miketaz100/project-scratch/14-build/electronics/CONFLICTS.md

# ELECTRONICS + FIRMWARE — CONFLICTS with SYSTEM-SPEC-v3 (proposals, not edits)

**Package:** 14-build/electronics · **Date:** 2026-10-02 · **Rule:** SYSTEM-SPEC-v3.md is not edited. Each item names the spec line, what I found, what I built, and what the owner must decide. Severity: **S1** = blocks a stage gate or a safety claim, **S2** = changes a number or a part, **S3** = wording/bookkeeping.

| ID | Sev | Spec reference | Finding | What this package does now | Decision needed (owner) |
|---|---|---|---|---|---|
| **E-C1** | **S1** | §5.1 M13 (deck stops R 48) + M14 (yoke posts R 30), §4.4 pretension 1.5 N, §4.5 amplitude ±16.5 | **The tendon geometry cannot hold the block at the rim.** With stops at R 48 and posts at R 30 the "effective anchors" (stop − post) sit on R 18, so the three cables can only hold the block with positive tension inside a triangle of inradius 9 mm. `TendonIK.audit()` finds a positive-tension reach of **9.1 mm** in the worst direction (toward the gap between two stops) and a predicted tension of **−3.9 N** (i.e. a slack cable) at the rim with the modelled 1.2 N rim reaction. The C5 lift needs |d| ≥ 13.7 in every direction. | IK and checker run on any geometry (values live in `~/sp1v3/config.json`). The scorer **audits the geometry at boot and FAULTs** if reach < 16.5 mm or predicted tension leaves 0.3–3.3 N (`geometry_audit: fault`). Unit test `test_tendons_hold_the_block_with_positive_tension_everywhere` documents the failure and two passing alternatives. | PAD + DRIVE BOX + CAD: pick a geometry that passes the audit. Passing examples: **(a) stops R 70, posts R 15, pretension 2.0 N per cable** (tension 0.39–3.10 N over the whole workspace incl. rim reaction); **(b) stops R 65, posts R 10, 2.0 N**. Alternatively crossed cables (stop at 90° to a post at 270°) give effective anchors at R 78. Re-run `python3 -c "from sp1v3.ik import *; ..."` (electronics.md §8.2) on the chosen numbers. |
| **E-C2** | **S1** | §5.4 E8, §5.5 "CB1 I²C → ADS1115", §8.5 "CB1 GPIO → REFLEX latch" | **The CB1's I²C is not reliably available on the M8P's 40-pin header.** BTT's own CB1 notes release a user I²C only as `overlays=i2c0` on PI5/PI6 "for BIGTREETECH Pi1 / CB1 eMMC"; the header pins 3/5 map to CB1 GPIOs that are not a hardware TWI (one independent test managed only bit-banged I²C with poor reliability). CB1 V2.1 GPIOs are also 1.8 V. | Tensions are read by a **$4 Raspberry Pi Pico (RP2040)** on a CB1 USB port: three Halls → GP26–28 ADC (4× averaged, 500 frames/s) → USB → `reflexd`. The Pico also drives **PICO_OK** into the latch logic (heartbeat-gated, fail-safe low). No ADS1115 is needed; if V-T5 (≤ 0.2 N resolution) fails on the RP2040 ADC, an ADS1115 goes on the Pico's own hardware I²C (GP4/GP5). | ELECTRONICS (this WP) — accept the Pico. BOM: −ADS1115 ($3), +Pico ($4). |
| **E-C3** | S2 | §4.11 "E-stop / lever / reflex latch → rail dead < 5 ms (relay drop-out)" | Panasonic SF safety relays: **release time max 20 ms** (datasheet, nominal coil voltage, no diode). After release, ACT-24 still holds ≈ 1.5 mF of driver/bulk capacitance. | K1 has a diode + 18 V Zener coil clamp (fast release) and its **NC contact switches a 4.7 Ω 5 W bleeder** across ACT-24. Analysis (electronics.md §6): rail < 4 V in **≈ 18 ms typ / ≤ 35 ms worst**; valve coils de-energised ≤ 31 ms worst; nails vented (C3) ≤ 131 ms worst; pad retracted ≤ 181 ms worst. | SYSTEM ARCHITECT: restate §4.11 as "≤ 35 ms to rail < 4 V, measured at A0" (C4's 50 ms trip criterion is unaffected: the trip itself is < 0.2 ms comparator / ≤ 9 ms reflexd). |
| **E-C4** | S2 | §8.1 "Klipper's motion queue runs up to ≈ 2 s ahead"; §8.2 step 6 + "INSTANTANEOUS_CORNER_VELOCITY raised" (V-K1) | Klipper source (toolhead.py, checked 2026-10-02): `BUFFER_TIME_HIGH = 1.0` s, so the queue is ≈ 1 s, not 2 s. With `kinematics: none` every `G1 A B C` is an **extra-axis-only move**: Klipper skips junction blending for such moves (`calc_junction` returns early), uses the max axis distance for timing (`move_d = max |Δaxis|`, duration = move_d / (F/60)) and the per-axis accel. `INSTANTANEOUS_CORNER_VELOCITY` therefore has no effect. | `printer.cfg`: `accel: 0` on the manual steppers; axes registered with `LIMIT_ACCEL=100000000 LIMIT_VELOCITY=250`, so every 5 ms segment runs at constant speed and the **host owns the velocity profile**. The streamer computes F = 60·max|Δl|/Δt; unit test checks the streamed durations add up to the plan within 1 %. Queue kept ≤ 0.5 s (unchanged). | None for the architecture (C18 holds). V-K1 at S0 now tests "no stalls, timing within 1 %" (`python3 -m sp1v3.benchtest stream`). |
| **E-C5** | S2 | §5.5 PIN A / PALM / dumps as `[output_pin]`; spec mentions `maximum_mcu_duration` on output_pin-type objects | Klipper: `[output_pin]` updates on one pin are spaced ≥ 100 ms (`MIN_SCHEDULE_TIME = 0.100`), and `maximum_mcu_duration` is now **deprecated on output_pin**; it exists on `[pwm_tool]` (max 3 s, requires start value = shutdown value). | All valves and dumps are `[pwm_tool]` with `maximum_mcu_duration: 2.0` (MCU shuts down if klippy stops refreshing). PIN B stays a 25 Hz pwm_tool. | None. |
| **E-C6** | S2 | §4.4 "VREF ≤ 0.35 A (≤ 5 N cable pull)"; §1 C15 | 17HS08-1004S: 13 N·cm at 1.0 A. At 0.35 A ≈ 4.6 N·cm → on a Ø 12 drum (r 6 mm) **≈ 7.6 N** of cable pull, not 5 N. A true 5 N cap needs ≈ 0.23 A, which leaves little margin over the drum-side tension (up to ≈ 2.6× the block-side tension through a 2π housing at μ 0.15). | VREF set for **0.35 A peak (VREF = 0.35 V on BTT TMC2209 V1.3, I_peak = VREF)** as the spec says; it is treated as a stall/heat cap. The 2.0 N magnetic coupling remains the tangential cap. | SYSTEM ARCHITECT: change the wording to "VREF 0.35 A ≈ 7.6 N at the drum (stall cap)" or ask DRIVE BOX for a larger drum. |
| **E-C7** | S2 | §5.4 E5 "helmet loop 3.3 V, 1 mA logic loop … gates the rail relay" | A 3.3 V logic loop needs an active element (transistor/opto) between the loop and K1's coil; a shorted transistor would silently bypass the loop. | The helmet loop (lanyard pogo + head-present switch) is **wired directly in K1's 24 V coil chain** (≈ 15 mA + 2 mA sense). Passive, fail-open, no semiconductor. 24 V DC is within red line 5. Nothing on the head draws power (only a switch). | HALO: pogo pins and head switch rated ≥ 50 mA at 24 V DC (all listed parts are). SYSTEM ARCHITECT: update E5 text. |
| **E-C8** | S2 | §5.4 E10/E9; §7.8 "Host (CB1) hang → maximum_mcu_duration … ≤ 1 s" | `maximum_mcu_duration` only catches a dead **klippy**; Klipper keeps refreshing the PWM if only `scorer.py` hangs. | Added a **host heartbeat**: `SP1_HEARTBEAT` every 0.25 s re-arms a `[delayed_gcode]` that runs **M112** after 1 s. Scorer hang → M112 → MCU shutdown → watchdog PWM stops → rail open ≤ 1.3 s. reflexd hang → Pico drops PICO_OK after 250 ms → latch sets. MCU hang → STM32 IWDG reset (~0.5 s) → pin low → charge pump decays ≤ 45 ms. | SYSTEM ARCHITECT: §7.8 host-hang bound ≤ 1.3 s. |
| **E-C9** | S2 | §4.5 CIRCLE "R 9–13" with "R + e ≥ 14.5 and R − e ≤ 8.5" and §8.3 "|d| > 16.5 rejected" | R = 13 needs e ≥ 4.5 (to land) but then R + e = 17.5 > 16.5 mm: **no valid circle at R 13**. Also the 30°/50 ms heading rule caps circles at **f ≤ 1.5 Hz** (precession adds to the turn rate). | Limits: R 9–12.5, f_circle ≤ 1.5 Hz; planner clamps e to [max(3, R−8.5, 14.5−R), 16.5−R]. Checker rejects the R 13 circle (unit test). | SYSTEM ARCHITECT: update §4.5 ranges. |
| **E-C10** | S2 | §5.4 E7 "GX12 8-pin" | GX12 aviation connectors are commonly 2–7 pin (8-pin listings are rare and inconsistent); GX16 is stocked in 2–10 pins. | Hand controller on **GX16-8** (10-pack $17.99). E-stop and helmet loop stay GX12-4. | BOM: update. |
| **E-C11** | S2 | §5.5 resource map (pumps on FAN0/FAN1, dumps on HE3/HB, MODE on ADS1115 ch 3, knobs on "spare TH via ADC expansion") | I own this map. Revised for current ratings and pin reality: pumps on **HE3** (5.5 A) and **FAN3** (1 A, palm pump ≤ 0.8 A); dumps on **FAN0/FAN1**; HB unused (its flyback diode returns to the BED IN rail); knobs on the **FWS header ADCs PC0/PF10**; MODE as a 4-step resistor ladder on **TB (PB1)** read by four analog `gcode_button`s; chime on a logic GPIO (PC12) so it sounds with the rail off. Closes V-E3. | electronics.md §4 is the new map. Pad-2 provisions: FAN4 = PALM B valve, HB = PALM B dump (feed BED IN from ACT-12 at install), S_palm B on an ADS1115 at the Pico. | None (FYI DRIVE BOX: palm pump ≤ 0.8 A at 12 V). |
| **E-C12** | **S1** (wiring hazard) | §7.1 "Nothing in the logic domain can energise ACT-24: the M8P only sinks the − side" | True only if (a) no load is ever wired to an HE "+" terminal (that pin is **VBB, unswitched 24 V**), and (b) every FAN output used for an ACT-12 load has its **VFAN jumper on VIN (24 V)**: each FAN output has an on-board flyback diode from the MOSFET drain to VFAN; with VFAN at 5 V a 12 V valve would be half-energised through that diode with the rail off. | Wiring table marks every "+" pin "DO NOT USE — tape over"; bring-up step A0-7 "dead-rail output test" (all outputs commanded ON with the lever released: every load terminal must read 0 V) is a hard gate. FAN2 (watchdog) VFAN jumper = 12 V. | TEST PROTOCOLS: add A0-7 to the A0 sheet. |
| **E-C13** | S3 | §7.1 weld check "rail must fall within 50 ms of every lever release" | The Klipper status stream updates ≈ 4×/s, so a 50 ms software timing check is not meaningful. | Weld check = **force-guided NC contact state**: K1's NC aux must read closed whenever the coil is off (SELFTEST, SAFE, PAUSED) and the rail must not be up while the lever or e-stop sense is open (> 150 ms → FAULT, "press the E-STOP"). The 50 ms timing is measured once at A0 with the logic analyser. | TEST PROTOCOLS: A0 sheet. |
| **E-C14** | S3 | §5.4 E9 latch "SET by any comparator or by CB1 GPIO" | — | Latch SET (74HC74 /PRE) is a wired-AND of: 6 LM393 window outputs (3 cables × slack/over) + **M8P_OK low** (scorer FAULT, Klipper shutdown, boot) + **PICO_OK low** (reflexd trip/heartbeat loss, Pico dead). The box cannot arm unless both host services are alive and agree. Power-up state is tripped. | None. |
| **E-C15** | S3 | §4.4 comparator "ΔT > +1.8 N or < −1.2 N from pretension" | With any geometry that passes E-C1 the predicted operating tensions span ≈ 0.4–3.1 N; a relative window around 1.5 N would trip on the rim. | Absolute window **0.2 N (slack) … 3.6 N**, set per channel on trimpots after the A3 tension calibration; reflexd duplicates it in firmware. Re-derive from `ik.audit()` once E-C1 is settled. | DRIVE BOX/ELECTRONICS at A3. |
| **E-C16** | S3 | §8.2 "host keeps ≤ 0.5 s of moves queued", §4.11 "score change → motion ≤ 0.5 s" | CIRCLE tokens are 2 revolutions (≈ 1.7–2.5 s) because each token starts and ends at rest on the rim. | Mode/knob changes apply at the next token boundary: ≤ 0.5 s in PLINE/LINE/CHORD/D-PATH, ≤ 2.5 s in CIRCLE. | None (accept), or shorten circle tokens to 1 rev (an extra rim stop per rev). |
| **E-C17** | S3 | §2.1 "ADS1115 for the three cable tensions" in the drive-box list and §13 cost line | See E-C2. | Cost line: Pico $4 replaces ADS1115 $3; safety board (optos, LM393 ×4, 74HC74, 2N7000 ×3, bleeder) ≈ $15 [est]. | BOM. |

## Verified facts this package relied on (closing V-items)

| V-item | Result | Source |
|---|---|---|
| V-E1 M8P motor-power input | **Closed.** Separate "Motor Power" terminal = HV input; each driver socket has a 3-pin **HV / VM / VBB** jumper selecting its supply. Jumper motors 1–3 to **HV**, leave sockets 4–8 empty with no jumper. Driver input "24V, HV (24–60V) Selectable". | BTT M8P V2.0 pin-out PNG and user manual (GitHub bigtreetech/Manta-M8P, V2.0) |
| V-E2 low-side outputs | **Closed with a caveat (E-C12).** HE0–3: N-MOSFET (AP65N06NF) source to GND, connector pin 1 = VBB, pin 2 = drain, SS54 flyback drain→VBB. FAN0–4: ES3400 N-MOSFET, + pin = VFAN (5/12/24 V jumper). Common ground required (it is). | M8P V2.0 schematic PDF (same repo) |
| V-E3 ADC count | **Closed.** TH0–TH3 + TB (5) + FWS PC0/PF10 (2) = 7 ADCs: 4 pressures, 2 knobs, MODE ladder. | BTT generic-bigtreetech-manta-m8p-V2_0.cfg (`hall_filament_width_sensor adc1: PC0, adc2: PF10`), pin-out PNG |
| V-E4 CB1 GPIO / I²C | **Closed negatively → E-C2.** | BTT CB1 readme (overlays `i2c0` on PI5/PI6), learningtopi CB1 notes |
| V-K1 GCODE_AXIS with kinematics none | Feature exists and is documented; timing semantics from source (E-C4). Bench test still required at S0. | Klipper G-Codes.md `MANUAL_STEPPER … GCODE_AXIS`; toolhead.py, manual_stepper.py (master, 2026-10-02) |
| V-K3 maximum_mcu_duration | pwm_tool only, 0.5–3.0 s, start = shutdown value; MCU shuts down if not refreshed. Bench test at A0 still required. | Config_Reference.md `[pwm_tool]`; pwm_tool.py, mcu.py (`MAX_NOMINAL_DURATION = 3.0`) |
