miketaz100/project-scratch/14-build/pad/cad/pad_geom_report2.txt

=== 4. DOME POCKETS (ZD = 91.5 mm ball centre, RD 38.0, ball 0 6.35) ===
 max dome travel 27.96 mm (cage |d| 18.0); pocket radius incl. ball 31.13; half spacing 32.91; spare 1.77 mm
 steepest ceiling slope on any dome path 48.1 deg -> rim reaction <= 1.11 x vertical dome load
 ceiling z range 92.96 .. 105.30 (home ball top 94.67)
 min block-feature-to-ceiling gap +1.87 mm at pose (-16.7, 3.0, 1) (target >= 1.5)
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
