miketaz100/project-scratch/14-build/halo/cad/stl/_assembly_preview.stl

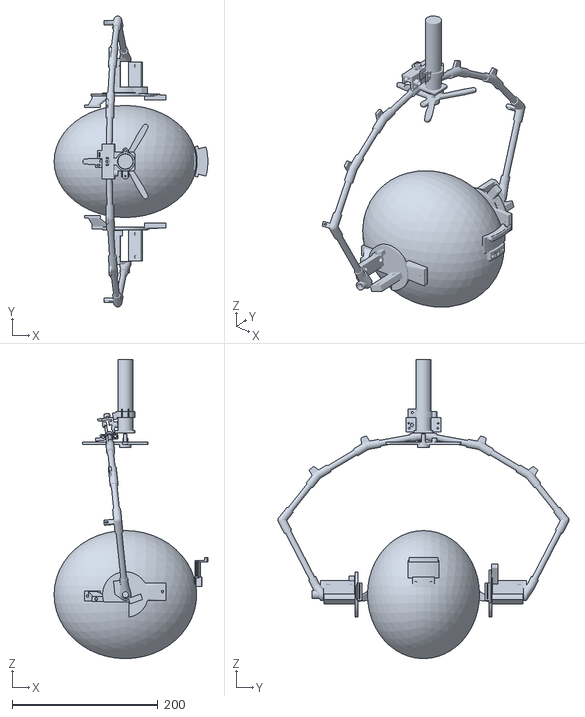
[picture p1: CAD file, 2026-10-02]
14-build/halo/cad/stl/_assembly_preview.stl
211.4 x 399.9 x 411.2
