miketaz100/project-scratch/05-engineering/cad/frame/stl/p46_tip_pull_clip.stl

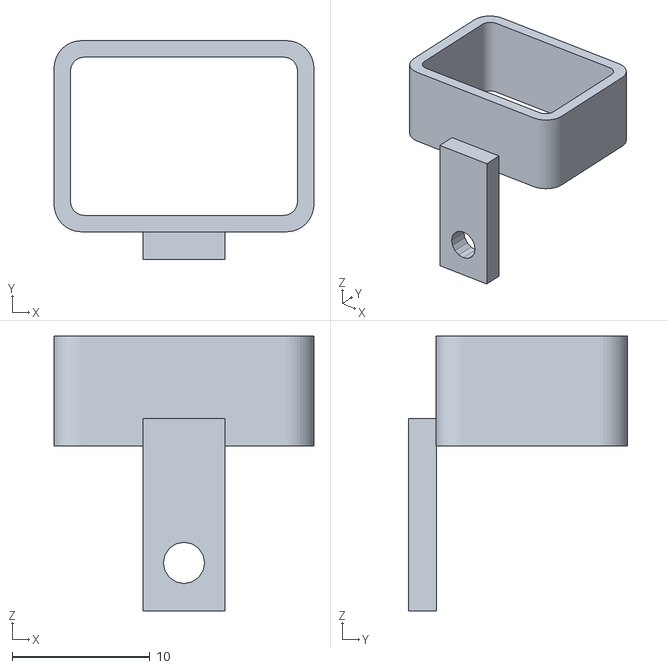
[picture p2: CAD file, 2026-10-01]
05-engineering/cad/frame/stl/p46_tip_pull_clip.stl
18.9 x 15.9 x 20.0
