miketaz100/project-scratch/05-engineering/cad/tips/stl/tm1_seam_sleeve.stl

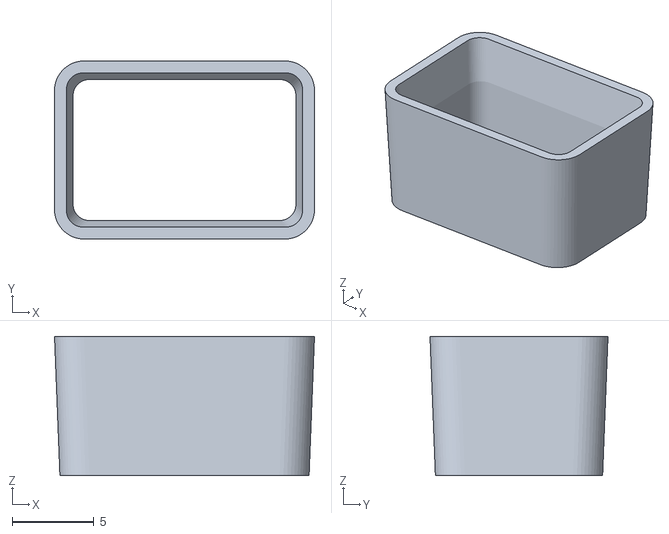
[picture p3: CAD file, 2026-10-01]
05-engineering/cad/tips/stl/tm1_seam_sleeve.stl
15.9 x 10.9 x 8.50
