miketaz100/project-scratch/14-build/drivebox/cad/stl/DB06_bulkhead.stl

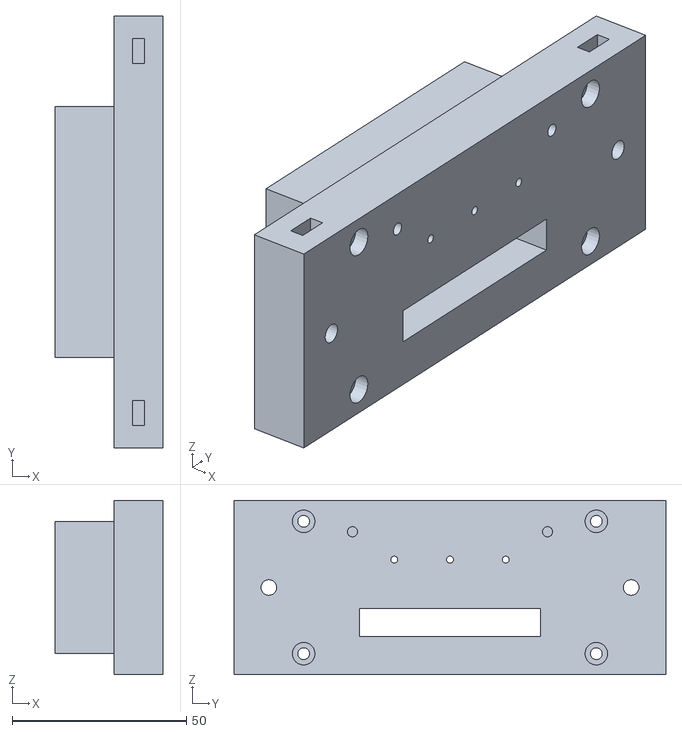
[picture p4: CAD file, 2026-10-02]
14-build/drivebox/cad/stl/DB06_bulkhead.stl
31.0 x 124.0 x 50.0
