miketaz100/project-scratch/14-build/halo/cad/stl/H17_exit_clamp.stl

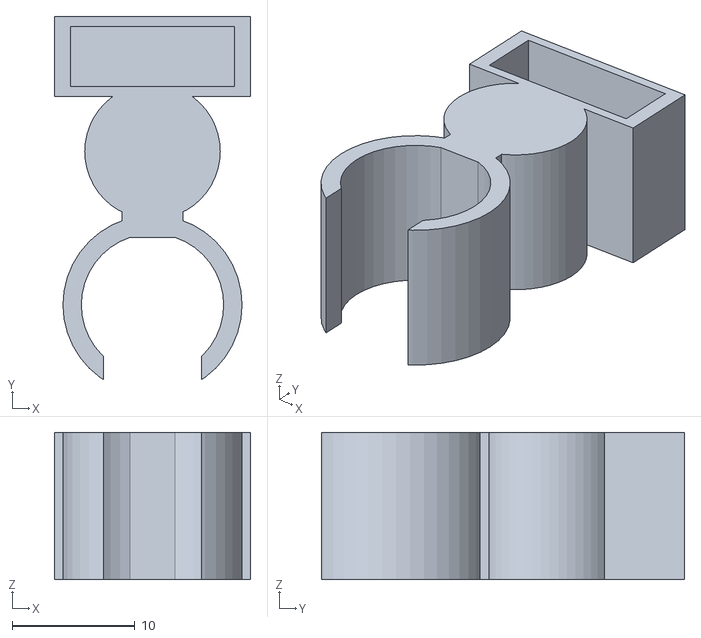
[picture p5: CAD file, 2026-10-02]
14-build/halo/cad/stl/H17_exit_clamp.stl
16.0 x 29.6 x 12.0
