miketaz100/project-scratch/14-build/halo/cad/stl/variant_small_hinge/H01R_hub_plate.stl

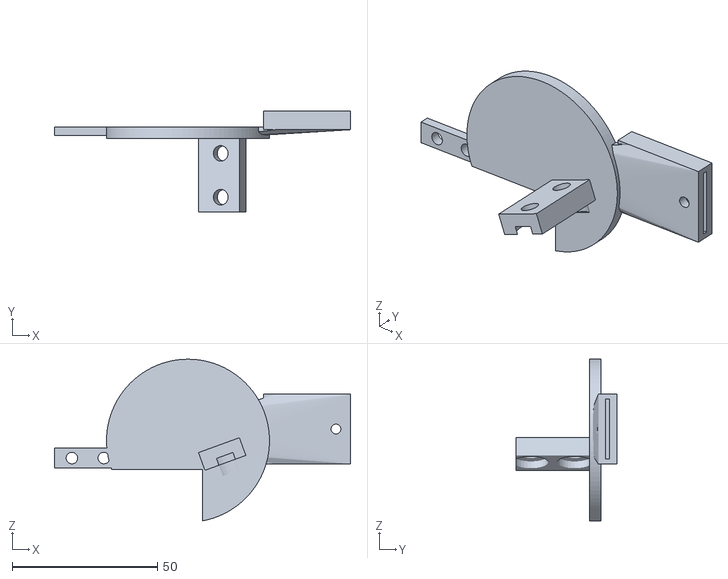
[picture p6: CAD file, 2026-10-02]
14-build/halo/cad/stl/variant_small_hinge/H01R_hub_plate.stl
102.0 x 34.9 x 55.7
