miketaz100/project-scratch/14-build/pad/cad/stl/PD01_deck.stl

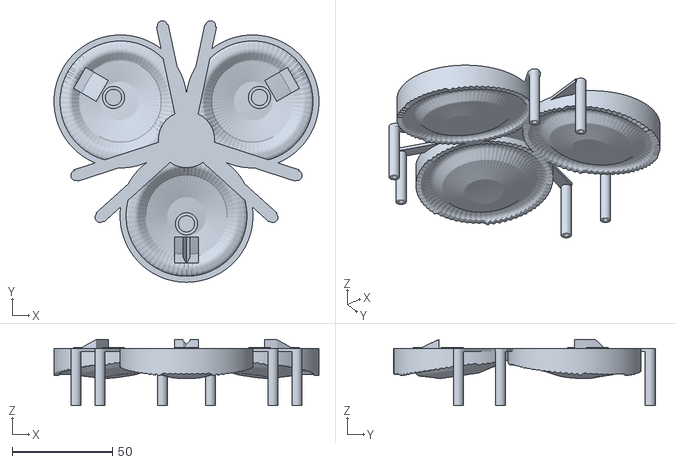
[picture p7: CAD file, 2026-10-02]
14-build/pad/cad/stl/PD01_deck.stl
132.1 x 130.4 x 33.0
