miketaz100/project-scratch/14-build/S0/cad/stl/D25_V2_template_T2_dpath.stl

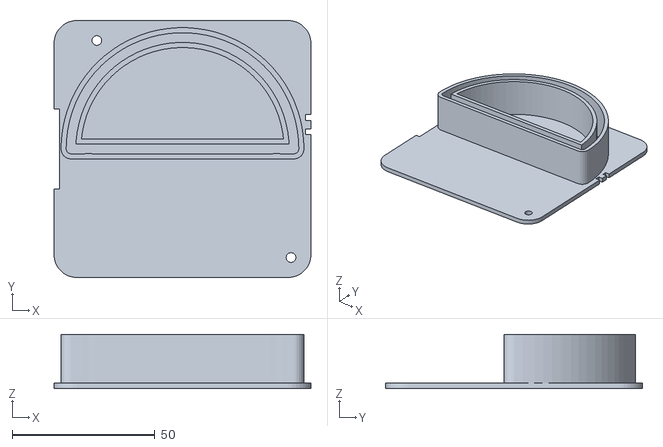
[picture p8: CAD file, 2026-10-02]
14-build/S0/cad/stl/D25_V2_template_T2_dpath.stl
90.0 x 90.0 x 19.0
