miketaz100/project-scratch/05-engineering/cad/frame/stl/p32_palm_tray.stl

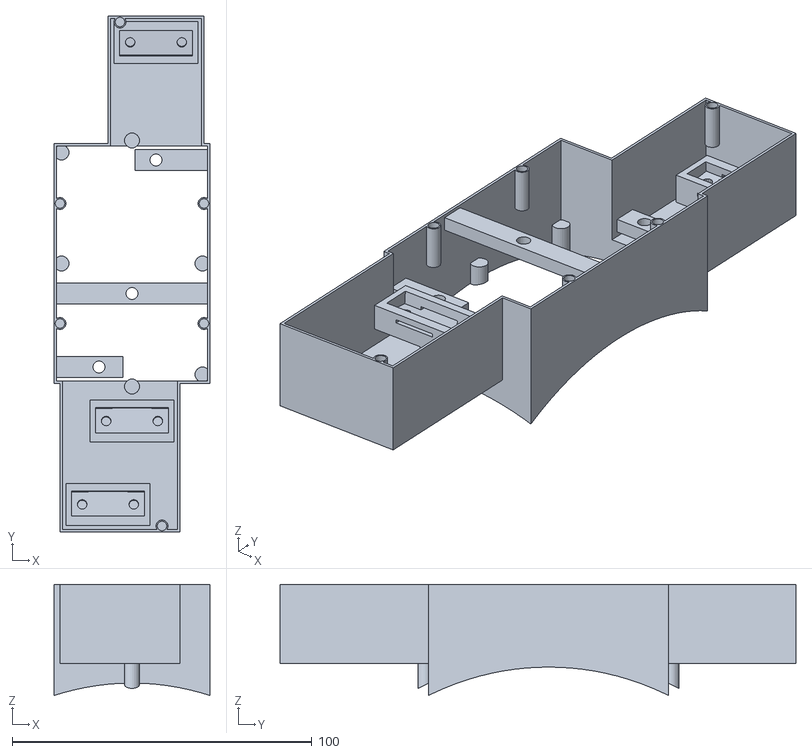
[picture p9: CAD file, 2026-10-01]
05-engineering/cad/frame/stl/p32_palm_tray.stl
52.0 x 172.0 x 37.1
