miketaz100/project-scratch/05-engineering/cad/tips/stl/paddle_with_pocket.stl

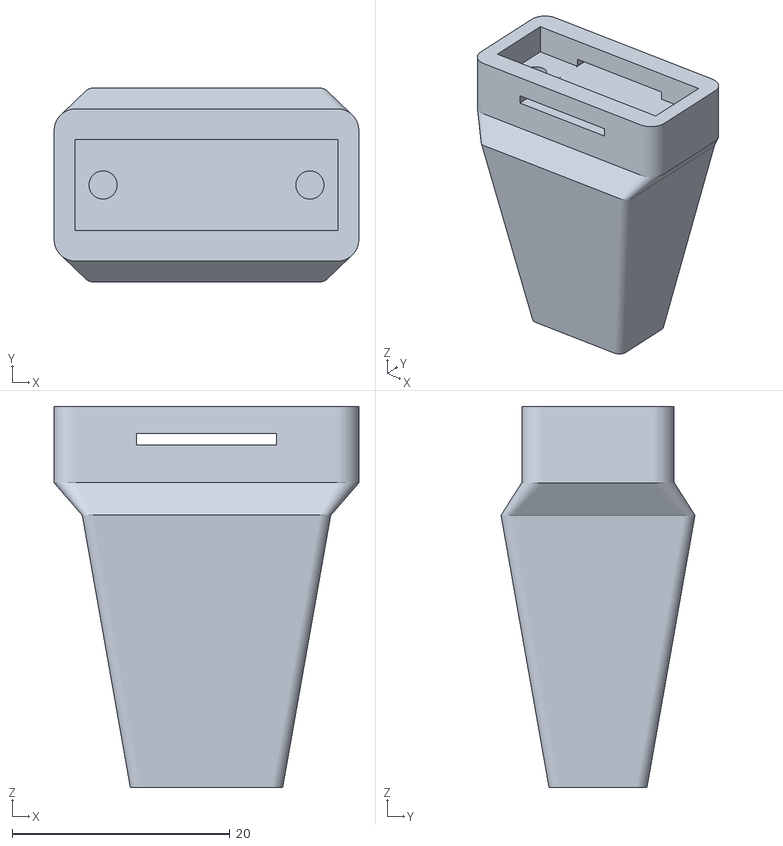
[picture p10: CAD file, 2026-10-01]
05-engineering/cad/tips/stl/paddle_with_pocket.stl
28.0 x 17.8 x 35.0
