miketaz100/project-scratch/14-build/drivebox/cad/stl/DB08_inner_clamp.stl

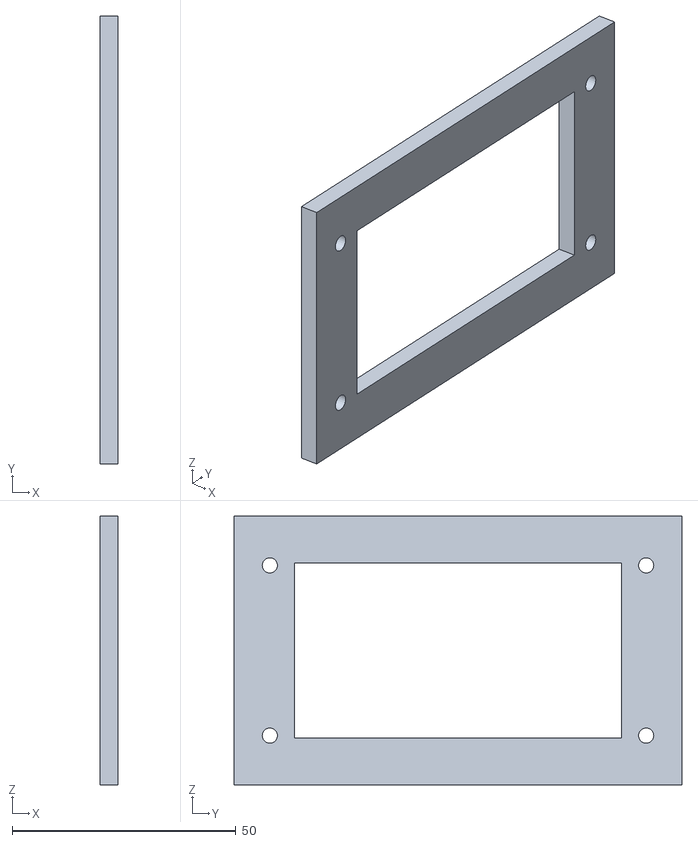
[picture p11: CAD file, 2026-10-02]
14-build/drivebox/cad/stl/DB08_inner_clamp.stl
4.00 x 100.0 x 60.0
