miketaz100/project-scratch/14-build/halo/cad/stl/H20_notch_jig.stl

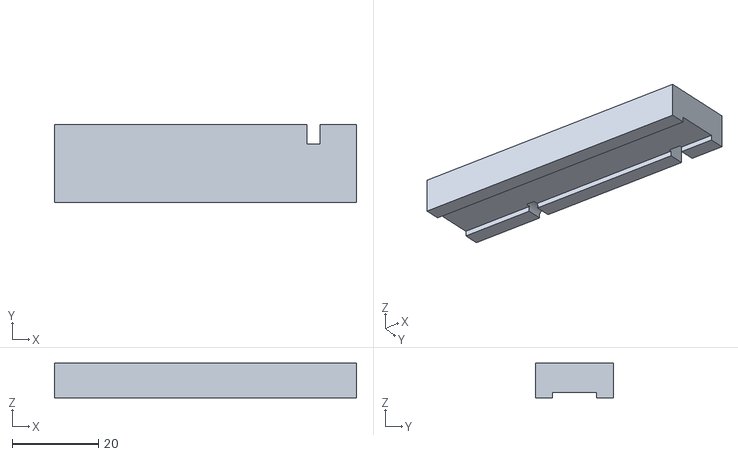
[picture p12: CAD file, 2026-10-02]
14-build/halo/cad/stl/H20_notch_jig.stl
70.0 x 18.0 x 8.00
