miketaz100/project-scratch/14-build/halo/cad/stl/variant_small_hinge/H04L_foot_left.stl

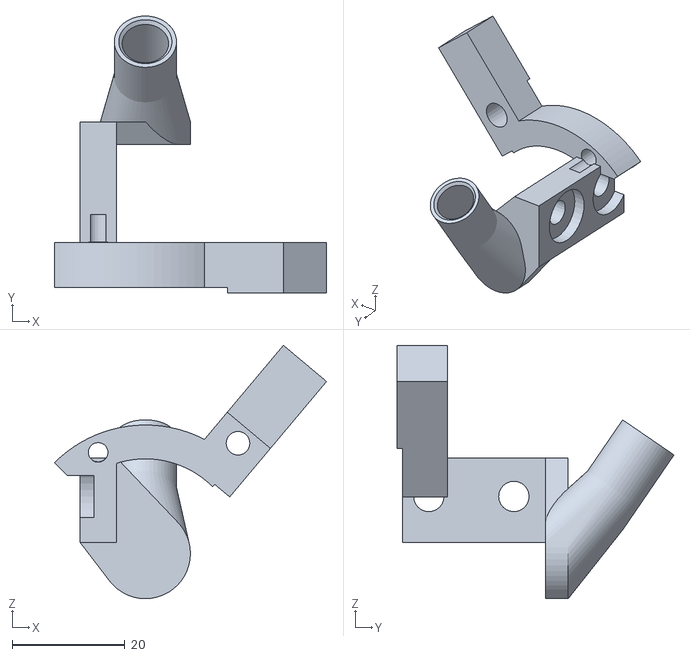
[picture p13: CAD file, 2026-10-02]
14-build/halo/cad/stl/variant_small_hinge/H04L_foot_left.stl
48.3 x 49.2 x 45.0
