miketaz100/project-scratch/14-build/pad/cad/stl/PD05_floor_plate.stl

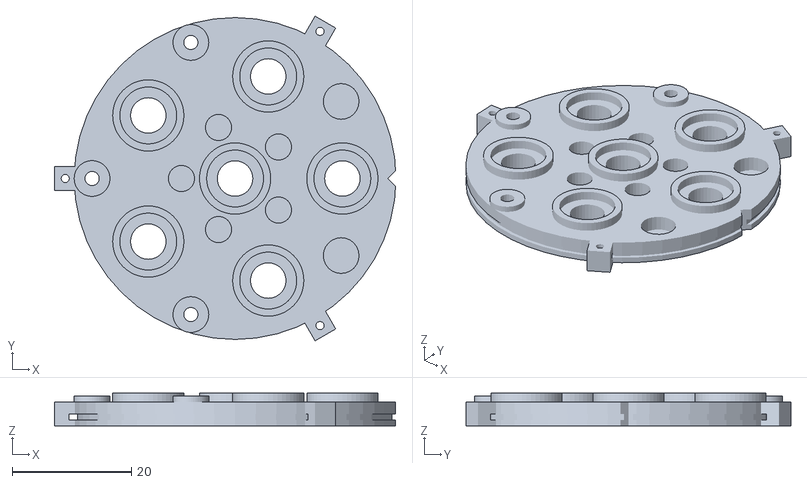
[picture p14: CAD file, 2026-10-02]
14-build/pad/cad/stl/PD05_floor_plate.stl
57.2 x 54.5 x 5.50
