miketaz100/project-scratch/14-build/S0/cad/stl/D21_V2_dish_deck.stl

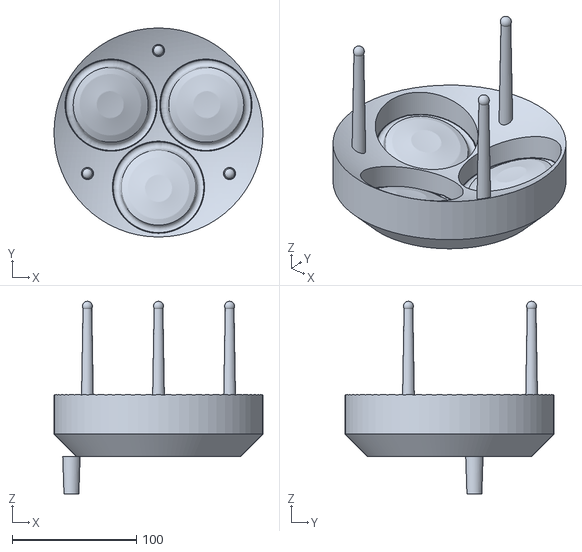
[picture p15: CAD file, 2026-10-02]
14-build/S0/cad/stl/D21_V2_dish_deck.stl
168.0 x 168.0 x 154.8
