miketaz100/project-scratch/05-engineering/cad/frame/stl/p05_frame_hinge_knuckle.stl

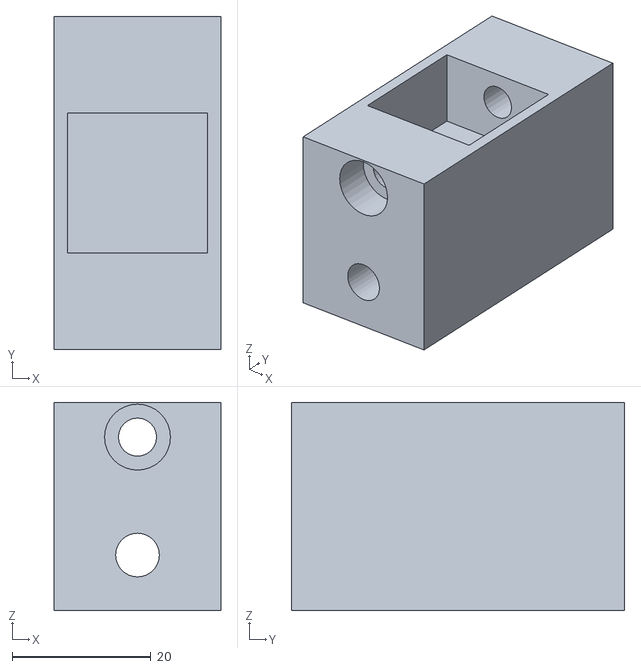
[picture p16: CAD file, 2026-10-01]
05-engineering/cad/frame/stl/p05_frame_hinge_knuckle.stl
24.0 x 48.0 x 30.0
