miketaz100/project-scratch/14-build/drivebox/cad/stl/DB07_plug.stl

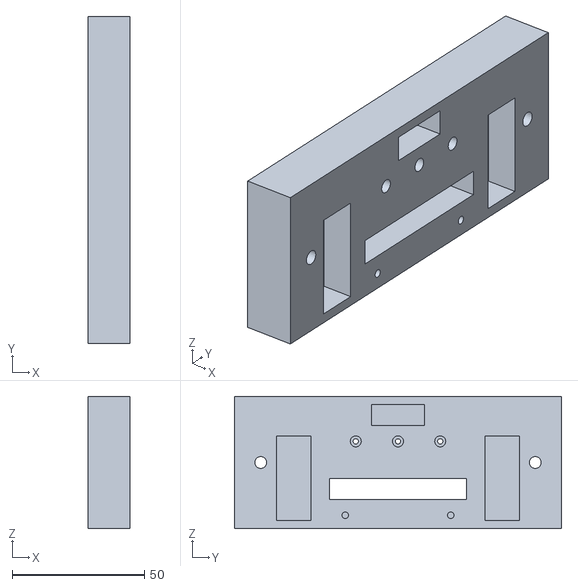
[picture p18: CAD file, 2026-10-02]
14-build/drivebox/cad/stl/DB07_plug.stl
16.0 x 124.0 x 50.0
