miketaz100/project-scratch/14-build/halo/cad/stl/H08b_vertex_half.stl

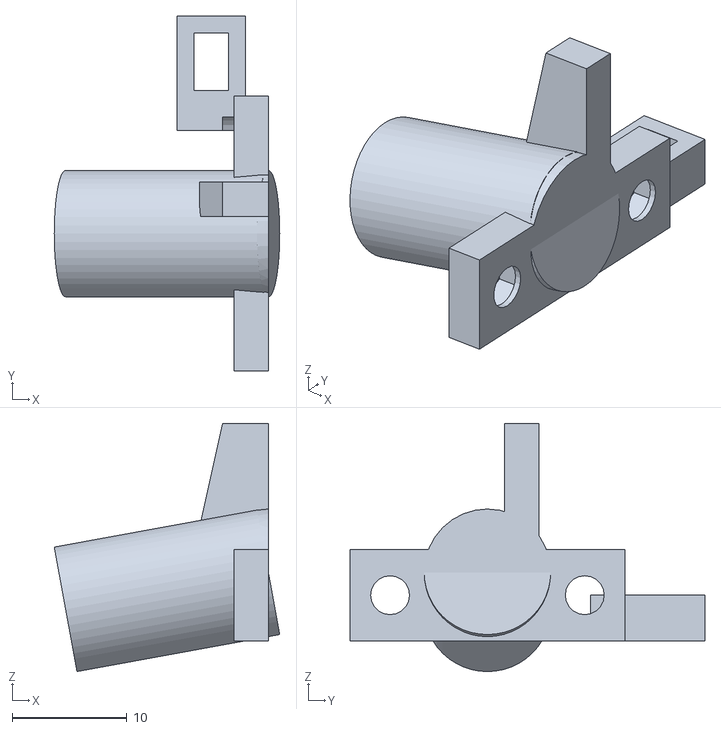
[picture p19: CAD file, 2026-10-02]
14-build/halo/cad/stl/H08b_vertex_half.stl
19.7 x 31.0 x 21.7
