miketaz100/project-scratch/14-build/pad/cad/stl/PD14_skid_knob.stl

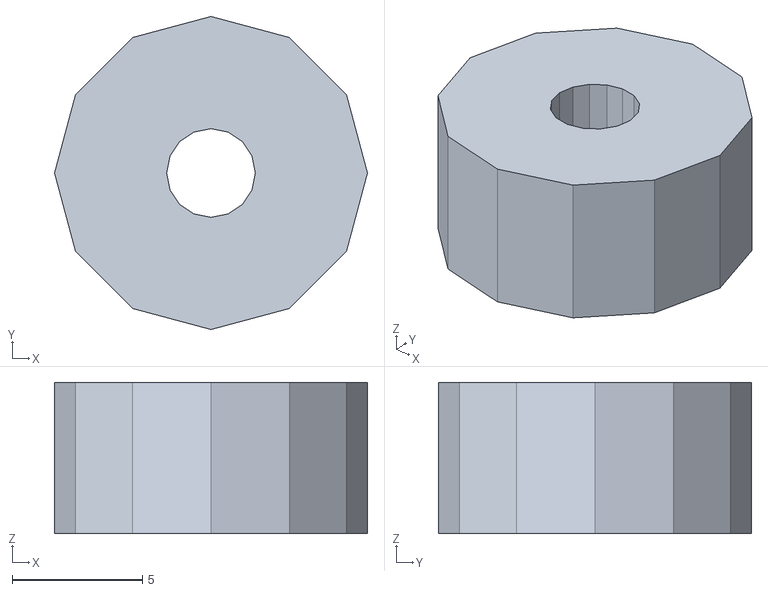
[picture p21: CAD file, 2026-10-02]
14-build/pad/cad/stl/PD14_skid_knob.stl
12.0 x 12.0 x 5.80
