miketaz100/project-scratch/14-build/S0/cad/stl/D24_V2_template_T1_line_star.stl

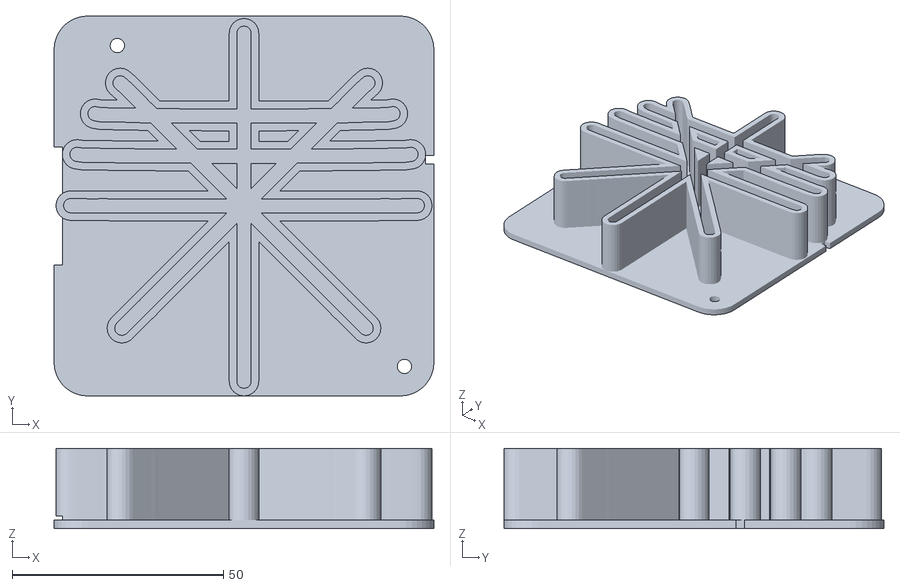
[picture p22: CAD file, 2026-10-02]
14-build/S0/cad/stl/D24_V2_template_T1_line_star.stl
90.0 x 90.0 x 19.0
