miketaz100/project-scratch/05-engineering/cad/frame/stl/p45_reset_cord_guide.stl

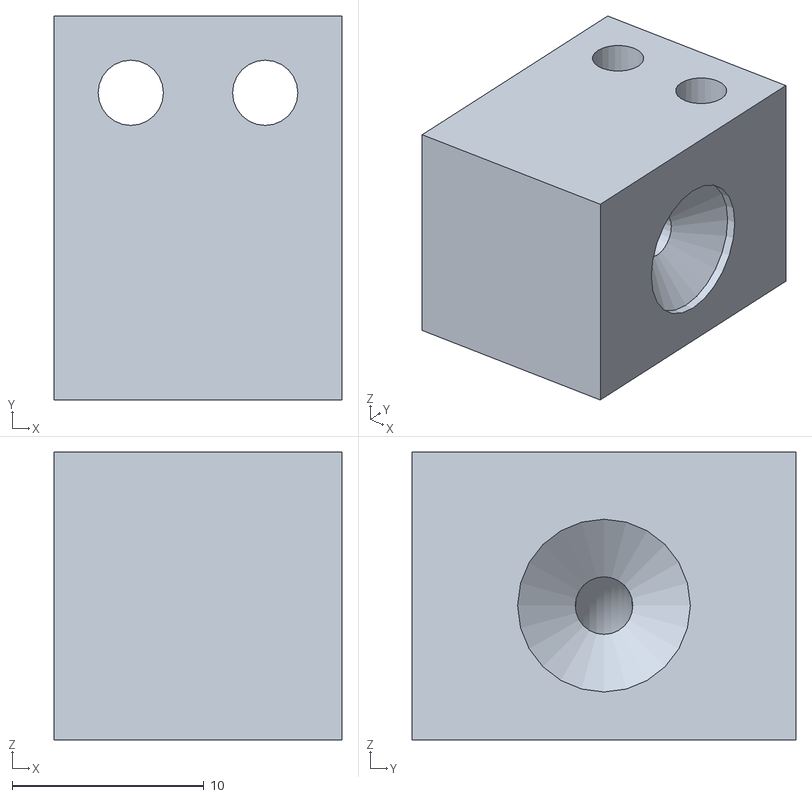
[picture p23: CAD file, 2026-10-01]
05-engineering/cad/frame/stl/p45_reset_cord_guide.stl
15.0 x 20.0 x 15.0
