miketaz100/project-scratch/05-engineering/cad/tips/stl/tip_W.stl

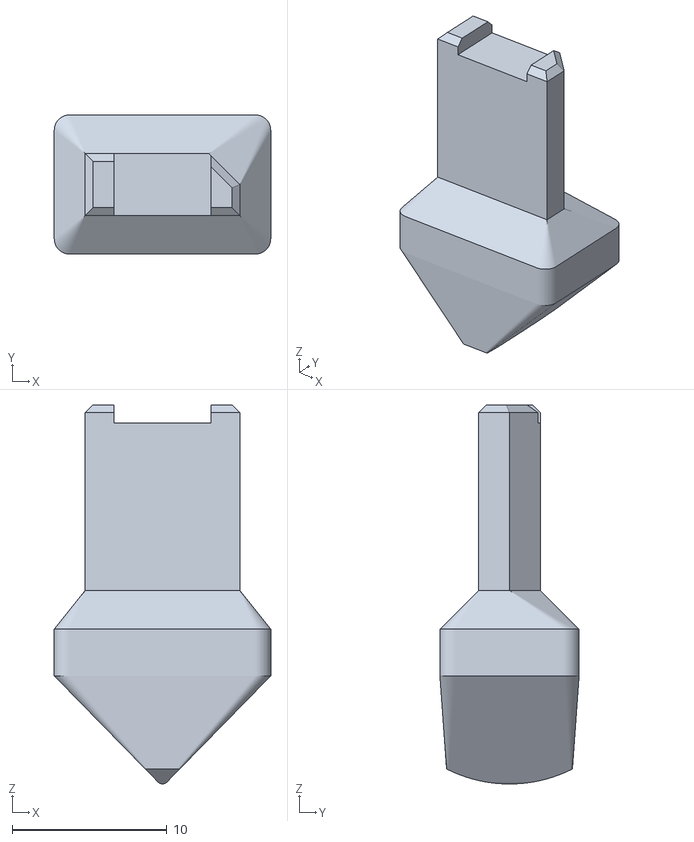
[picture p24: CAD file, 2026-10-01]
05-engineering/cad/tips/stl/tip_W.stl
14.0 x 9.00 x 24.5
