miketaz100/project-scratch/14-build/drivebox/cad/stl/DB15_hanger_seat.stl

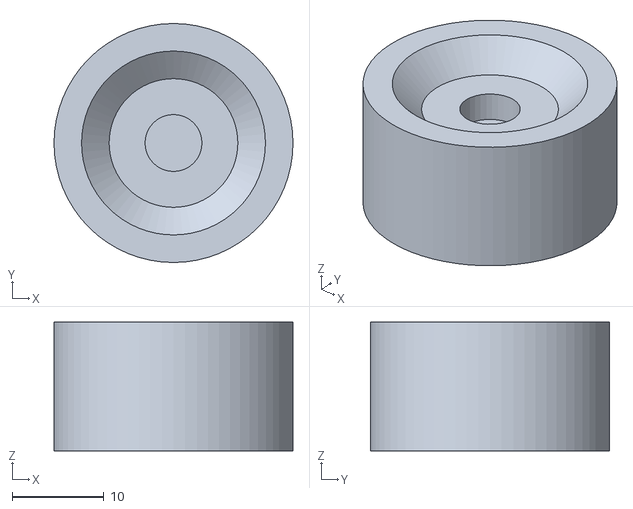
[picture p25: CAD file, 2026-10-02]
14-build/drivebox/cad/stl/DB15_hanger_seat.stl
26.0 x 26.0 x 14.0
