miketaz100/project-scratch/14-build/halo/cad/stl/H09R_shoulder_node.stl

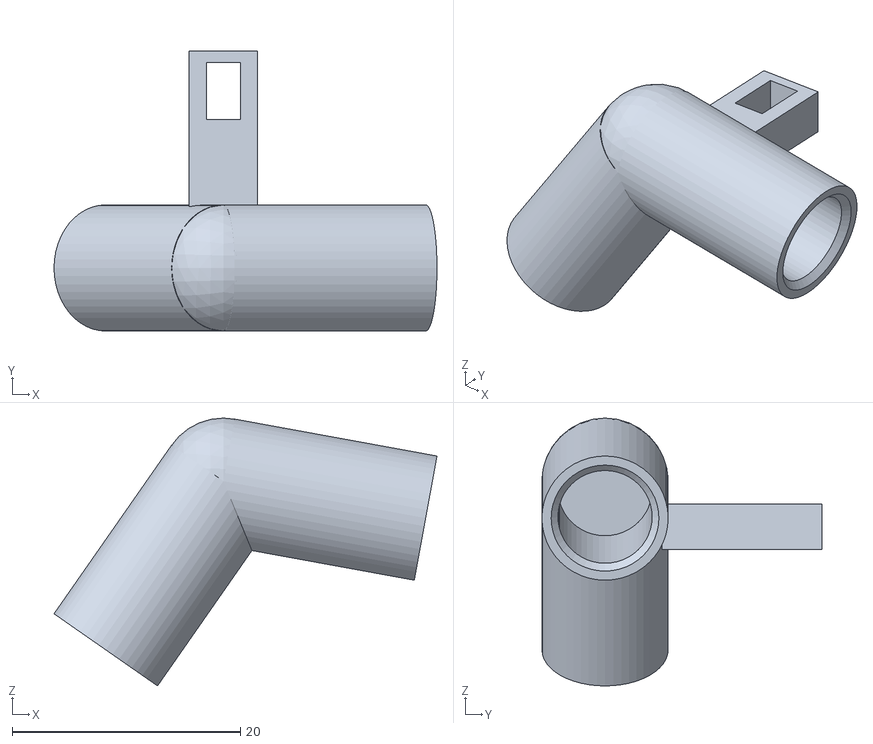
[picture p26: CAD file, 2026-10-02]
14-build/halo/cad/stl/H09R_shoulder_node.stl
33.5 x 24.5 x 23.4
