miketaz100/project-scratch/14-build/halo/cad/stl/variant_small_hinge/H05R_foot_right.stl

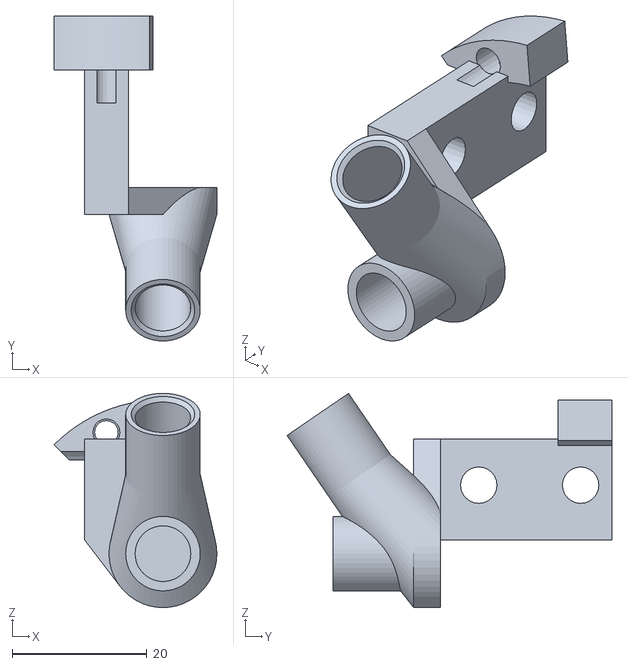
[picture p27: CAD file, 2026-10-02]
14-build/halo/cad/stl/variant_small_hinge/H05R_foot_right.stl
24.1 x 48.2 x 31.8
