miketaz100/project-scratch/14-build/pad/cad/stl/PD08_skirt_plate.stl

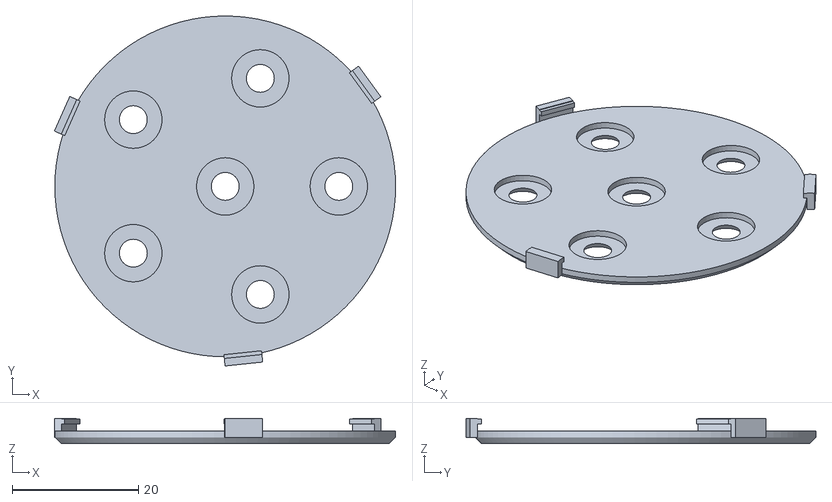
[picture p28: CAD file, 2026-10-02]
14-build/pad/cad/stl/PD08_skirt_plate.stl
54.1 x 55.5 x 4.00
