miketaz100/project-scratch/14-build/S0/cad/stl/D22_V2_block.stl

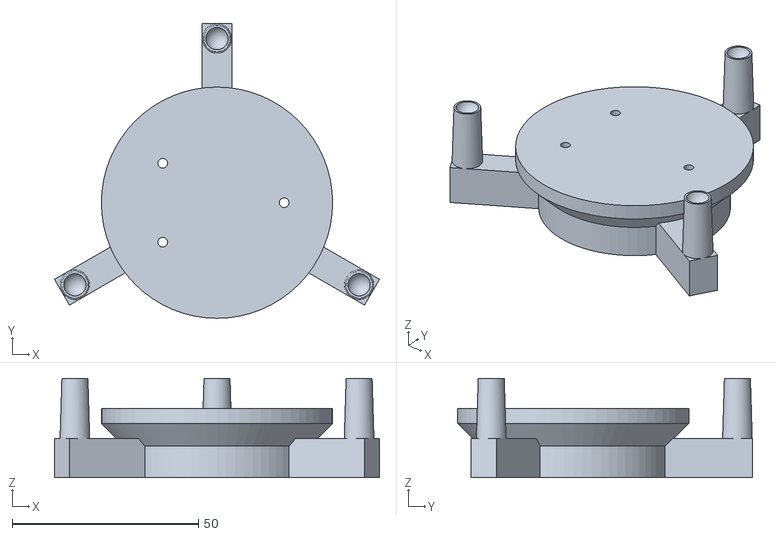
[picture p29: CAD file, 2026-10-02]
14-build/S0/cad/stl/D22_V2_block.stl
87.1 x 79.0 x 26.6
