miketaz100/project-scratch/05-engineering/cad/frame/stl/p31_boot_clamp_frame.stl

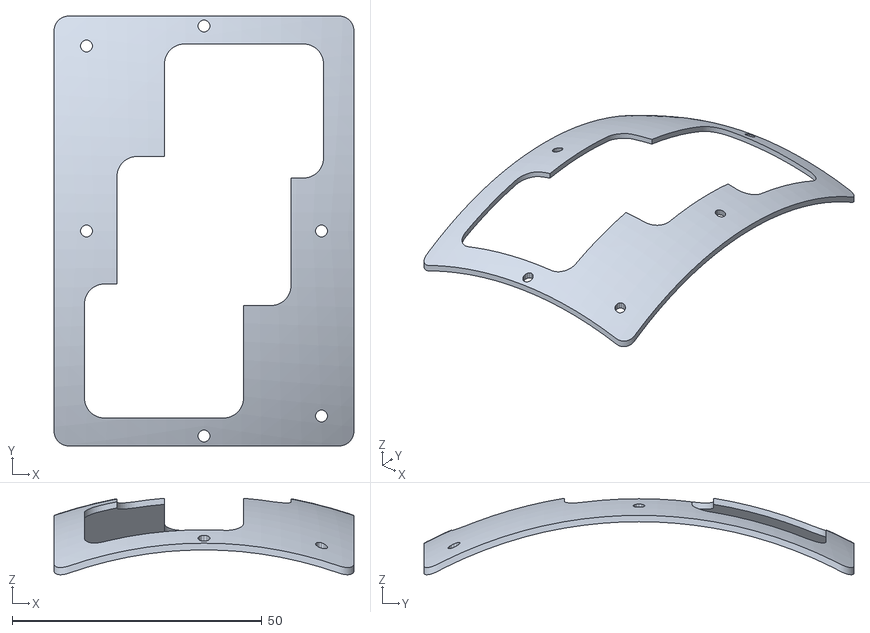
[picture p30: CAD file, 2026-10-01]
05-engineering/cad/frame/stl/p31_boot_clamp_frame.stl
60.0 x 86.0 x 15.3
