miketaz100/project-scratch/05-engineering/cad/tips/stl/tip_B45_12.stl

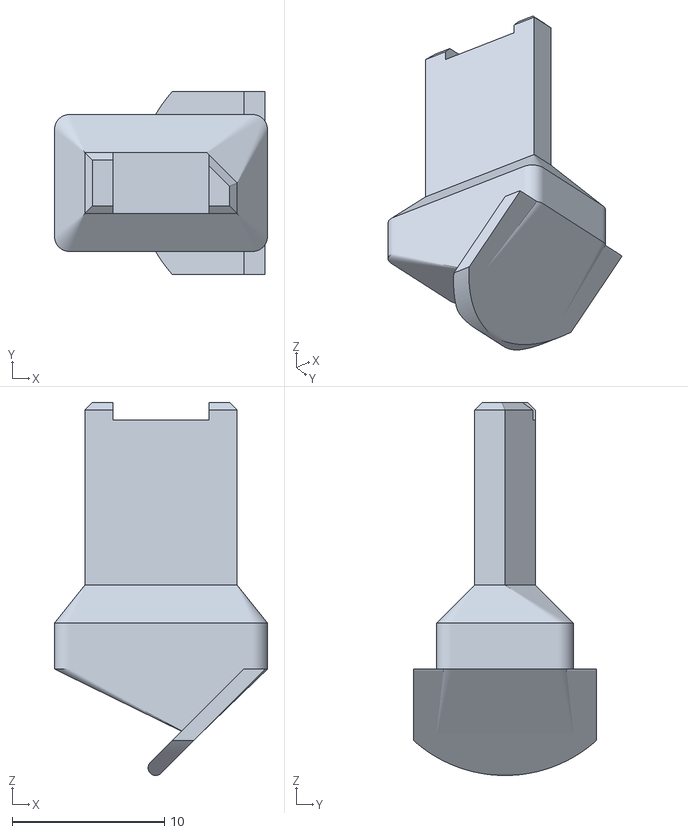
[picture p31: CAD file, 2026-10-01]
05-engineering/cad/tips/stl/tip_B45_12.stl
14.0 x 12.0 x 24.5
