miketaz100/project-scratch/14-build/drivebox/cad/stl/DB10_hook_30.stl

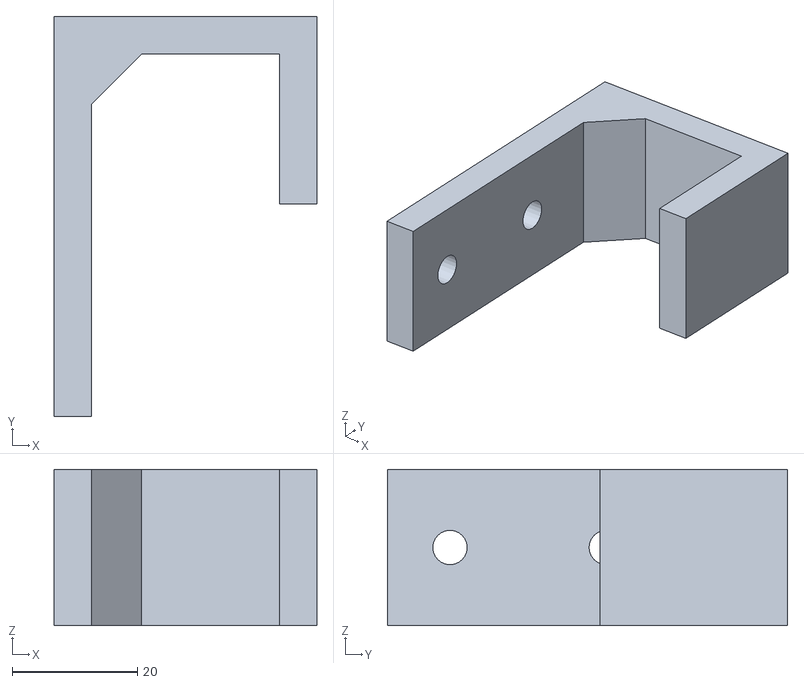
[picture p32: CAD file, 2026-10-02]
14-build/drivebox/cad/stl/DB10_hook_30.stl
42.0 x 64.0 x 25.0
