miketaz100/project-scratch/14-build/pad/cad/stl/PD19_s0_pocket.stl

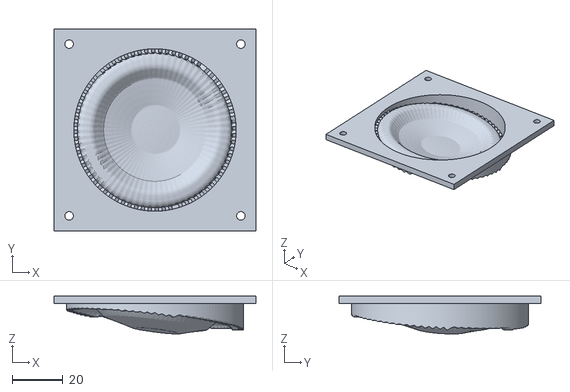
[picture p34: CAD file, 2026-10-02]
14-build/pad/cad/stl/PD19_s0_pocket.stl
80.0 x 80.0 x 15.0
