miketaz100/project-scratch/14-build/S0/cad/stl/D18_nail_N55_reserve5p5.stl

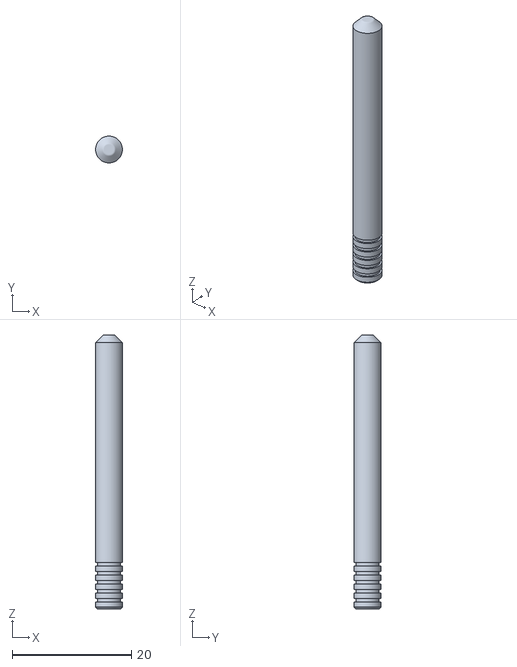
[picture p35: CAD file, 2026-10-02]
14-build/S0/cad/stl/D18_nail_N55_reserve5p5.stl
4.50 x 4.50 x 45.9
