miketaz100/project-scratch/05-engineering/cad/frame/stl/p15_idler_housing.stl

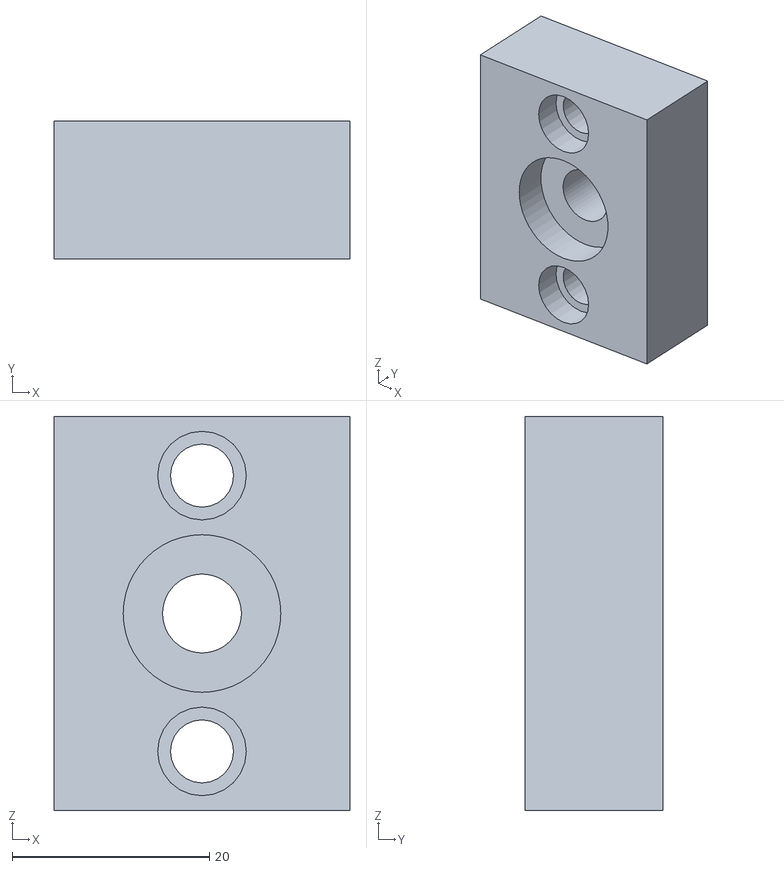
[picture p36: CAD file, 2026-10-01]
05-engineering/cad/frame/stl/p15_idler_housing.stl
30.0 x 14.0 x 40.0
