miketaz100/project-scratch/05-engineering/cad/tips/stl/tip_E_pad.stl

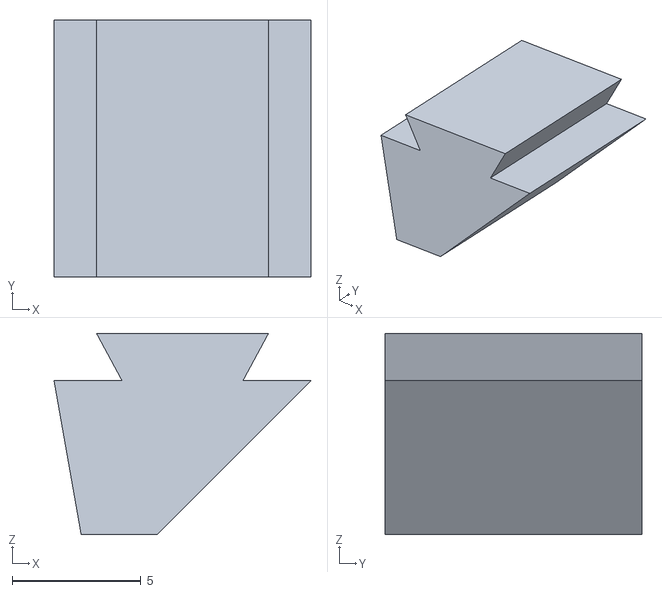
[picture p37: CAD file, 2026-10-01]
05-engineering/cad/tips/stl/tip_E_pad.stl
10.0 x 10.0 x 7.84
