miketaz100/project-scratch/14-build/drivebox/cad/stl/DB16b_clip_plain.stl

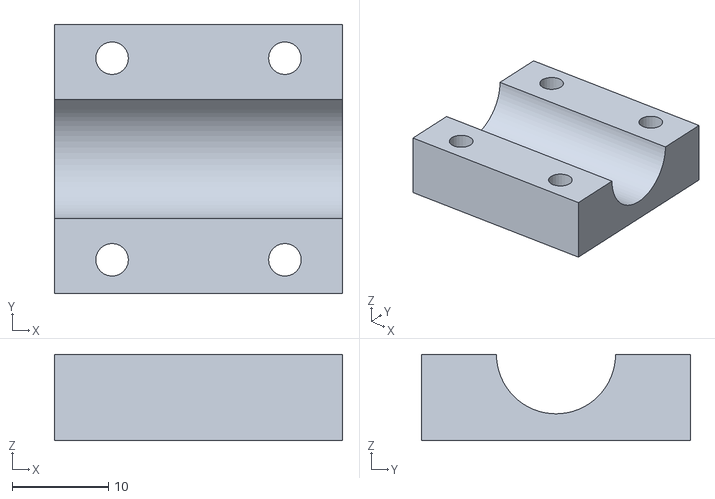
[picture p38: CAD file, 2026-10-02]
14-build/drivebox/cad/stl/DB16b_clip_plain.stl
30.0 x 28.0 x 9.00
