miketaz100/project-scratch/14-build/halo/cad/stl/H15L_cradle_arm.stl

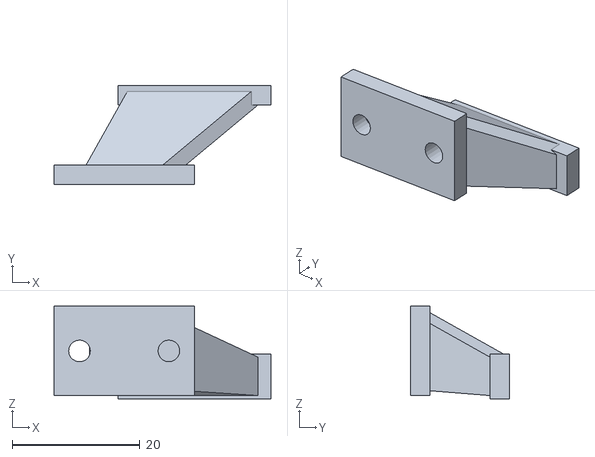
[picture p39: CAD file, 2026-10-02]
14-build/halo/cad/stl/H15L_cradle_arm.stl
34.0 x 15.5 x 14.5
