miketaz100/project-scratch/14-build/pad/cad/stl/PD11_stop_block.stl

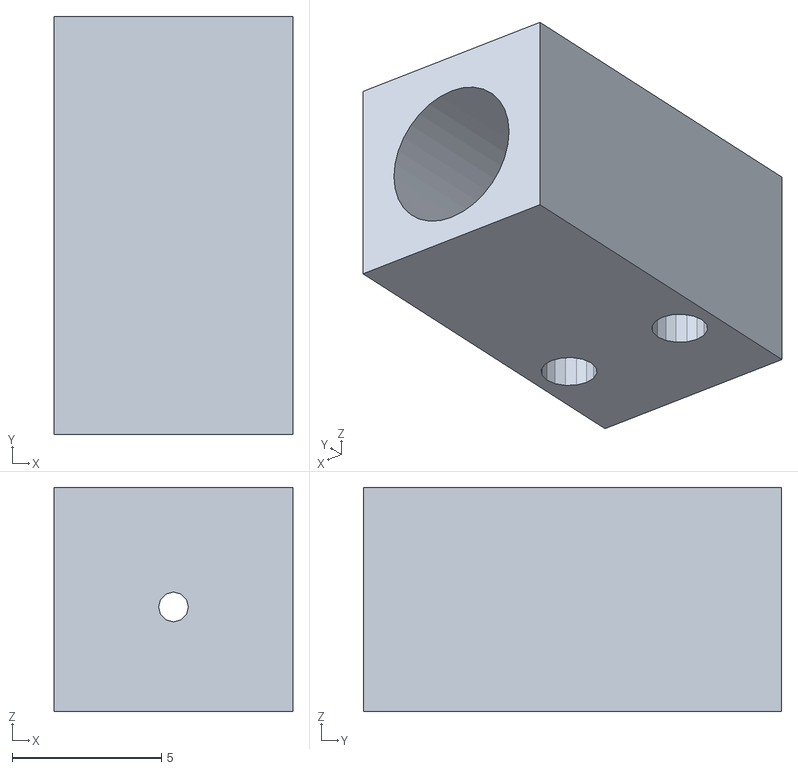
[picture p40: CAD file, 2026-10-02]
14-build/pad/cad/stl/PD11_stop_block.stl
8.00 x 14.0 x 7.50
