miketaz100/project-scratch/14-build/S0/cad/stl/D17_nail_N45_reserve4p5.stl

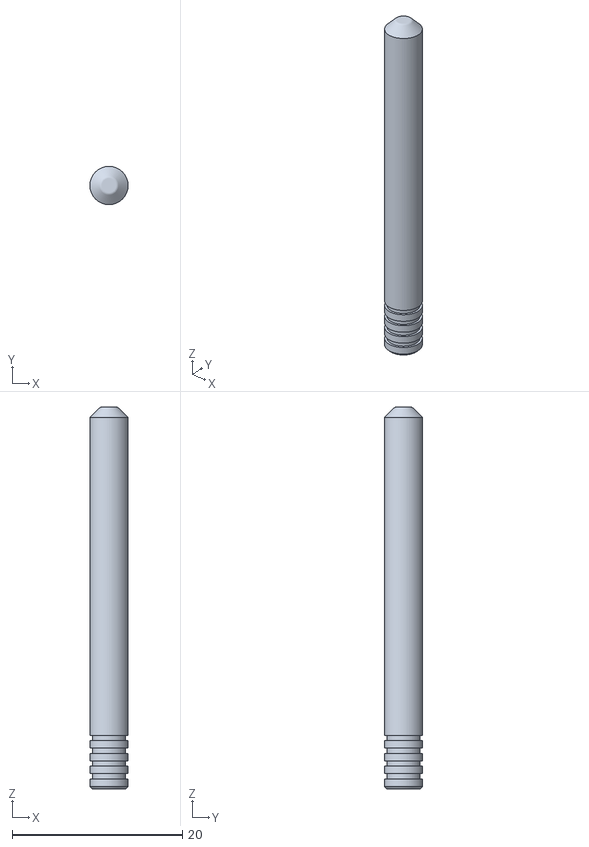
[picture p41: CAD file, 2026-10-02]
14-build/S0/cad/stl/D17_nail_N45_reserve4p5.stl
4.50 x 4.50 x 44.9
