miketaz100/project-scratch/05-engineering/cad/frame/stl/p14_servo_strap.stl

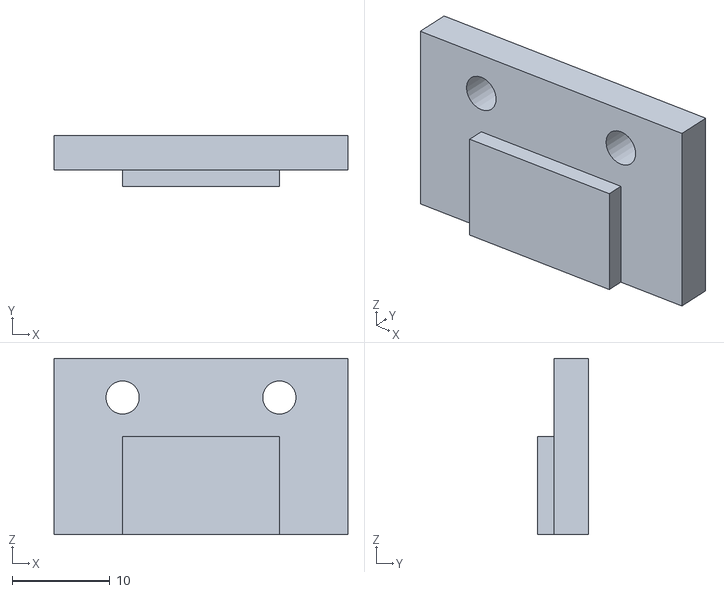
[picture p42: CAD file, 2026-10-01]
05-engineering/cad/frame/stl/p14_servo_strap.stl
30.0 x 5.20 x 18.0
