miketaz100/project-scratch/05-engineering/cad/tips/stl/tip_P_carrier.stl

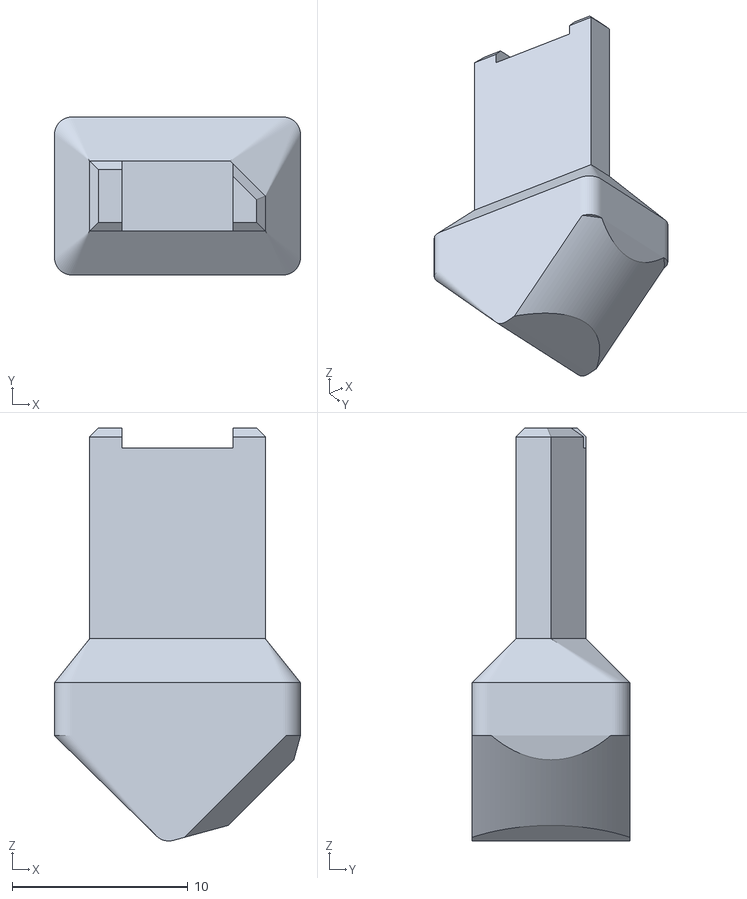
[picture p43: CAD file, 2026-10-01]
05-engineering/cad/tips/stl/tip_P_carrier.stl
14.0 x 9.00 x 23.5
