miketaz100/project-scratch/14-build/drivebox/cad/stl/DB14_saddle_bottle_D51.stl

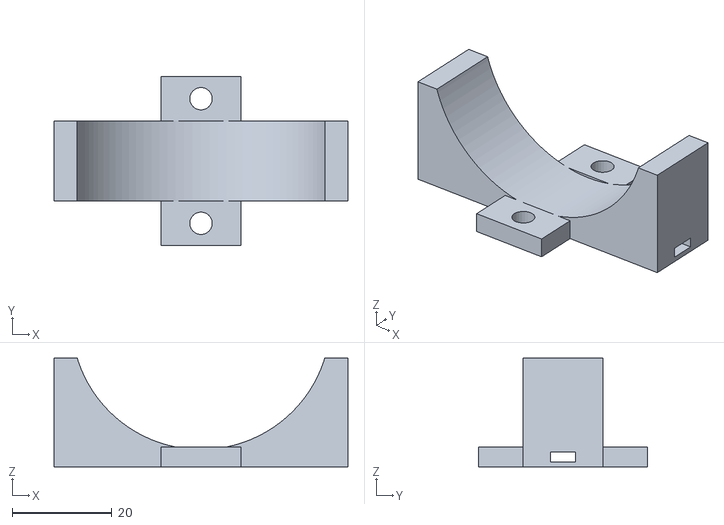
[picture p44: CAD file, 2026-10-02]
14-build/drivebox/cad/stl/DB14_saddle_bottle_D51.stl
59.0 x 34.0 x 21.9
