miketaz100/project-scratch/14-build/halo/cad/stl/H01L_hub_plate.stl

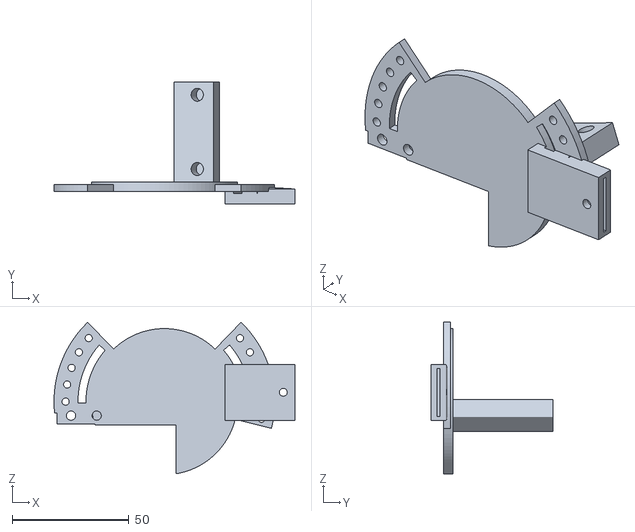
[picture p45: CAD file, 2026-10-02]
14-build/halo/cad/stl/H01L_hub_plate.stl
103.3 x 52.4 x 64.9
