miketaz100/project-scratch/14-build/pad/cad/stl/PD07_gallery_plate.stl

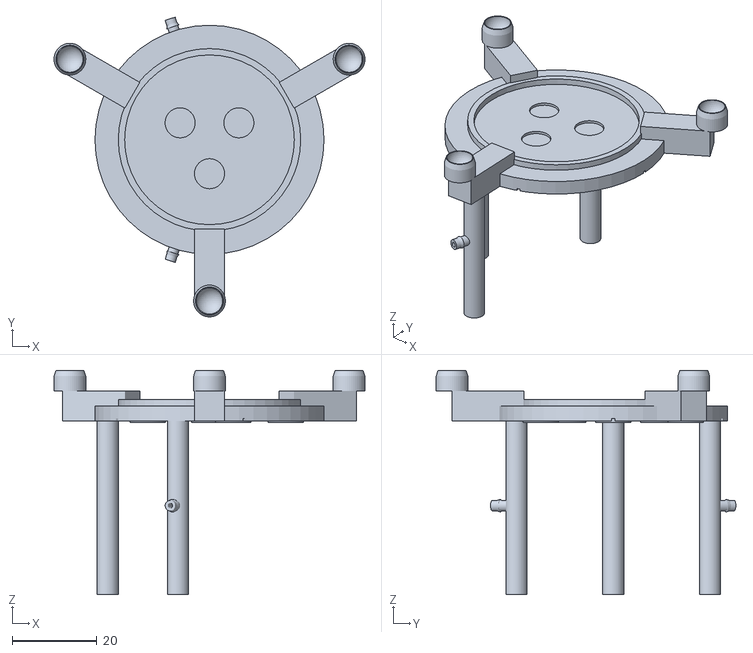
[picture p46: CAD file, 2026-10-02]
14-build/pad/cad/stl/PD07_gallery_plate.stl
73.3 x 70.7 x 52.9
