miketaz100/project-scratch/14-build/S0/cad/stl/D23_V2_c_arm.stl

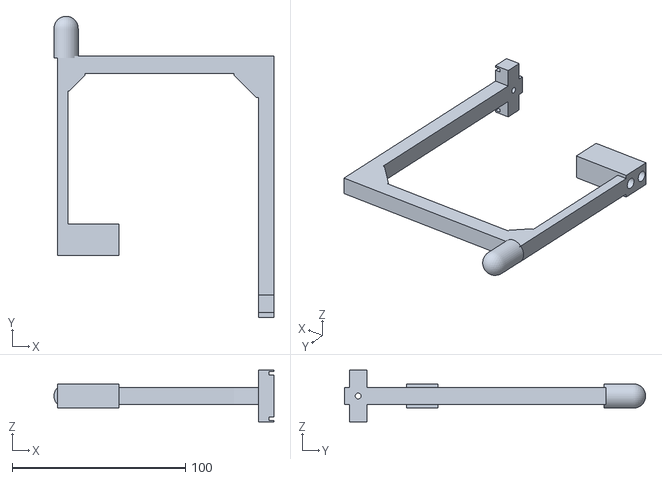
[picture p47: CAD file, 2026-10-02]
14-build/S0/cad/stl/D23_V2_c_arm.stl
127.0 x 174.0 x 30.0
