miketaz100/project-scratch/05-engineering/cad/frame/stl/p07_cord_bar.stl

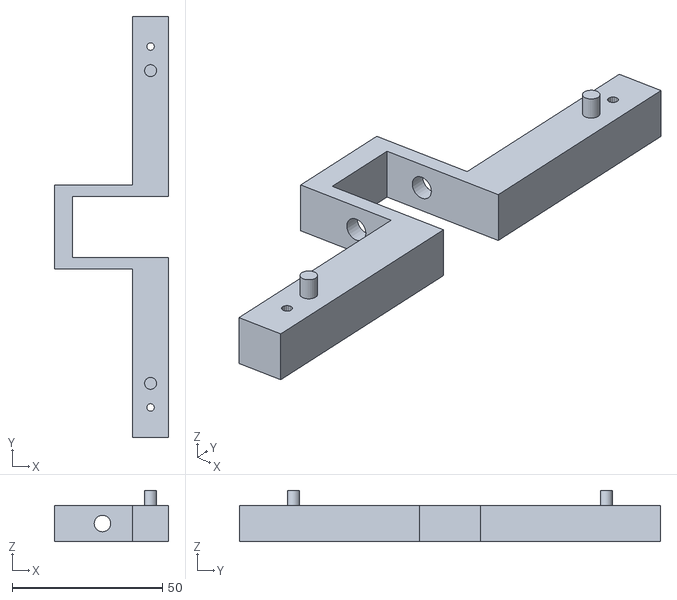
[picture p48: CAD file, 2026-10-01]
05-engineering/cad/frame/stl/p07_cord_bar.stl
38.0 x 140.0 x 17.0
