miketaz100/project-scratch/14-build/drivebox/cad/stl/DB13_saddle_pump_D28.stl

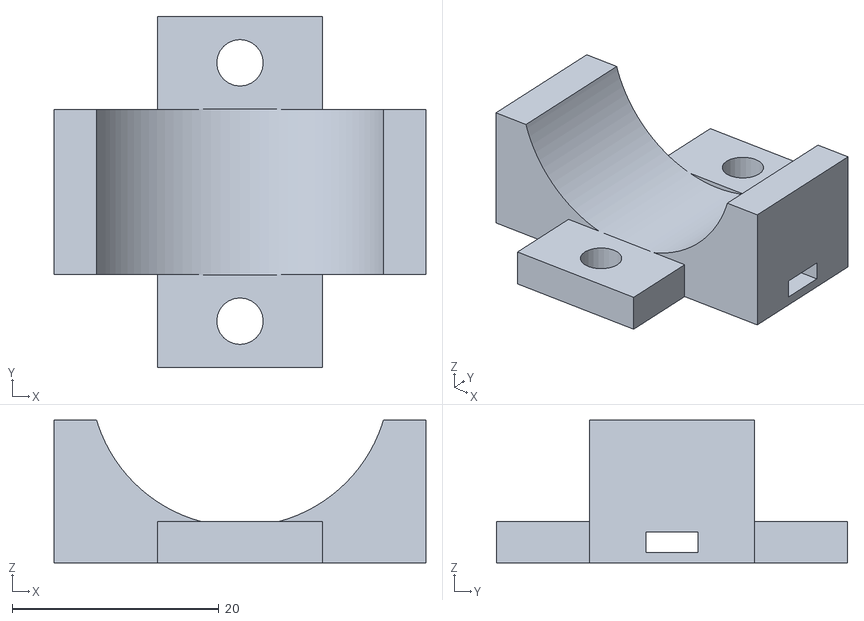
[picture p50: CAD file, 2026-10-02]
14-build/drivebox/cad/stl/DB13_saddle_pump_D28.stl
36.0 x 34.0 x 13.8
