miketaz100/project-scratch/14-build/halo/cad/stl/H15b_cradle_jaw.stl

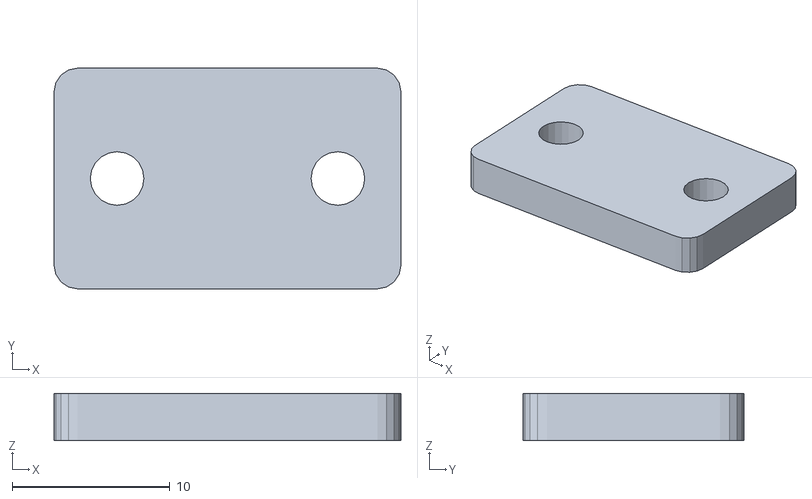
[picture p51: CAD file, 2026-10-02]
14-build/halo/cad/stl/H15b_cradle_jaw.stl
22.0 x 14.0 x 3.00
