miketaz100/project-scratch/14-build/pad/cad/stl/PD06_cartridge.stl

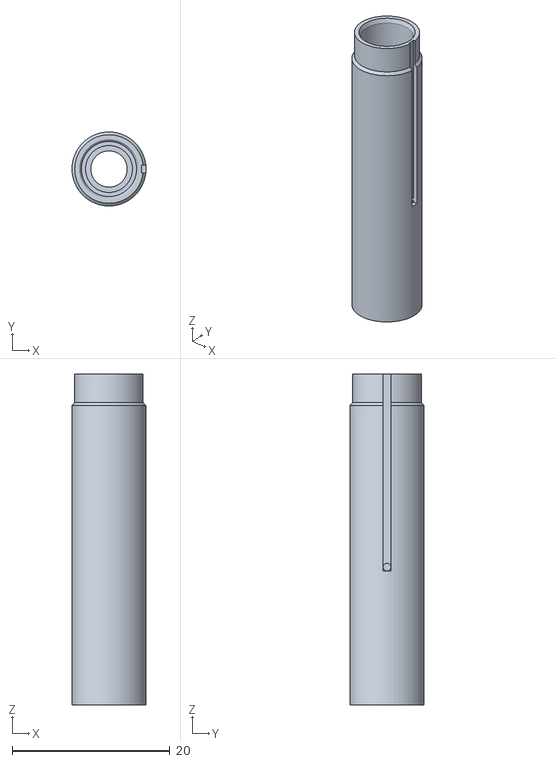
[picture p52: CAD file, 2026-10-02]
14-build/pad/cad/stl/PD06_cartridge.stl
9.40 x 9.40 x 42.0
