miketaz100/project-scratch/14-build/S0/cad/stl/D26_V2_template_T3_circle.stl

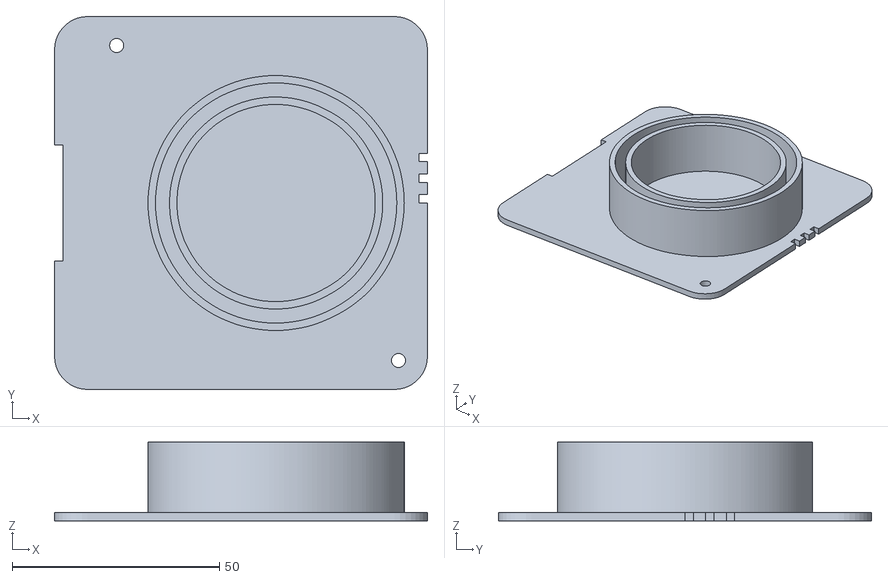
[picture p53: CAD file, 2026-10-02]
14-build/S0/cad/stl/D26_V2_template_T3_circle.stl
90.0 x 90.0 x 19.0
