miketaz100/project-scratch/05-engineering/cad/frame/stl/p01_vesa_adapter.stl

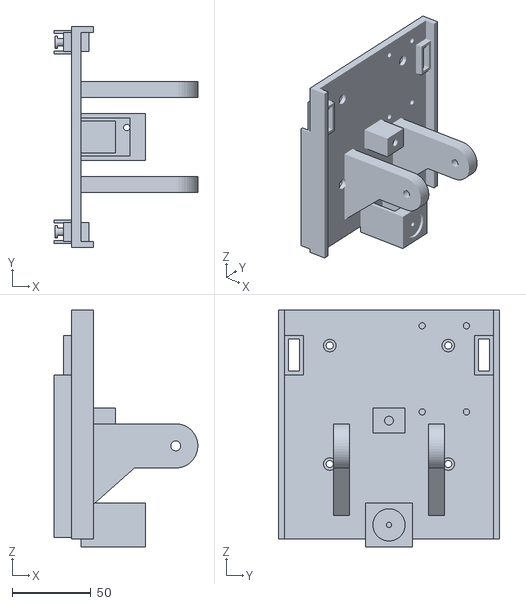
[picture p54: CAD file, 2026-10-01]
05-engineering/cad/frame/stl/p01_vesa_adapter.stl
91.0 x 140.0 x 150.0
