miketaz100/project-scratch/05-engineering/cad/tips/stl/tip_H_ball.stl

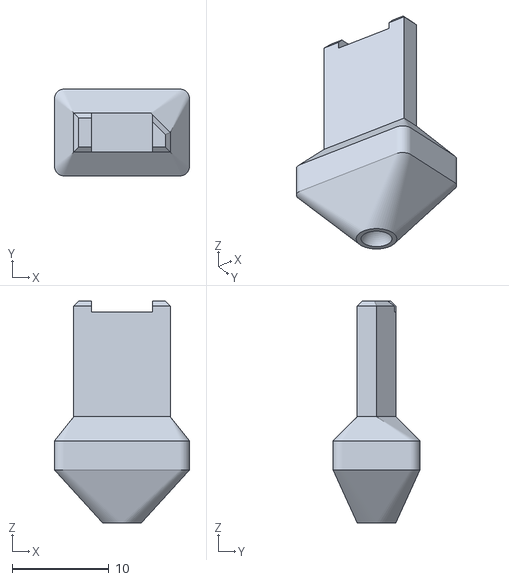
[picture p55: CAD file, 2026-10-01]
05-engineering/cad/tips/stl/tip_H_ball.stl
14.0 x 9.00 x 23.0
