miketaz100/project-scratch/14-build/drivebox/cad/stl/DB17_vent_baffle.stl

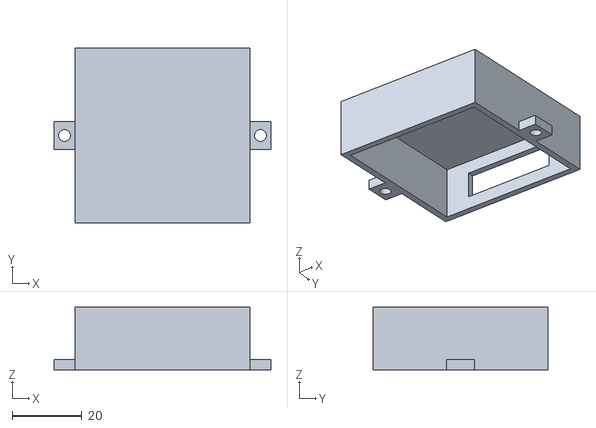
[picture p56: CAD file, 2026-10-02]
14-build/drivebox/cad/stl/DB17_vent_baffle.stl
62.0 x 50.0 x 18.0
