miketaz100/project-scratch/14-build/halo/cad/stl/H13_forehead_node.stl

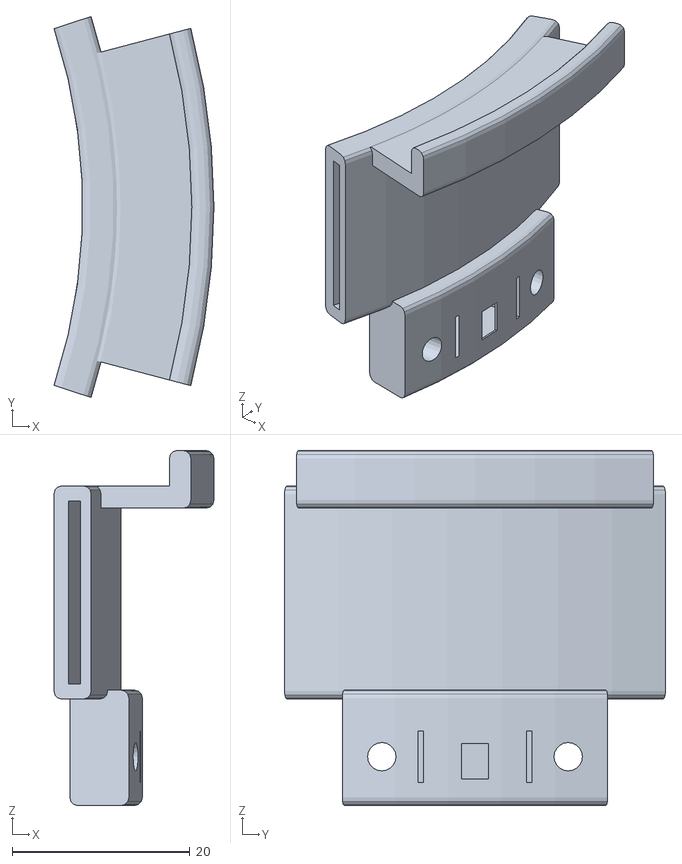
[picture p57: CAD file, 2026-10-02]
14-build/halo/cad/stl/H13_forehead_node.stl
18.0 x 42.9 x 40.0
