miketaz100/project-scratch/14-build/pad/cad/stl/PD18_skid_gauge.stl

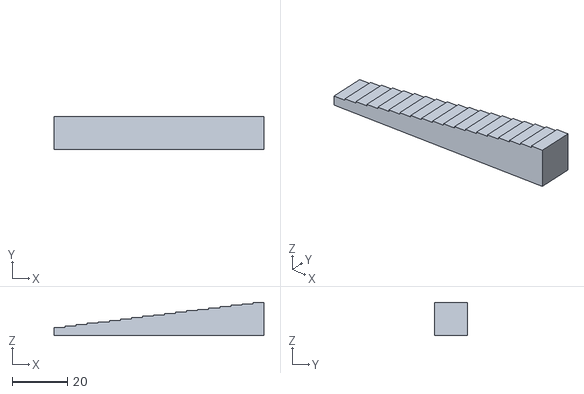
[picture p58: CAD file, 2026-10-02]
14-build/pad/cad/stl/PD18_skid_gauge.stl
76.0 x 12.0 x 12.0
