miketaz100/project-scratch/14-build/S0/cad/stl/D27_rake_handle.stl

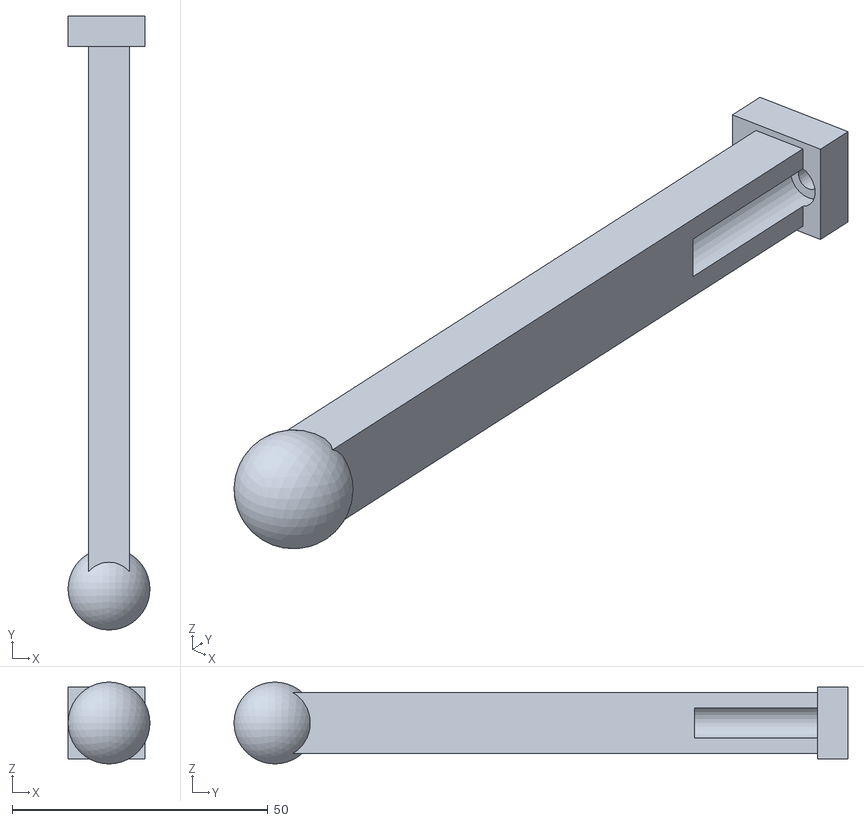
[picture p59: CAD file, 2026-10-02]
14-build/S0/cad/stl/D27_rake_handle.stl
16.0 x 120.0 x 16.0
