miketaz100/project-scratch/05-engineering/cad/frame/stl/p18_guard_cap_idler.stl

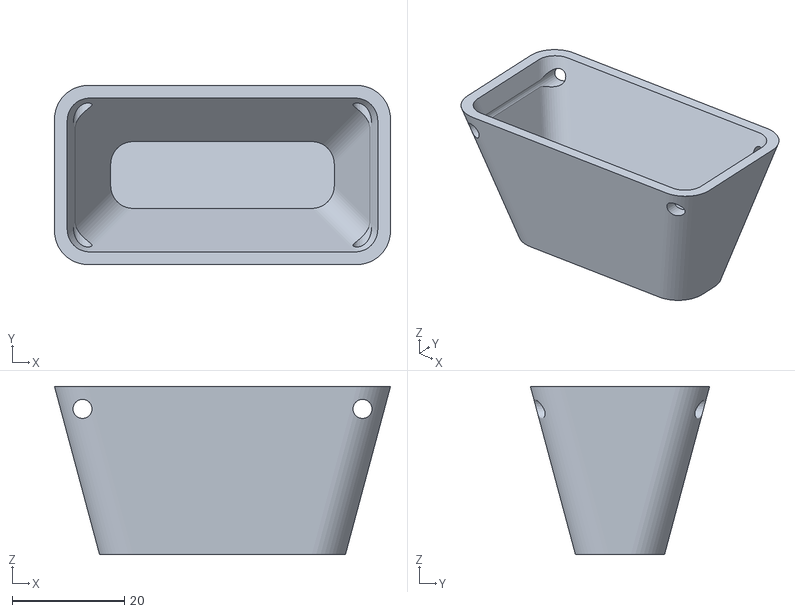
[picture p60: CAD file, 2026-10-01]
05-engineering/cad/frame/stl/p18_guard_cap_idler.stl
60.0 x 32.0 x 30.0
