miketaz100/project-scratch/05-engineering/cad/tips/stl/hand_wand_handle.stl

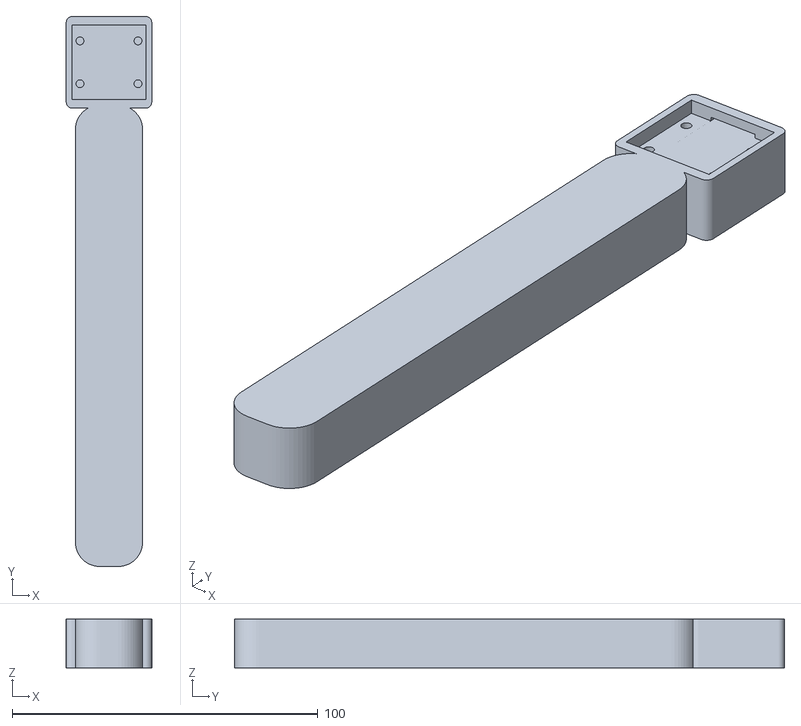
[picture p61: CAD file, 2026-10-01]
05-engineering/cad/tips/stl/hand_wand_handle.stl
28.0 x 180.0 x 16.0
