miketaz100/project-scratch/14-build/drivebox/cad/stl/DB18_panel_bracket.stl

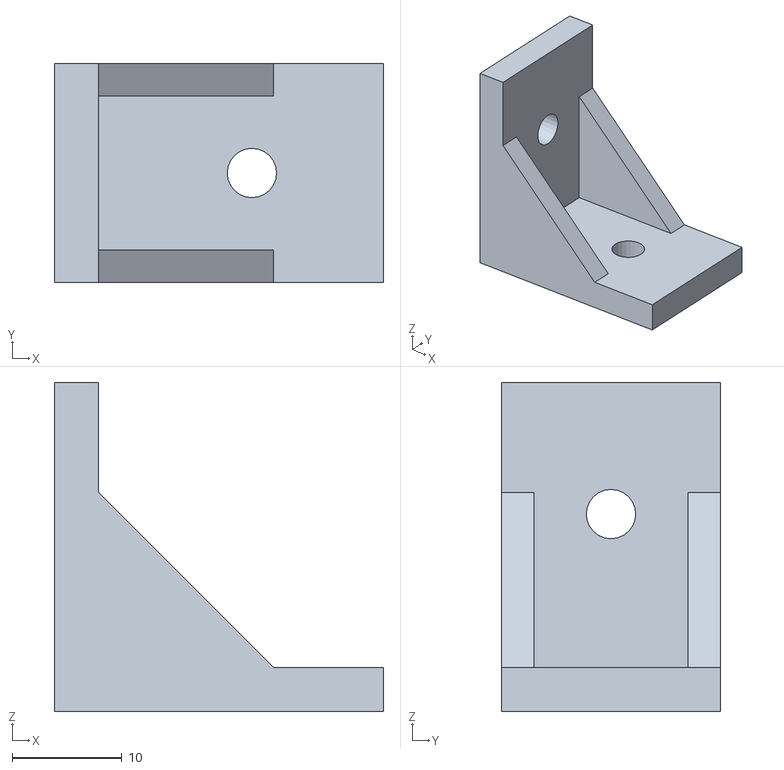
[picture p62: CAD file, 2026-10-02]
14-build/drivebox/cad/stl/DB18_panel_bracket.stl
30.0 x 20.0 x 30.0
