miketaz100/project-scratch/14-build/halo/cad/stl/H19_zero_gauge.stl

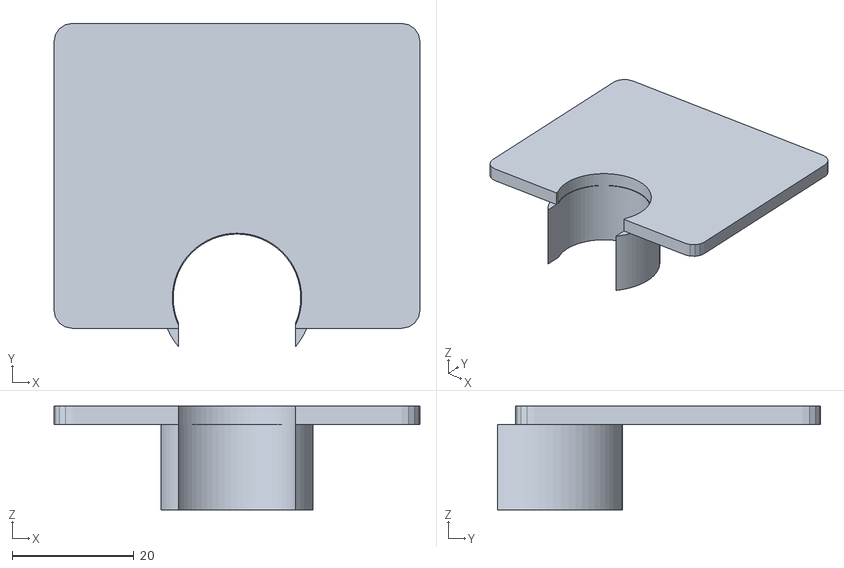
[picture p63: CAD file, 2026-10-02]
14-build/halo/cad/stl/H19_zero_gauge.stl
60.0 x 53.0 x 17.0
