miketaz100/project-scratch/14-build/pad/cad/stl/PD17_shadow_card.stl

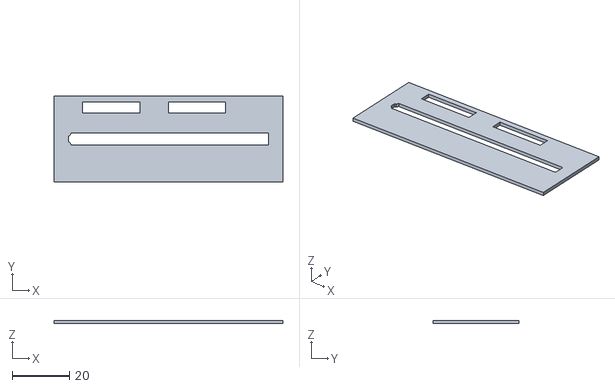
[picture p64: CAD file, 2026-10-02]
14-build/pad/cad/stl/PD17_shadow_card.stl
80.0 x 30.0 x 1.20
