miketaz100/project-scratch/14-build/S0/cad/stl/D07_nail_N30_reserve3.stl

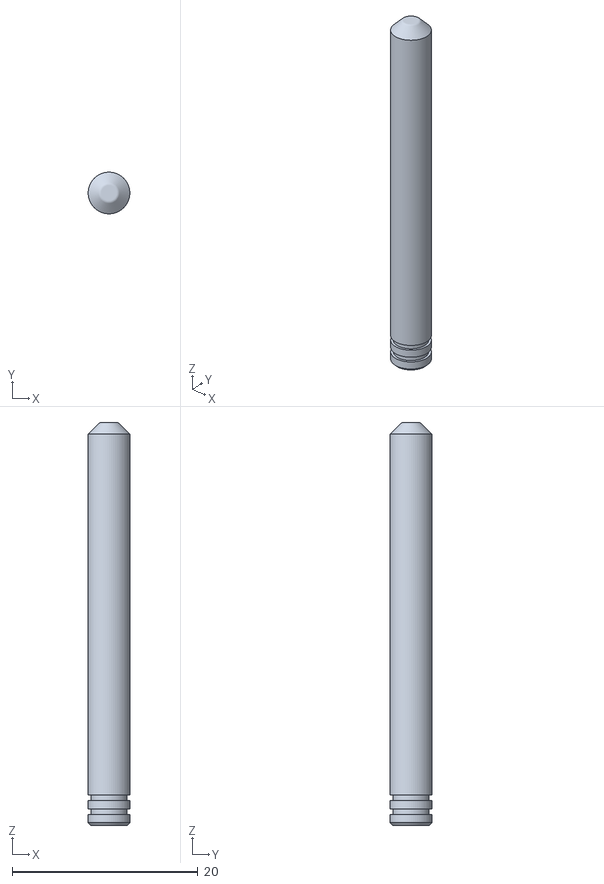
[picture p65: CAD file, 2026-10-02]
14-build/S0/cad/stl/D07_nail_N30_reserve3.stl
4.50 x 4.50 x 43.4
