miketaz100/project-scratch/05-engineering/cad/frame/stl/p37_control_panel_box.stl

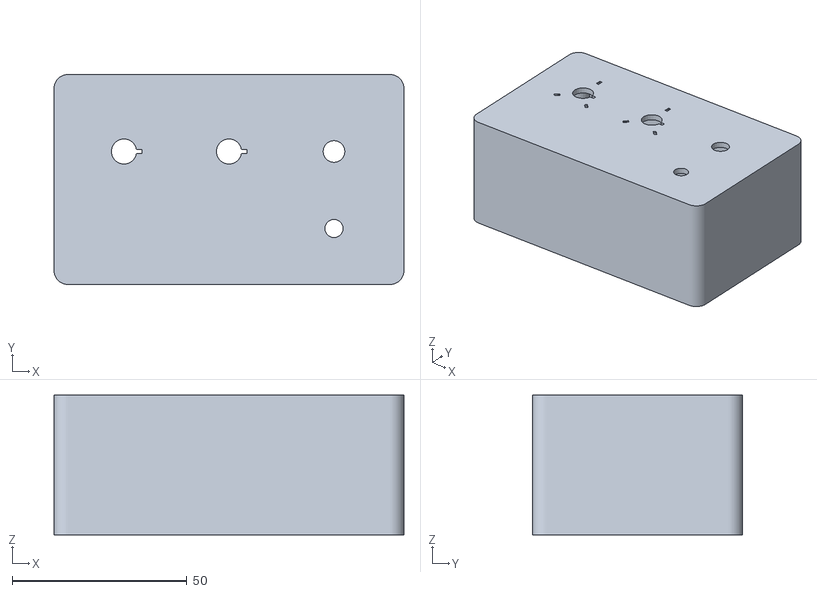
[picture p66: CAD file, 2026-10-01]
05-engineering/cad/frame/stl/p37_control_panel_box.stl
100.0 x 60.0 x 40.0
