miketaz100/project-scratch/05-engineering/cad/tips/stl/tip_E_blade.stl

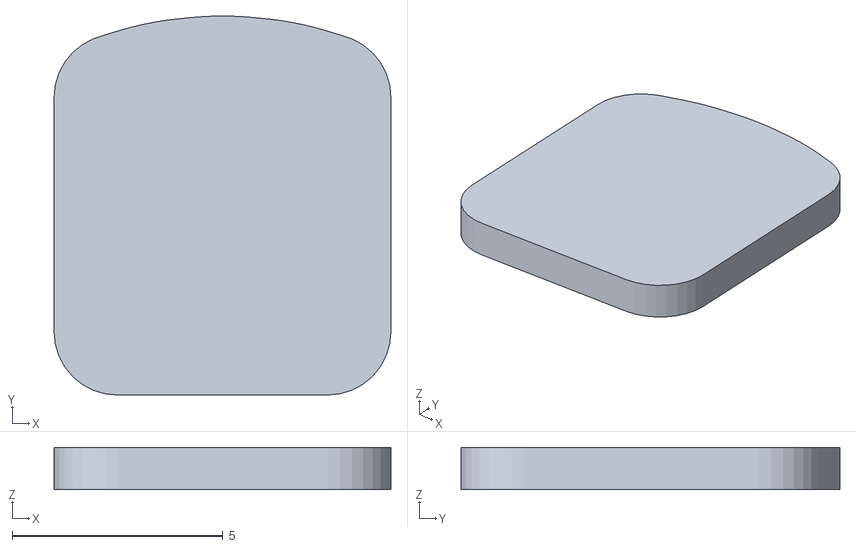
[picture p67: CAD file, 2026-10-01]
05-engineering/cad/tips/stl/tip_E_blade.stl
8.00 x 9.00 x 1.00
