miketaz100/project-scratch/14-build/drivebox/cad/stl/DB16a_clip_nose.stl

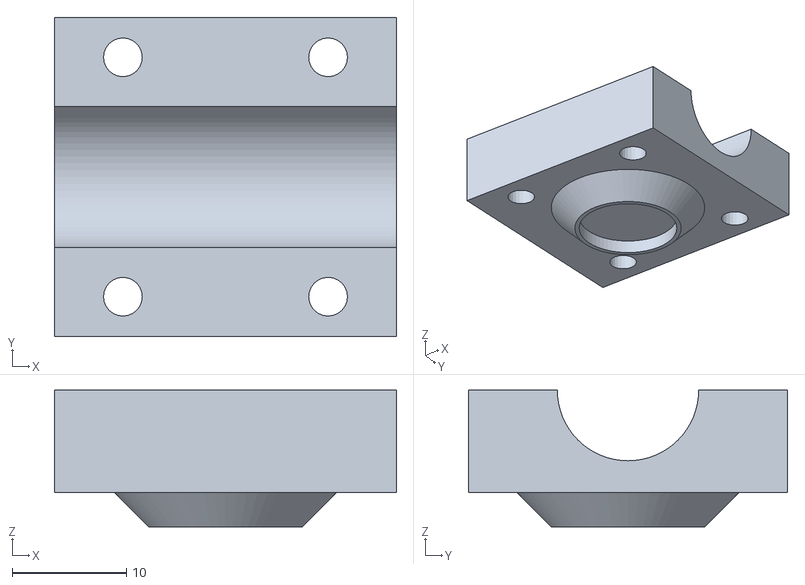
[picture p68: CAD file, 2026-10-02]
14-build/drivebox/cad/stl/DB16a_clip_nose.stl
30.0 x 28.0 x 12.0
