miketaz100/project-scratch/14-build/halo/cad/stl/H10b_spool.stl

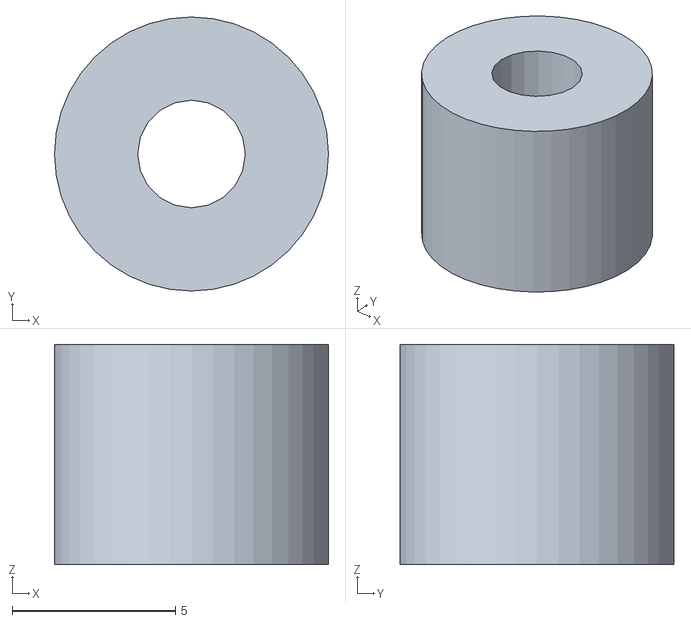
[picture p69: CAD file, 2026-10-02]
14-build/halo/cad/stl/H10b_spool.stl
8.40 x 8.40 x 6.75
