miketaz100/project-scratch/14-build/pad/cad/stl/PD10_yoke.stl

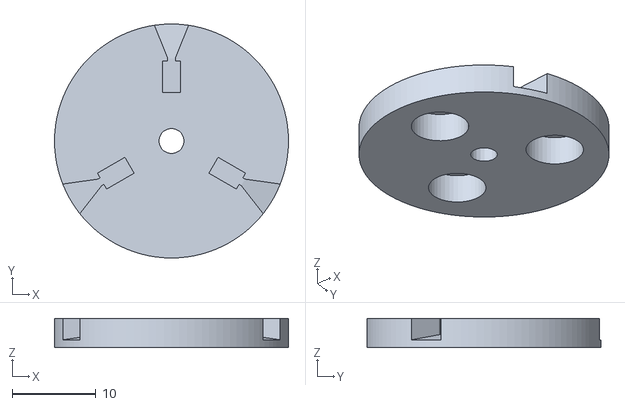
[picture p70: CAD file, 2026-10-02]
14-build/pad/cad/stl/PD10_yoke.stl
28.0 x 28.0 x 3.50
