miketaz100/project-scratch/14-build/S0/cad/stl/T06_pen_plate.stl

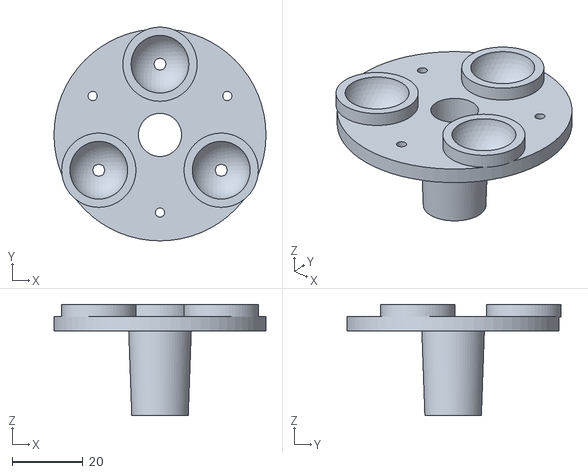
[picture p71: CAD file, 2026-10-02]
14-build/S0/cad/stl/T06_pen_plate.stl
60.0 x 60.5 x 31.5
