miketaz100/project-scratch/05-engineering/cad/frame/stl/p25_scale_strip.stl

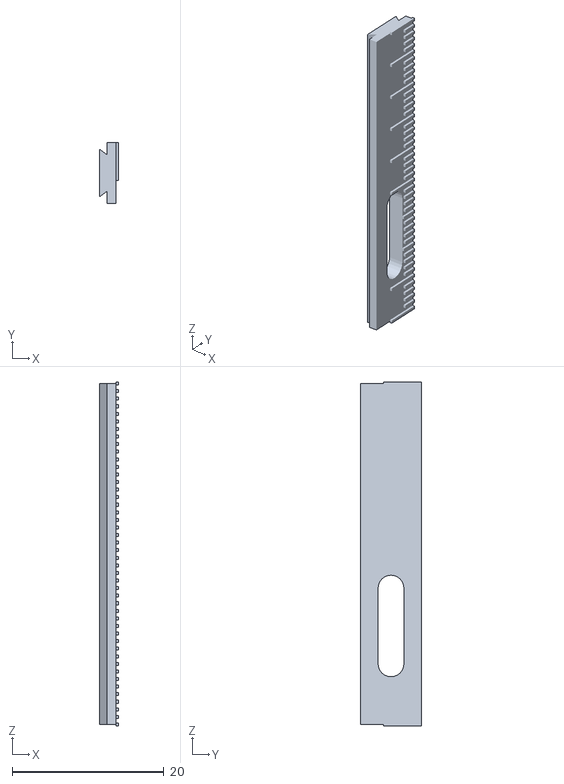
[picture p72: CAD file, 2026-10-01]
05-engineering/cad/frame/stl/p25_scale_strip.stl
2.50 x 8.00 x 45.4
