miketaz100/project-scratch/05-engineering/cad/tips/stl/tip_E_carrier.stl

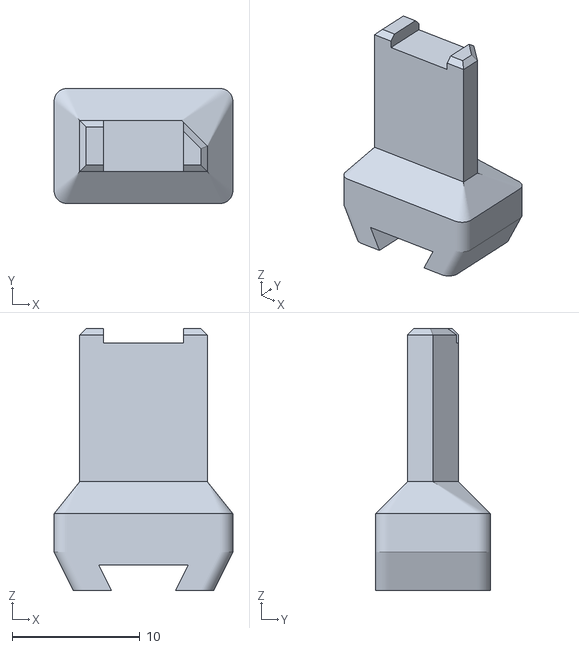
[picture p73: CAD file, 2026-10-01]
05-engineering/cad/tips/stl/tip_E_carrier.stl
14.0 x 9.00 x 20.5
