miketaz100/project-scratch/14-build/drivebox/cad/stl/DB09_hook_plate.stl

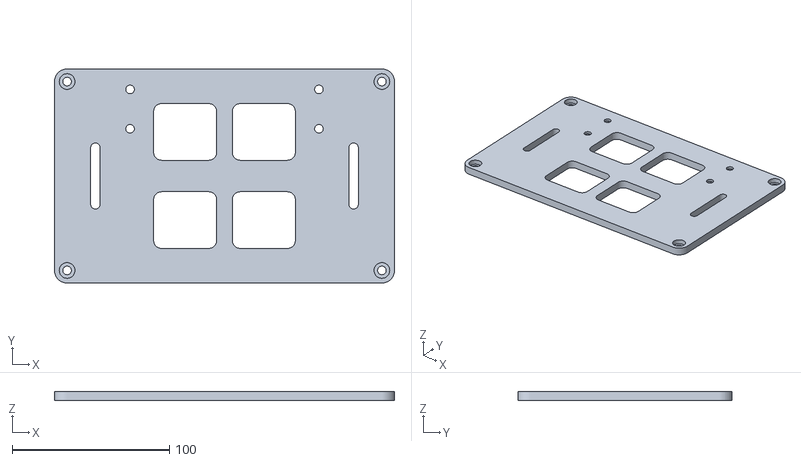
[picture p74: CAD file, 2026-10-02]
14-build/drivebox/cad/stl/DB09_hook_plate.stl
216.0 x 136.0 x 6.00
