miketaz100/project-scratch/14-build/halo/cad/stl/H07_chord_node.stl

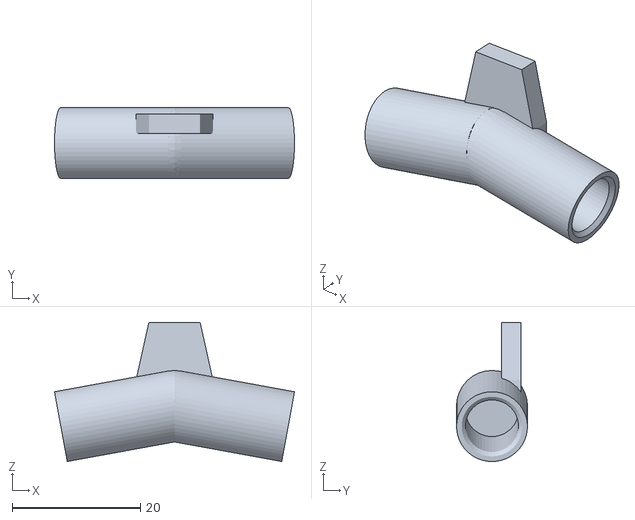
[picture p75: CAD file, 2026-10-02]
14-build/halo/cad/stl/H07_chord_node.stl
37.4 x 11.1 x 21.7
