miketaz100/project-scratch/14-build/pad/cad/stl/PD02_skirt_frame.stl

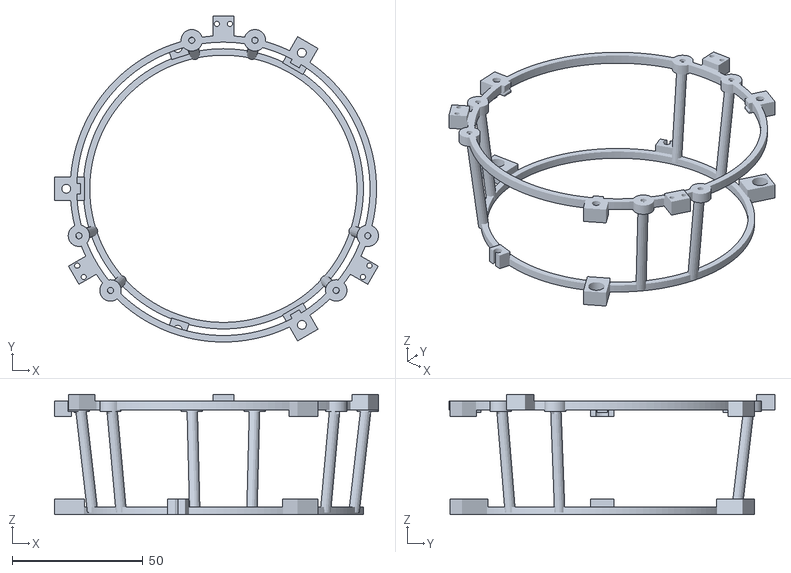
[picture p76: CAD file, 2026-10-02]
14-build/pad/cad/stl/PD02_skirt_frame.stl
123.8 x 124.5 x 46.0
