miketaz100/project-scratch/14-build/S0/cad/stl/T02_motor_table.stl

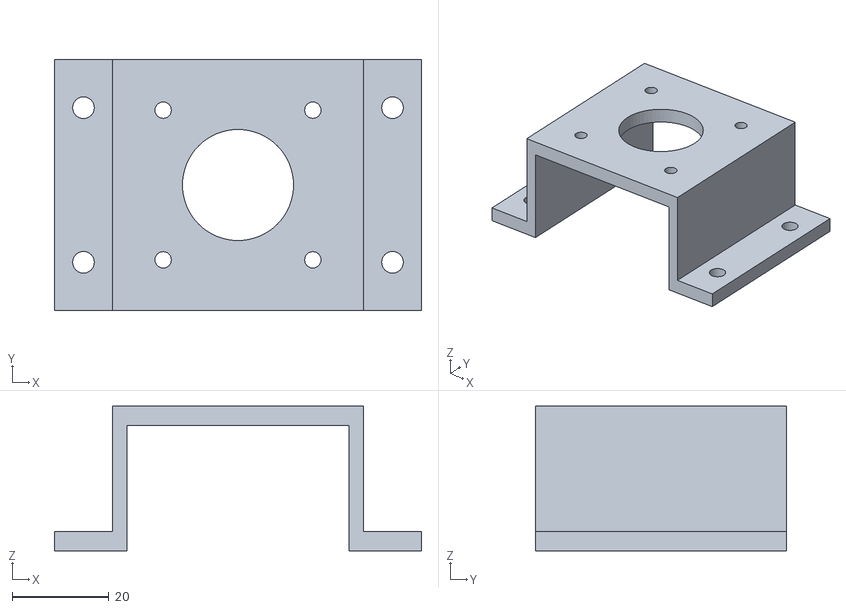
[picture p77: CAD file, 2026-10-02]
14-build/S0/cad/stl/T02_motor_table.stl
76.0 x 52.0 x 30.0
