miketaz100/project-scratch/05-engineering/cad/frame/stl/p34_root_clamp_bar.stl

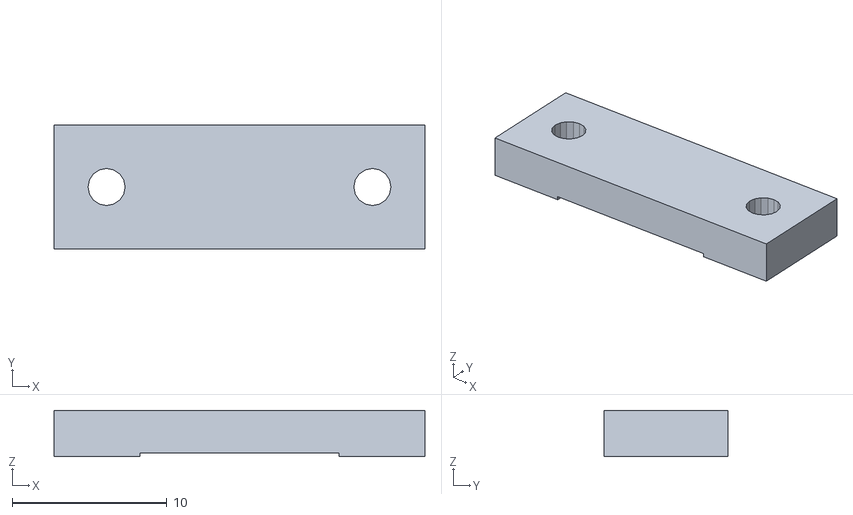
[picture p78: CAD file, 2026-10-01]
05-engineering/cad/frame/stl/p34_root_clamp_bar.stl
24.0 x 8.00 x 3.00
