miketaz100/project-scratch/14-build/drivebox/cad/stl/DB02_deck.stl

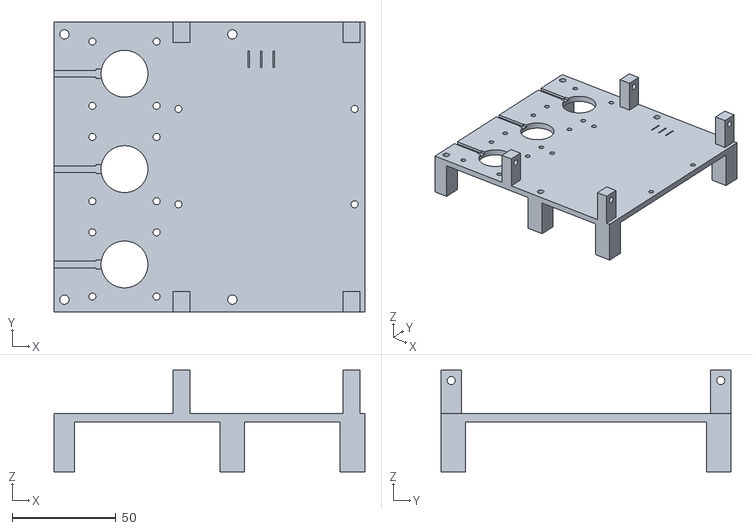
[picture p79: CAD file, 2026-10-02]
14-build/drivebox/cad/stl/DB02_deck.stl
150.0 x 140.0 x 49.0
