miketaz100/project-scratch/14-build/halo/cad/stl/H12_spider.stl

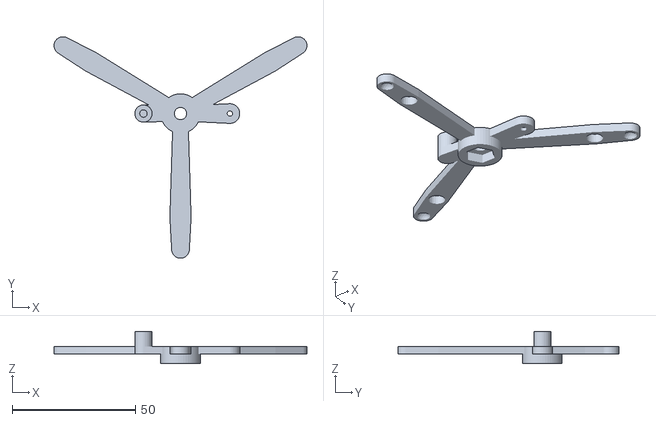
[picture p80: CAD file, 2026-10-02]
14-build/halo/cad/stl/H12_spider.stl
102.5 x 89.7 x 13.0
