miketaz100/project-scratch/14-build/pad/cad/stl/PD09_piston.stl

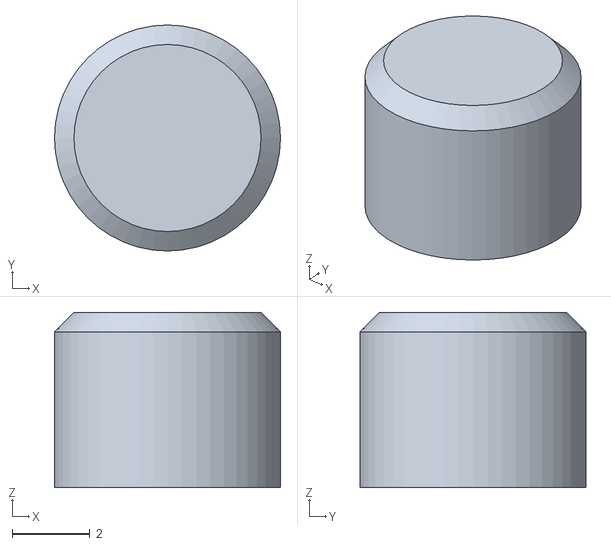
[picture p81: CAD file, 2026-10-02]
14-build/pad/cad/stl/PD09_piston.stl
5.80 x 5.80 x 4.50
