miketaz100/project-scratch/14-build/S0/cad/stl/D08_c_arm.stl

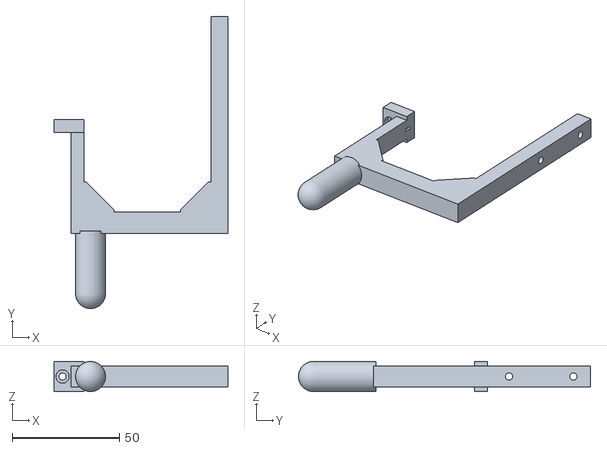
[picture p82: CAD file, 2026-10-02]
14-build/S0/cad/stl/D08_c_arm.stl
81.0 x 136.0 x 14.0
