miketaz100/project-scratch/05-engineering/cad/frame/stl/p12_drop_leg_idler.stl

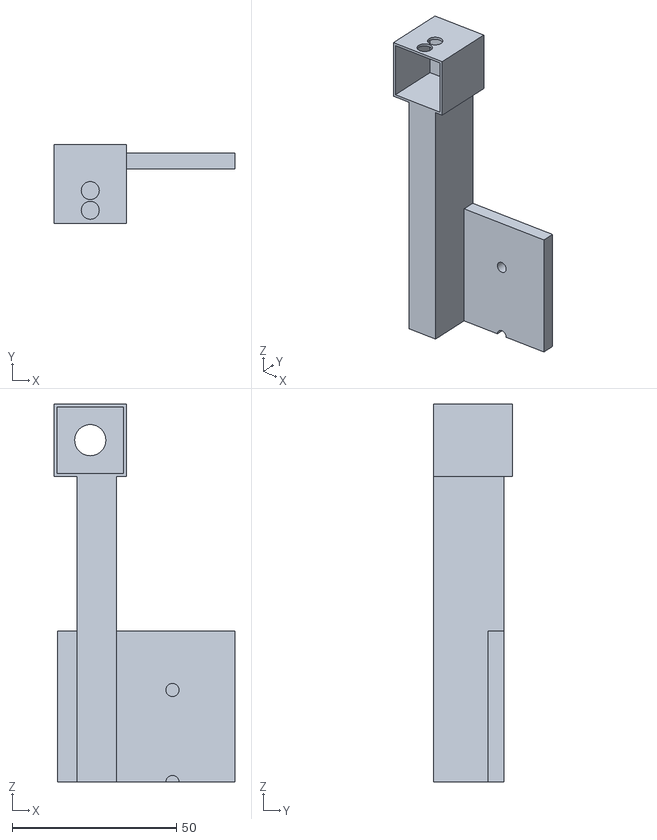
[picture p83: CAD file, 2026-10-01]
05-engineering/cad/frame/stl/p12_drop_leg_idler.stl
55.0 x 24.0 x 115.0
