miketaz100/project-scratch/05-engineering/cad/tips/stl/hand_wand_clamp_bar.stl

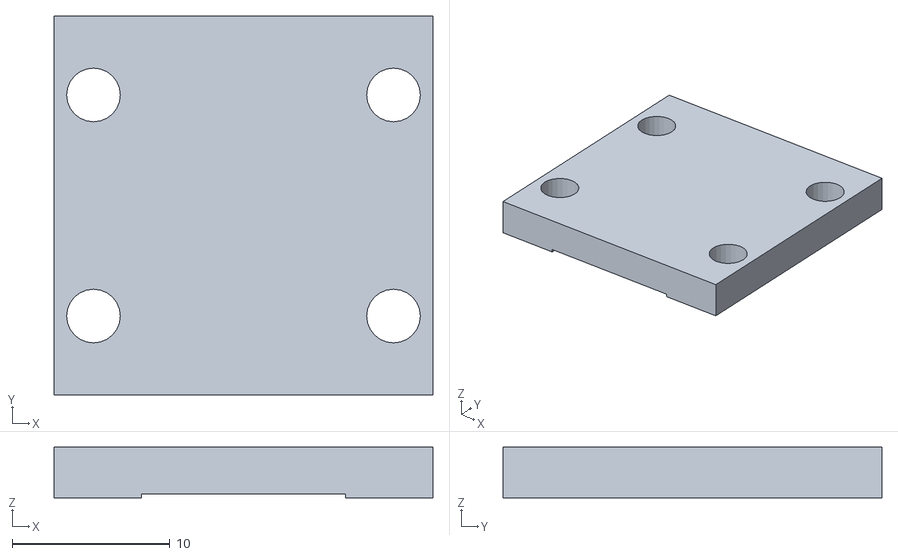
[picture p84: CAD file, 2026-10-01]
05-engineering/cad/tips/stl/hand_wand_clamp_bar.stl
24.0 x 24.0 x 3.20
