miketaz100/project-scratch/14-build/drivebox/cad/stl/DB05_comb.stl

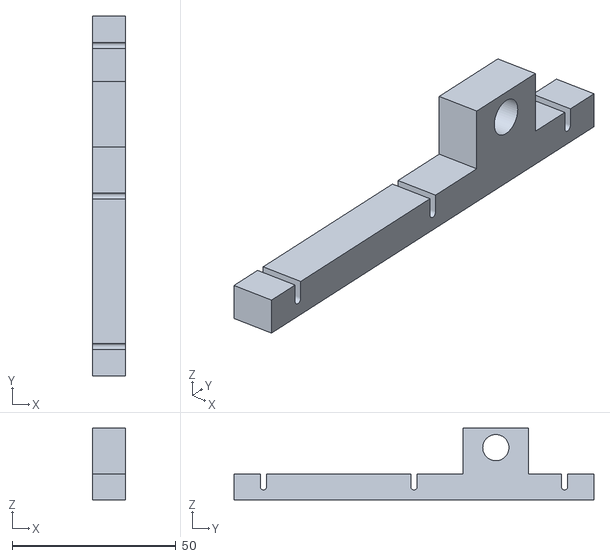
[picture p85: CAD file, 2026-10-02]
14-build/drivebox/cad/stl/DB05_comb.stl
10.0 x 110.0 x 22.0
