miketaz100/project-scratch/14-build/halo/cad/stl/H18a_umb_collar.stl

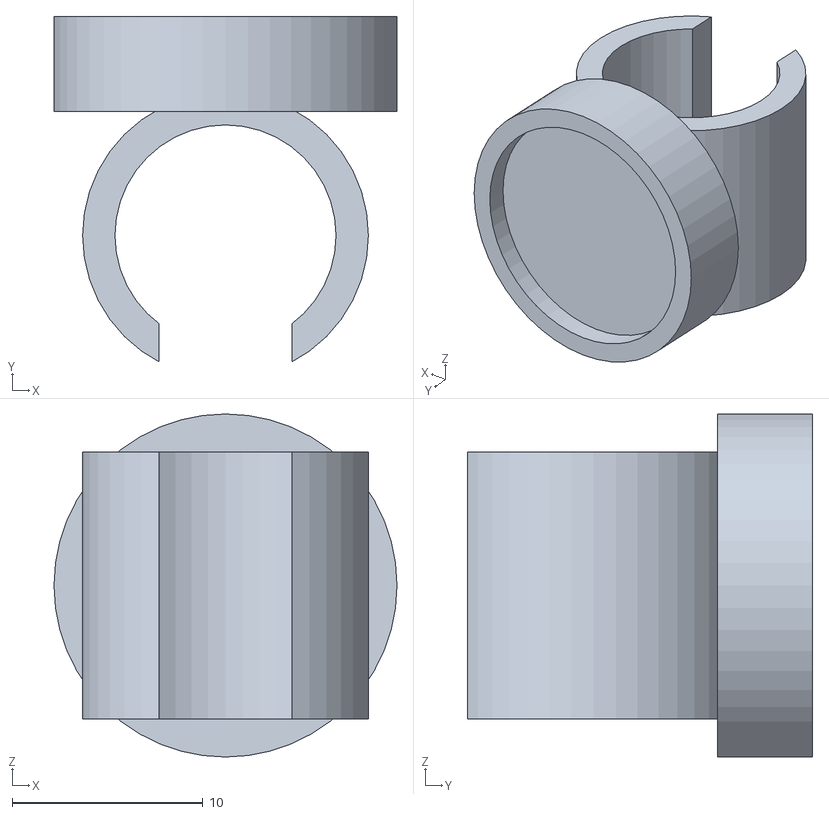
[picture p86: CAD file, 2026-10-02]
14-build/halo/cad/stl/H18a_umb_collar.stl
18.0 x 18.1 x 18.0
