miketaz100/project-scratch/14-build/pad/cad/stl/PD13_skid_foot.stl

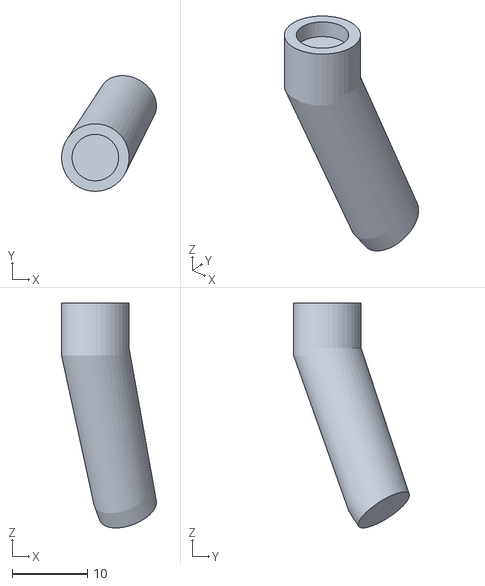
[picture p87: CAD file, 2026-10-02]
14-build/pad/cad/stl/PD13_skid_foot.stl
12.6 x 15.4 x 30.0
