miketaz100/project-scratch/14-build/S0/cad/stl/H01_hinge_pad.stl

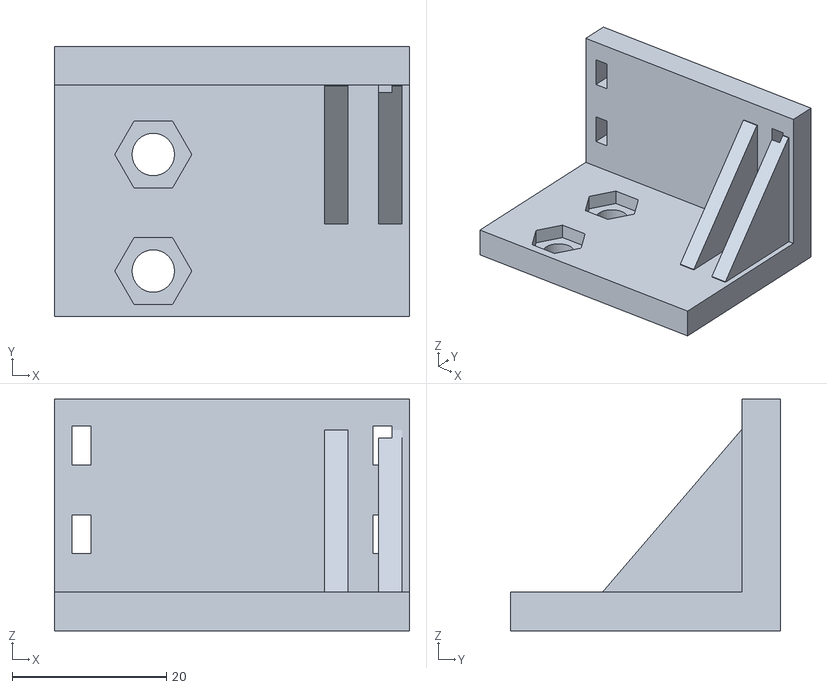
[picture p88: CAD file, 2026-10-02]
14-build/S0/cad/stl/H01_hinge_pad.stl
46.0 x 35.0 x 30.0
