miketaz100/project-scratch/05-engineering/cad/frame/stl/p13_servo_cradle.stl

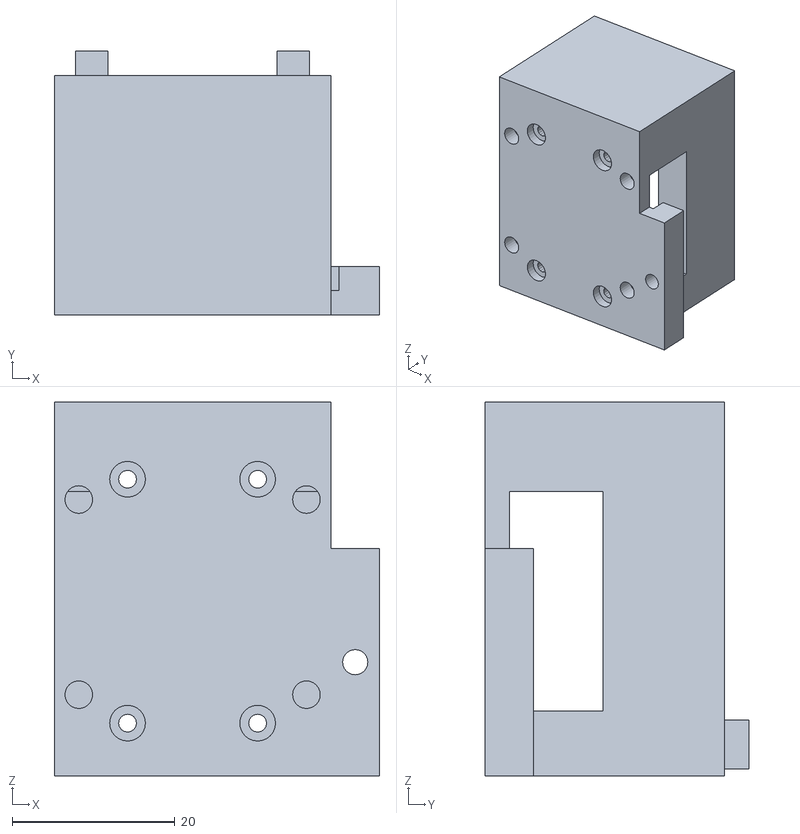
[picture p89: CAD file, 2026-10-01]
05-engineering/cad/frame/stl/p13_servo_cradle.stl
40.0 x 32.5 x 46.0
