miketaz100/project-scratch/05-engineering/cad/tips/stl/tip_A45.stl

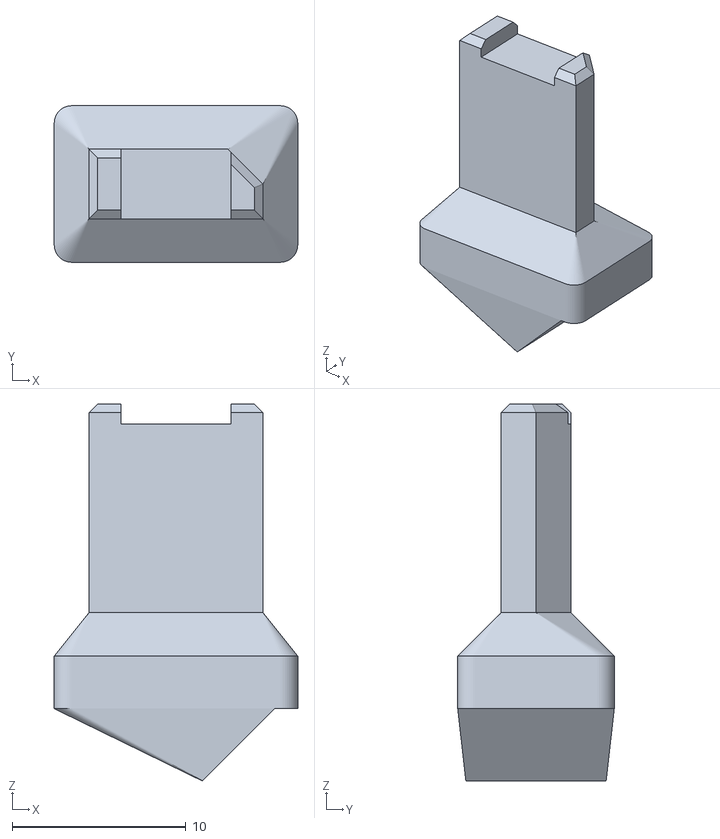
[picture p90: CAD file, 2026-10-01]
05-engineering/cad/tips/stl/tip_A45.stl
14.0 x 9.00 x 21.7
