miketaz100/project-scratch/14-build/drivebox/cad/stl/DB03b_floating_plate_4mm_housing.stl

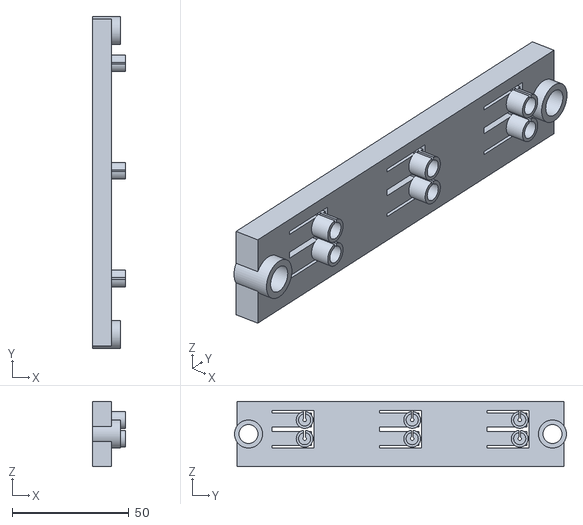
[picture p91: CAD file, 2026-10-02]
14-build/drivebox/cad/stl/DB03b_floating_plate_4mm_housing.stl
14.0 x 142.0 x 28.0
