miketaz100/project-scratch/14-build/halo/cad/stl/H06_alpha_stop.stl

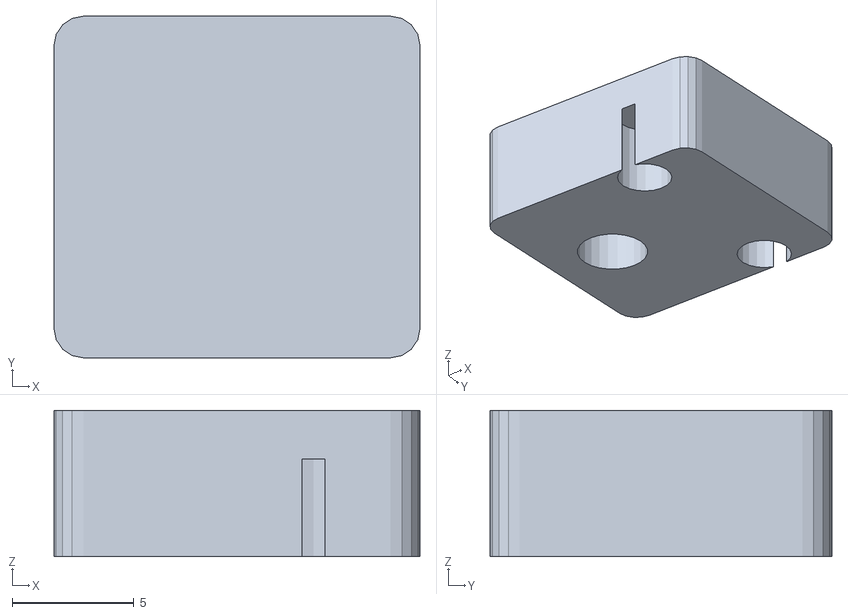
[picture p92: CAD file, 2026-10-02]
14-build/halo/cad/stl/H06_alpha_stop.stl
15.0 x 14.0 x 6.00
