miketaz100/project-scratch/14-build/pad/cad/stl/PD12_skid_stem.stl

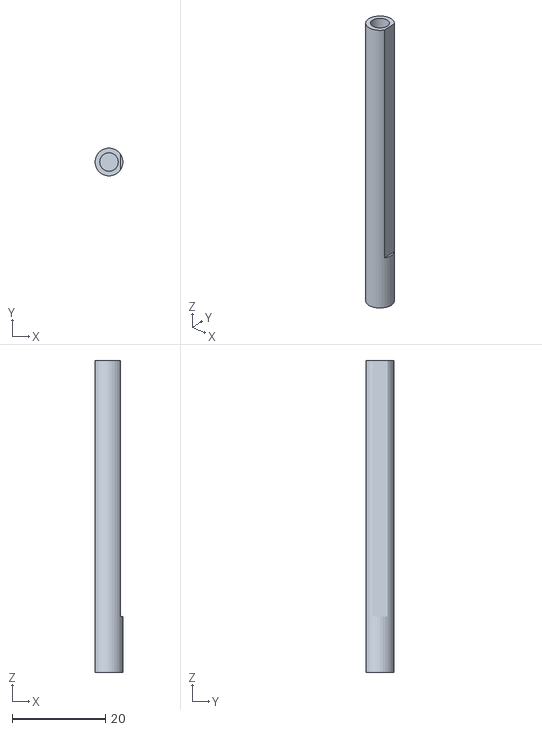
[picture p93: CAD file, 2026-10-02]
14-build/pad/cad/stl/PD12_skid_stem.stl
6.00 x 6.00 x 67.0
