miketaz100/project-scratch/14-build/S0/cad/stl/D03_nose_plate.stl

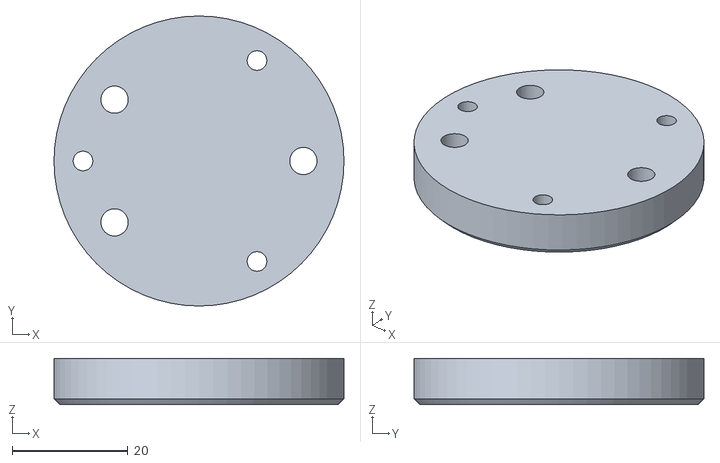
[picture p94: CAD file, 2026-10-02]
14-build/S0/cad/stl/D03_nose_plate.stl
50.0 x 50.0 x 8.00
