miketaz100/project-scratch/05-engineering/cad/frame/stl/p36_cable_clip.stl

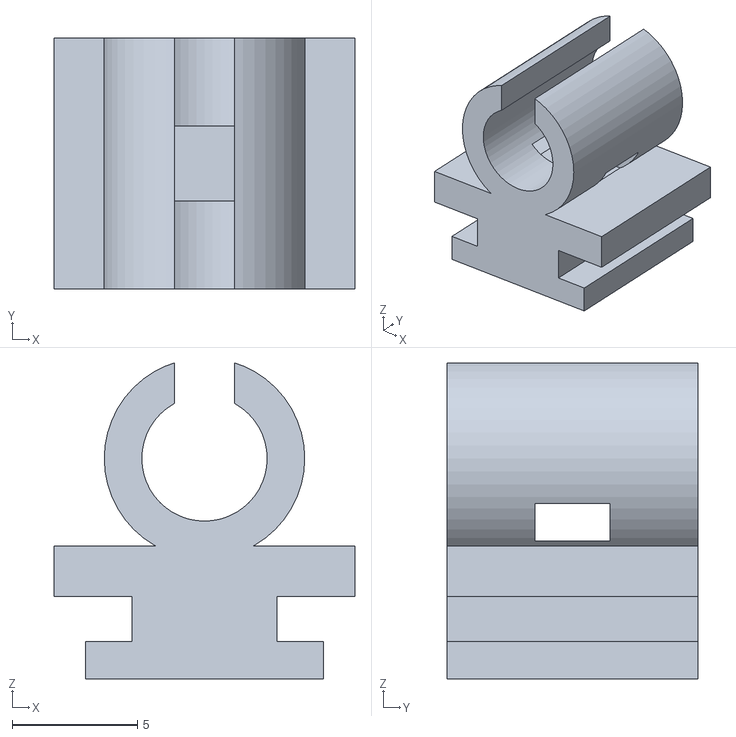
[picture p95: CAD file, 2026-10-01]
05-engineering/cad/frame/stl/p36_cable_clip.stl
12.0 x 10.0 x 12.6
