miketaz100/project-scratch/14-build/drivebox/cad/stl/DB12_pegboard.stl

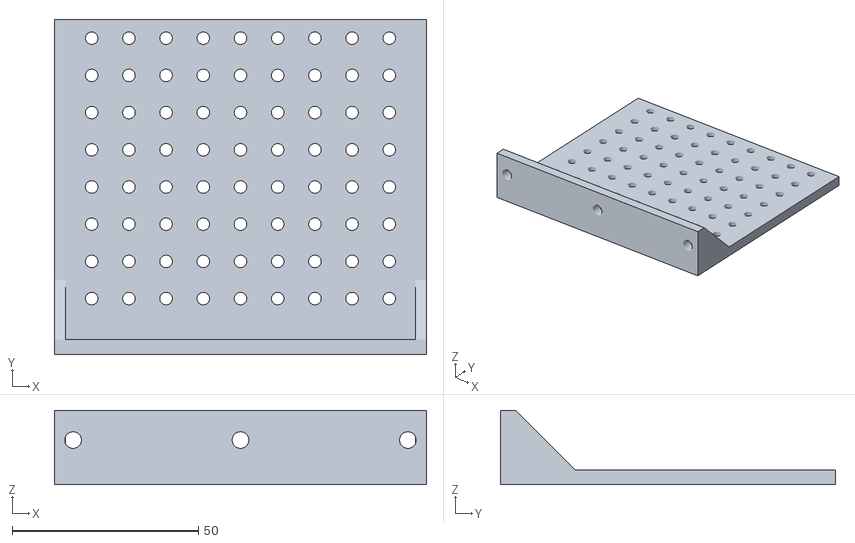
[picture p96: CAD file, 2026-10-02]
14-build/drivebox/cad/stl/DB12_pegboard.stl
100.0 x 90.0 x 20.0
