miketaz100/project-scratch/14-build/pad/cad/stl/PD16_hang_cup.stl

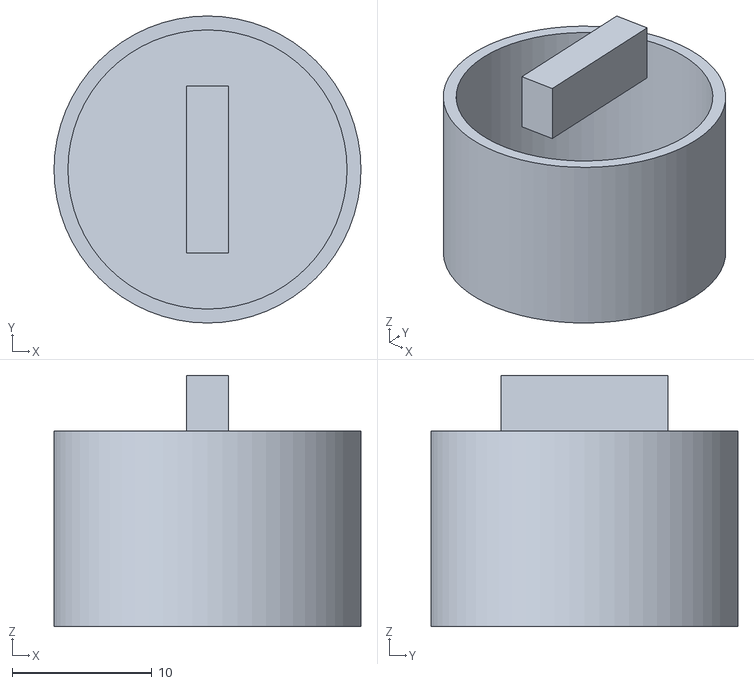
[picture p97: CAD file, 2026-10-02]
14-build/pad/cad/stl/PD16_hang_cup.stl
22.0 x 22.0 x 18.0
