miketaz100/project-scratch/14-build/S0/cad/stl/D04_plunger.stl

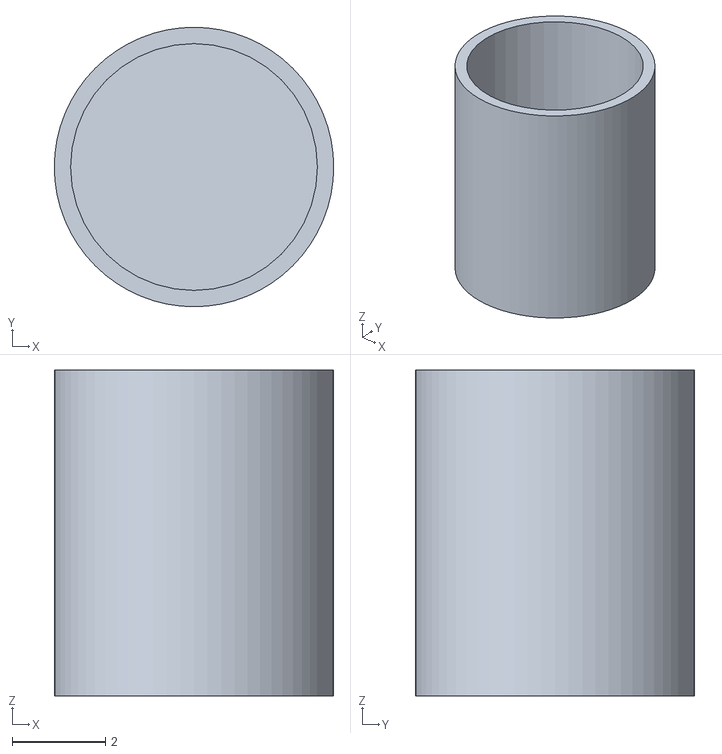
[picture p98: CAD file, 2026-10-02]
14-build/S0/cad/stl/D04_plunger.stl
6.00 x 6.00 x 7.00
