miketaz100/project-scratch/05-engineering/cad/frame/stl/p30_knuckle_plate.stl

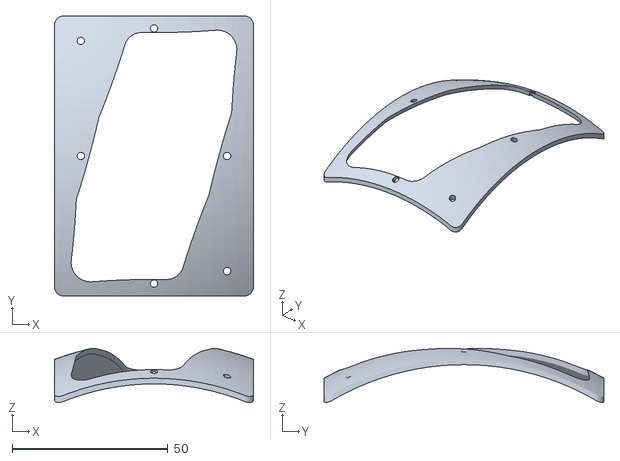
[picture p99: CAD file, 2026-10-01]
05-engineering/cad/frame/stl/p30_knuckle_plate.stl
64.0 x 90.0 x 17.4
