miketaz100/project-scratch/14-build/drivebox/cad/stl/DB03_floating_plate.stl

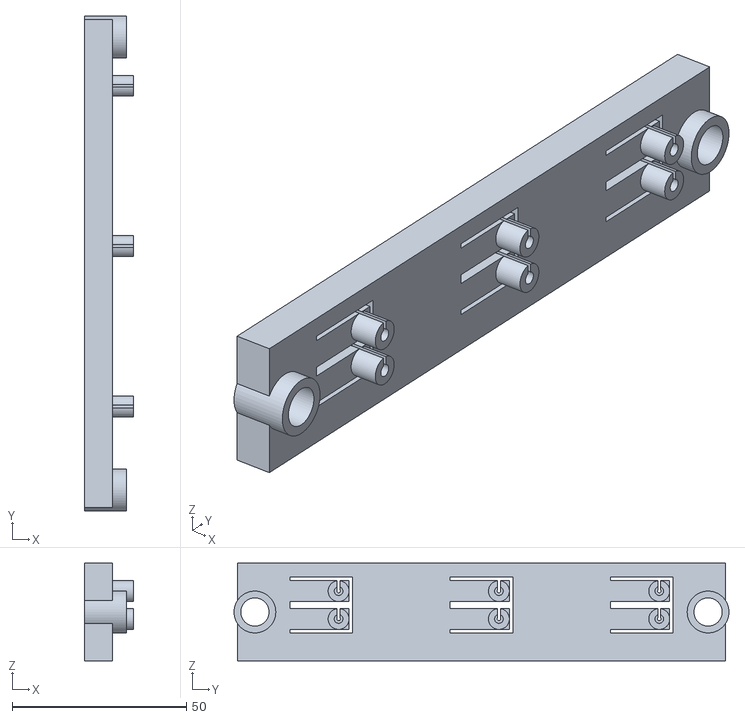
[picture p100: CAD file, 2026-10-02]
14-build/drivebox/cad/stl/DB03_floating_plate.stl
14.0 x 142.0 x 28.0
