miketaz100/project-scratch/14-build/halo/cad/stl/H14_trigger_plate.stl

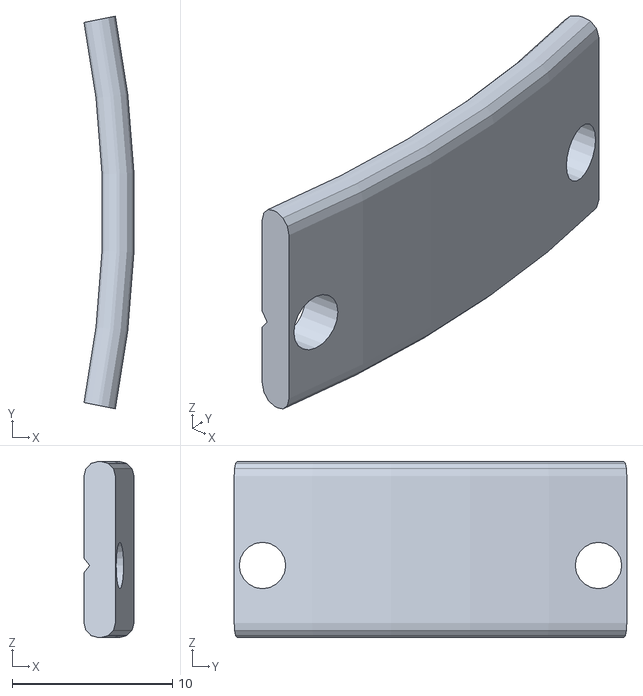
[picture p101: CAD file, 2026-10-02]
14-build/halo/cad/stl/H14_trigger_plate.stl
3.12 x 24.5 x 11.0
