miketaz100/project-scratch/14-build/pad/cad/stl/PD15_nail_reference.stl

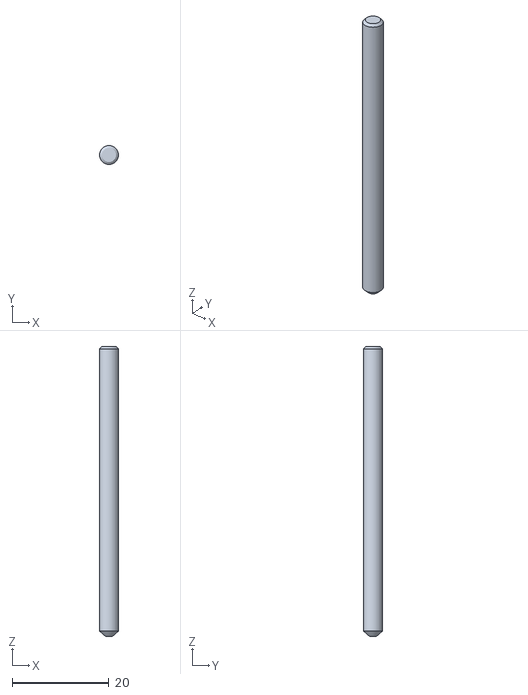
[picture p102: CAD file, 2026-10-02]
14-build/pad/cad/stl/PD15_nail_reference.stl
3.92 x 3.92 x 59.9
