miketaz100/project-scratch/14-build/S0/cad/stl/D15_lift_gauge.stl

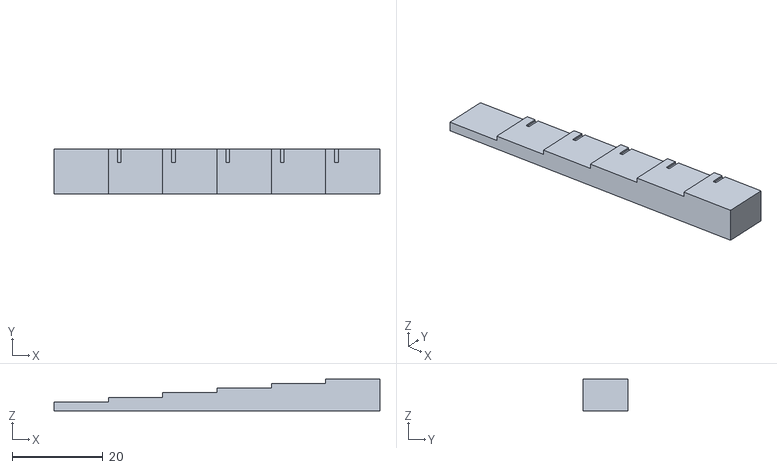
[picture p103: CAD file, 2026-10-02]
14-build/S0/cad/stl/D15_lift_gauge.stl
72.0 x 10.0 x 7.00
