miketaz100/project-scratch/05-engineering/cad/frame/stl/p23_rail_down_stop.stl

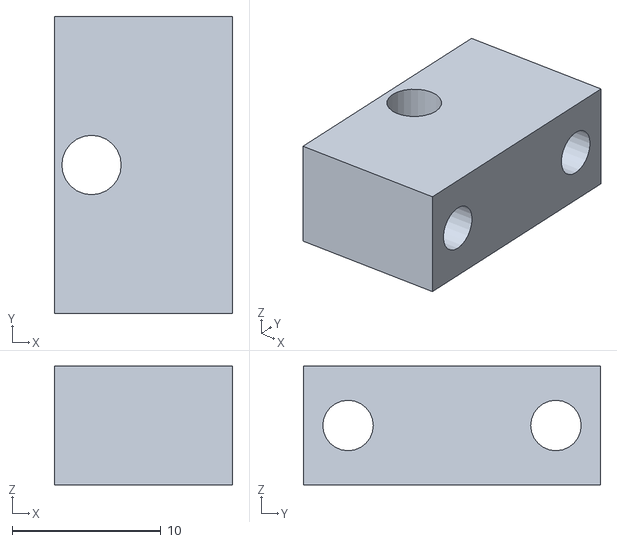
[picture p104: CAD file, 2026-10-01]
05-engineering/cad/frame/stl/p23_rail_down_stop.stl
12.0 x 20.0 x 8.00
