miketaz100/project-scratch/14-build/drivebox/cad/stl/DB01_drum.stl

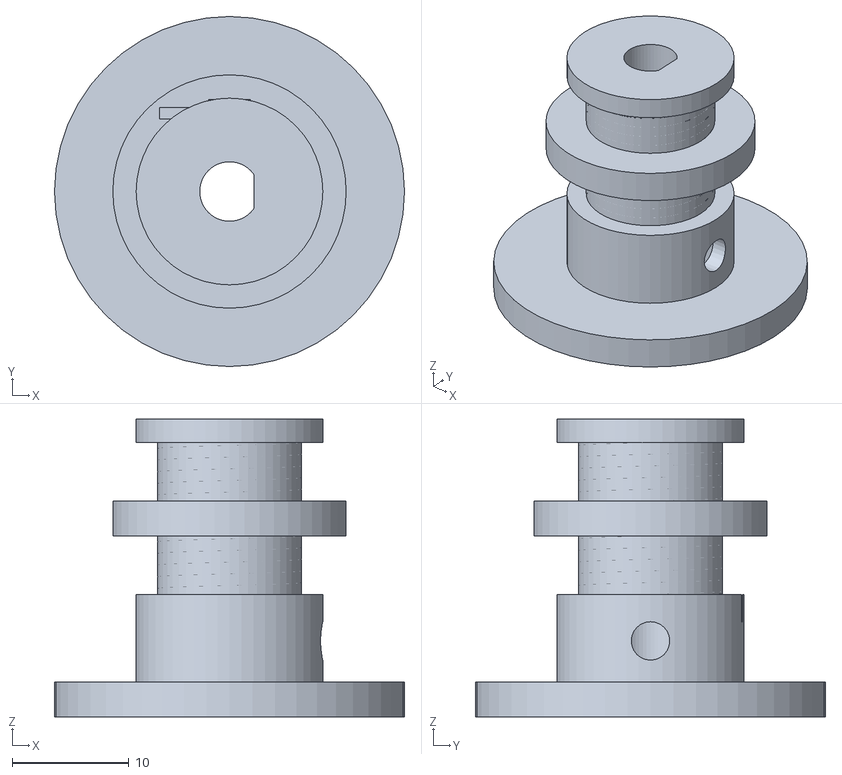
[picture p105: CAD file, 2026-10-02]
14-build/drivebox/cad/stl/DB01_drum.stl
30.0 x 30.0 x 25.5
