miketaz100/project-scratch/14-build/halo/cad/stl/H16_harness_clip.stl

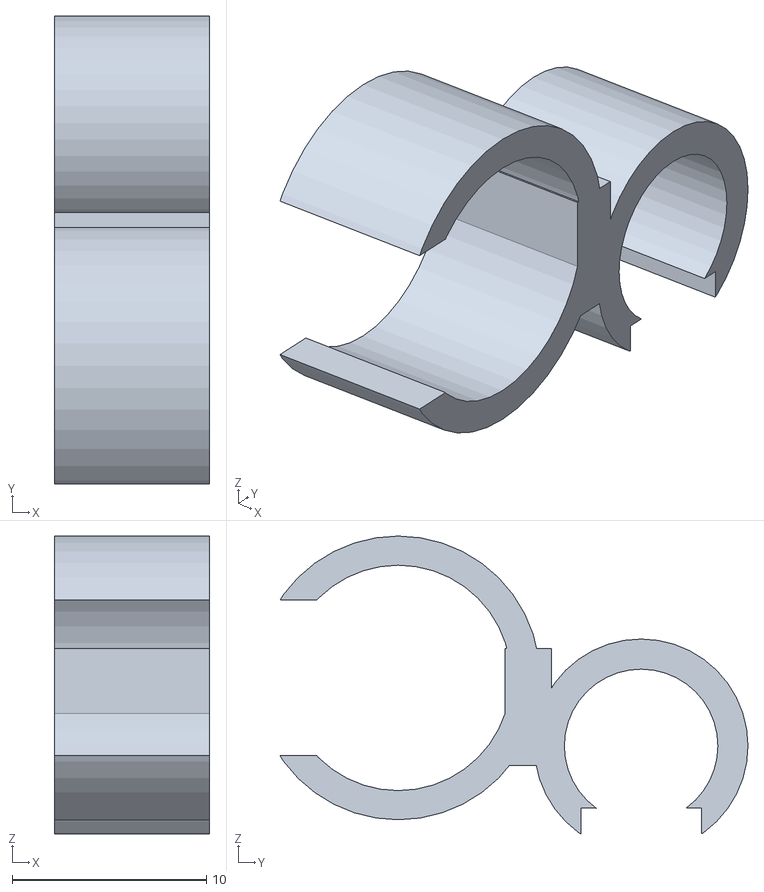
[picture p106: CAD file, 2026-10-02]
14-build/halo/cad/stl/H16_harness_clip.stl
8.00 x 24.1 x 15.3
