miketaz100/project-scratch/14-build/S0/cad/stl/D10_template_T2_dpath.stl

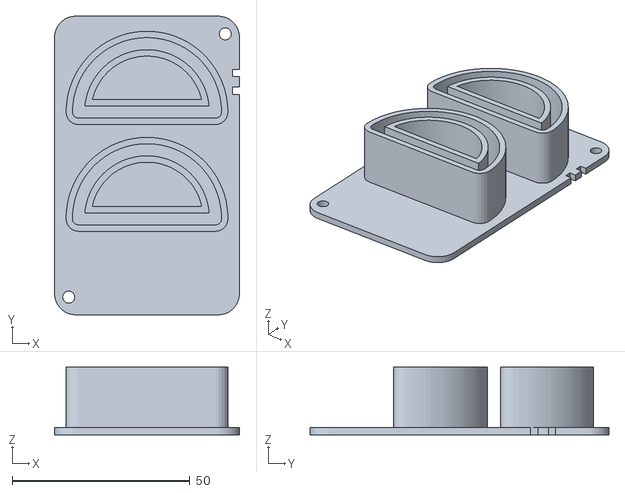
[picture p107: CAD file, 2026-10-02]
14-build/S0/cad/stl/D10_template_T2_dpath.stl
52.0 x 84.0 x 19.0
