miketaz100/project-scratch/14-build/halo/cad/stl/H10_carriage.stl

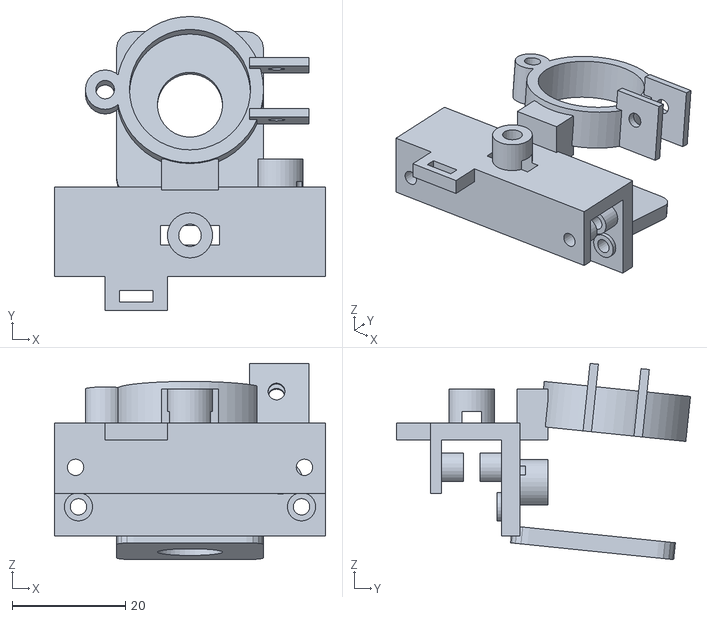
[picture p108: CAD file, 2026-10-02]
14-build/halo/cad/stl/H10_carriage.stl
48.0 x 52.0 x 34.7
