miketaz100/project-scratch/14-build/S0/cad/stl/T03_stop_block.stl

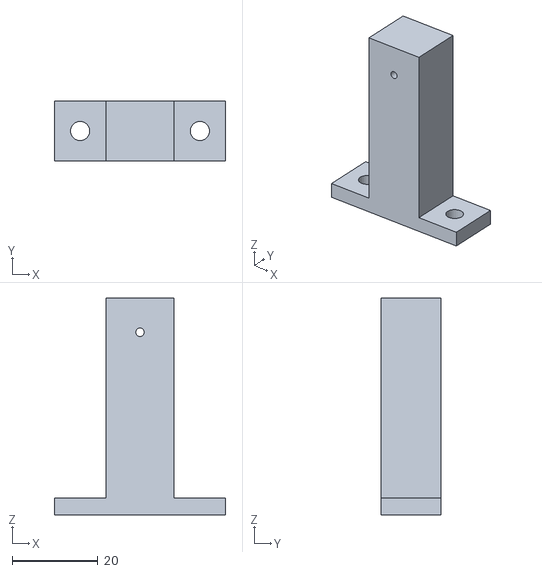
[picture p109: CAD file, 2026-10-02]
14-build/S0/cad/stl/T03_stop_block.stl
40.0 x 14.0 x 50.8
