miketaz100/project-scratch/05-engineering/cad/frame/stl/p42_cradle_tilt_wedge.stl

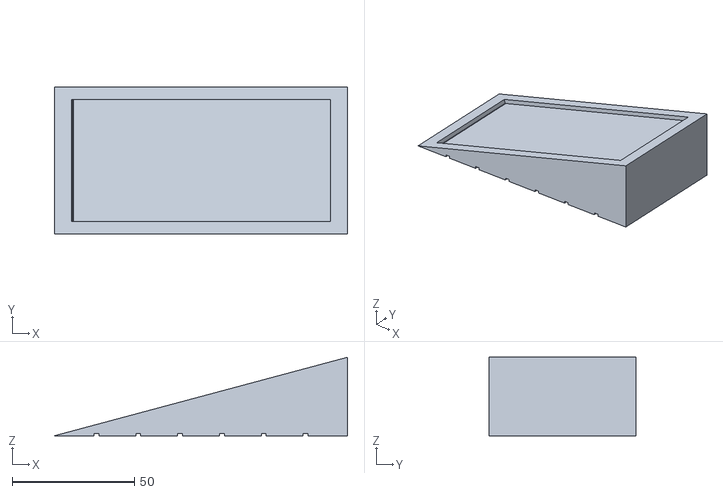
[picture p110: CAD file, 2026-10-01]
05-engineering/cad/frame/stl/p42_cradle_tilt_wedge.stl
120.0 x 60.0 x 32.2
