miketaz100/project-scratch/14-build/drivebox/cad/stl/DB11_hook_55.stl

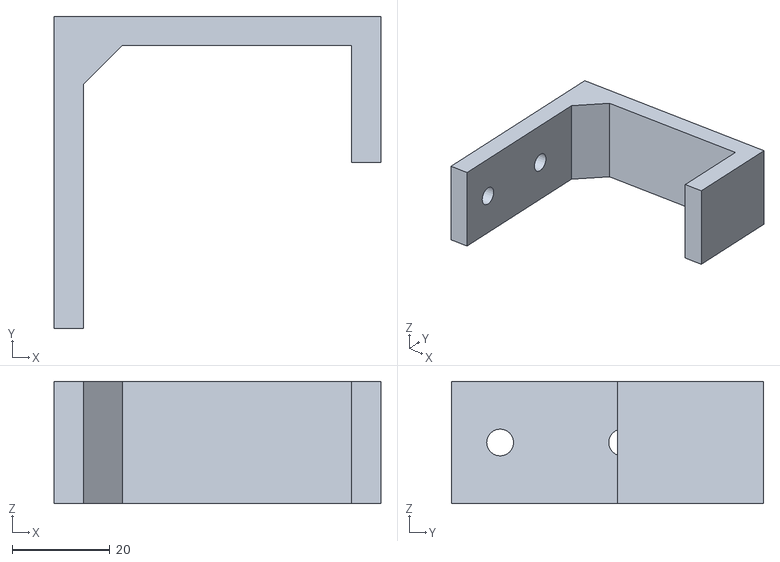
[picture p111: CAD file, 2026-10-02]
14-build/drivebox/cad/stl/DB11_hook_55.stl
67.0 x 64.0 x 25.0
