miketaz100/project-scratch/14-build/halo/cad/stl/H04L_foot_left.stl

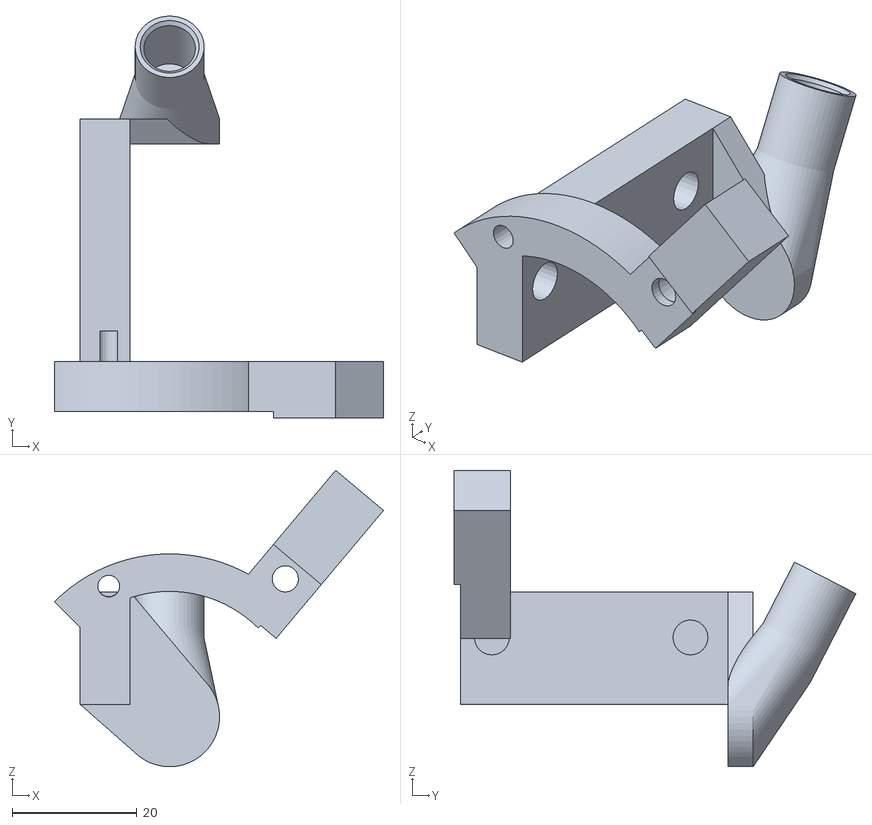
[picture p112: CAD file, 2026-10-02]
14-build/halo/cad/stl/H04L_foot_left.stl
52.7 x 64.3 x 47.5
