miketaz100/project-scratch/14-build/S0/cad/stl/D05_seat_disc.stl

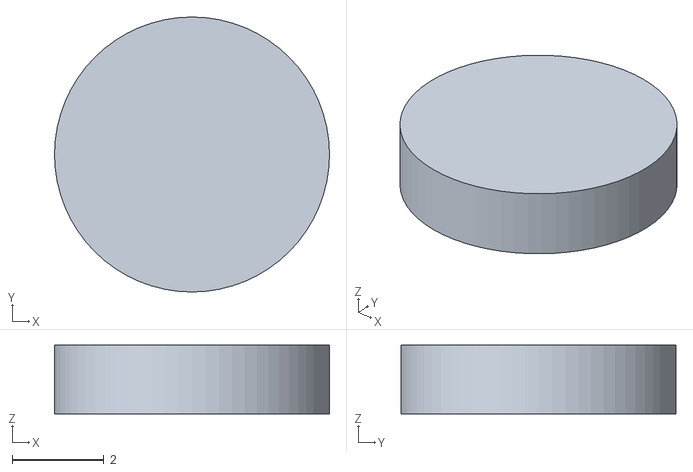
[picture p113: CAD file, 2026-10-02]
14-build/S0/cad/stl/D05_seat_disc.stl
6.00 x 6.00 x 1.50
