miketaz100/project-scratch/05-engineering/cad/frame/stl/p04_electronics_tray_lid.stl

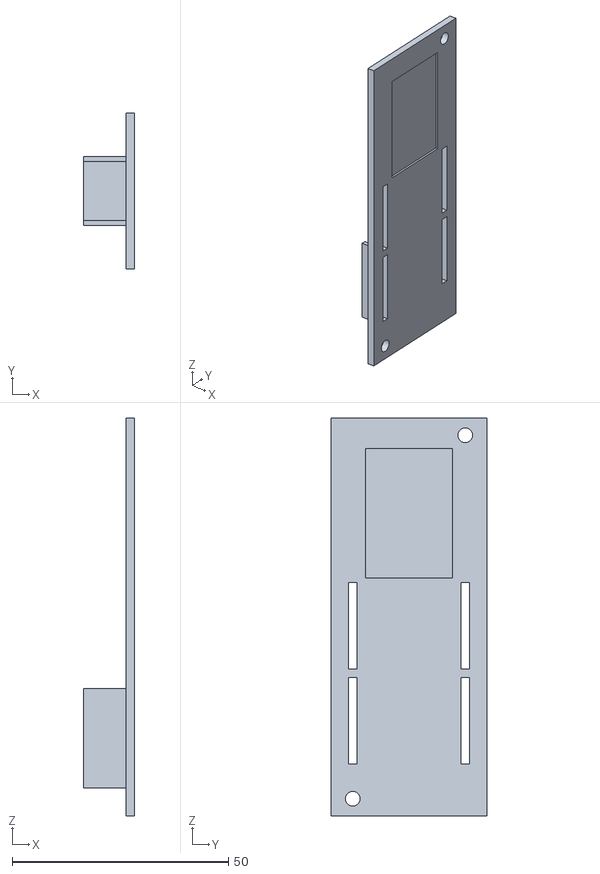
[picture p114: CAD file, 2026-10-01]
05-engineering/cad/frame/stl/p04_electronics_tray_lid.stl
11.8 x 36.0 x 92.0
