miketaz100/project-scratch/14-build/drivebox/cad/stl/DB04_hall_bridge.stl

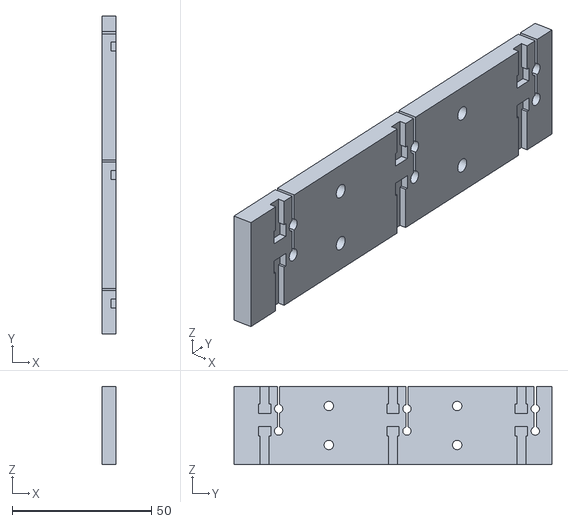
[picture p115: CAD file, 2026-10-02]
14-build/drivebox/cad/stl/DB04_hall_bridge.stl
5.00 x 114.0 x 28.0
