miketaz100/project-scratch/14-build/halo/cad/stl/H11_beta_stop.stl

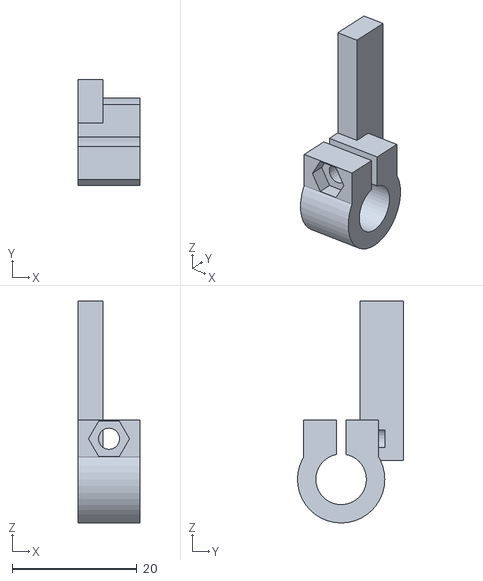
[picture p116: CAD file, 2026-10-02]
14-build/halo/cad/stl/H11_beta_stop.stl
10.0 x 17.0 x 35.6
