miketaz100/project-scratch/14-build/S0/cad/stl/D12_skid_ring_hand_rake.stl

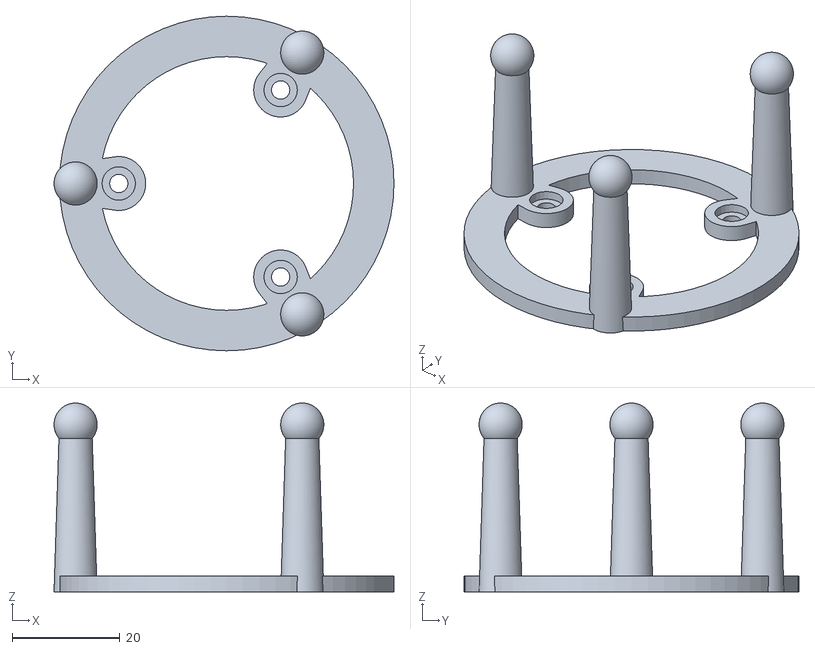
[picture p117: CAD file, 2026-10-02]
14-build/S0/cad/stl/D12_skid_ring_hand_rake.stl
63.0 x 62.0 x 35.0
