miketaz100/project-scratch/05-engineering/cad/frame/stl/p08_frame_yaw_plate.stl

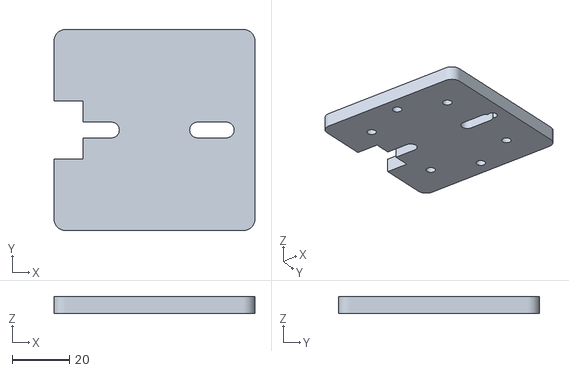
[picture p118: CAD file, 2026-10-01]
05-engineering/cad/frame/stl/p08_frame_yaw_plate.stl
70.0 x 70.0 x 6.00
