miketaz100/project-scratch/14-build/halo/cad/stl/H05R_foot_right.stl

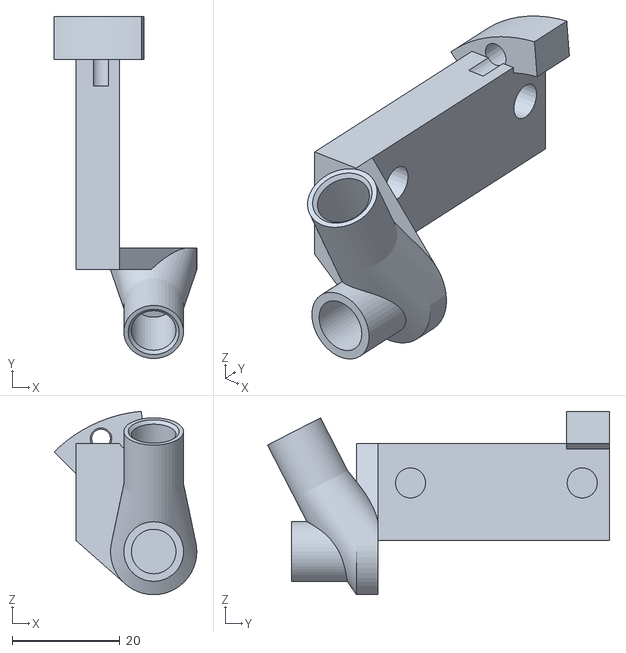
[picture p119: CAD file, 2026-10-02]
14-build/halo/cad/stl/H05R_foot_right.stl
26.4 x 63.3 x 34.0
