miketaz100/project-scratch/14-build/S0/cad/stl/D02_dish_block.stl

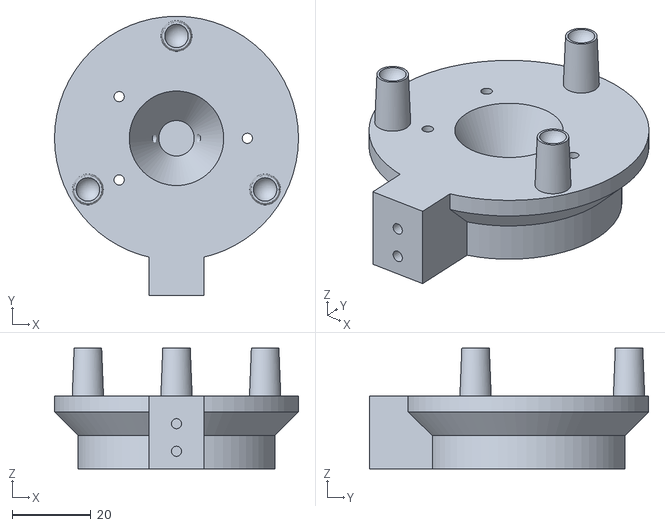
[picture p120: CAD file, 2026-10-02]
14-build/S0/cad/stl/D02_dish_block.stl
62.0 x 71.0 x 30.7
