miketaz100/project-scratch/05-engineering/cad/frame/stl/p02_pulley_sheave.stl

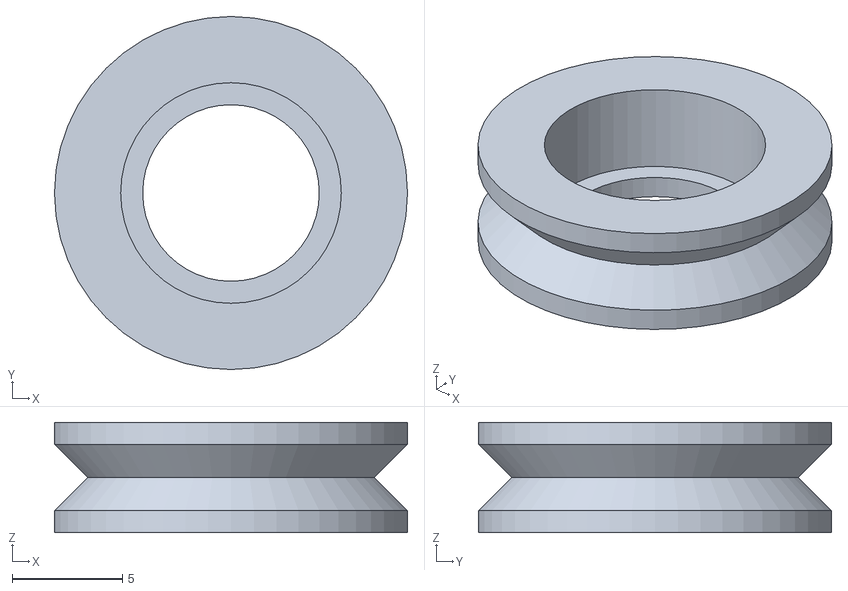
[picture p121: CAD file, 2026-10-01]
05-engineering/cad/frame/stl/p02_pulley_sheave.stl
16.0 x 16.0 x 5.00
