miketaz100/project-scratch/14-build/halo/cad/stl/H01R_hub_plate.stl

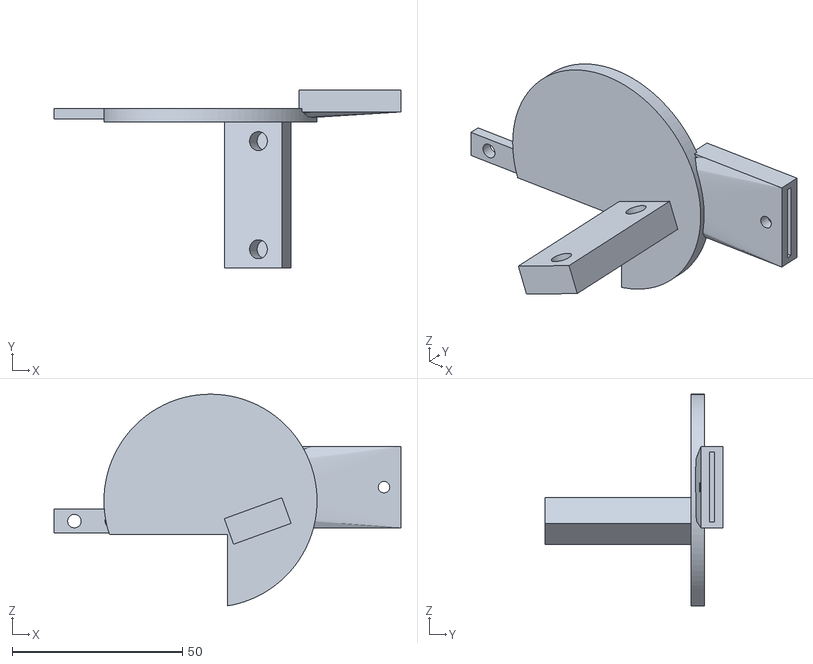
[picture p122: CAD file, 2026-10-02]
14-build/halo/cad/stl/H01R_hub_plate.stl
102.0 x 52.4 x 62.2
