miketaz100/project-scratch/14-build/S0/cad/stl/D14_side_mock_70x150.stl

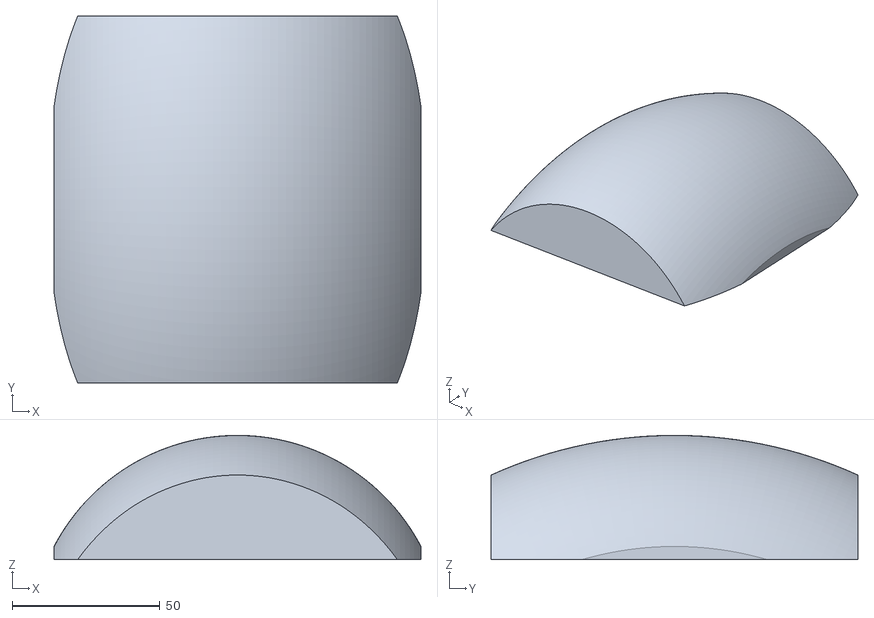
[picture p123: CAD file, 2026-10-02]
14-build/S0/cad/stl/D14_side_mock_70x150.stl
124.0 x 124.0 x 42.0
