miketaz100/project-scratch/05-engineering/cad/frame/stl/p33_palm_lid.stl

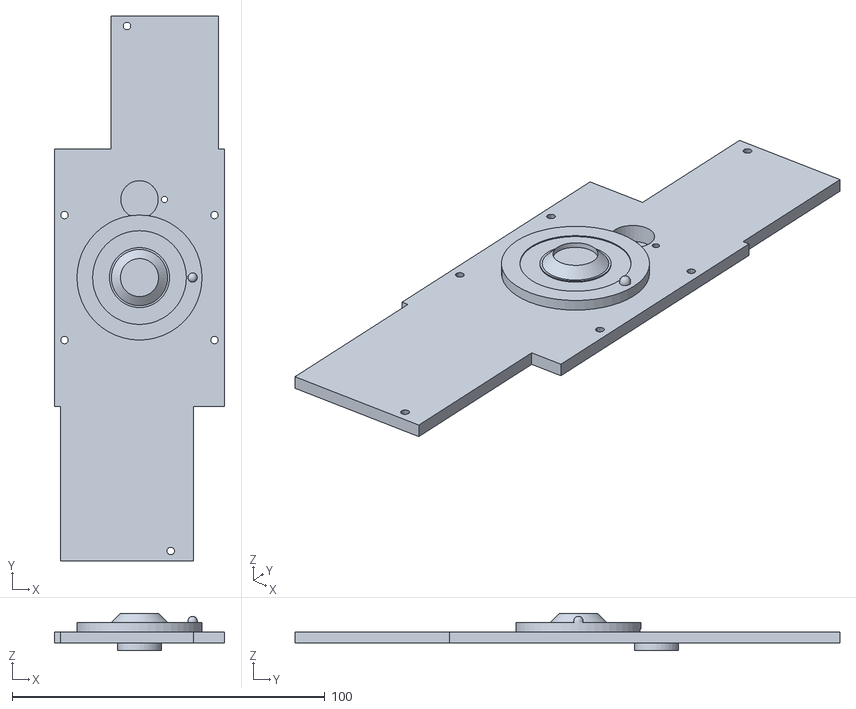
[picture p124: CAD file, 2026-10-01]
05-engineering/cad/frame/stl/p33_palm_lid.stl
54.4 x 174.4 x 11.9
