miketaz100/project-scratch/14-build/S0/cad/stl/D16_nail_N35_reserve3p5.stl

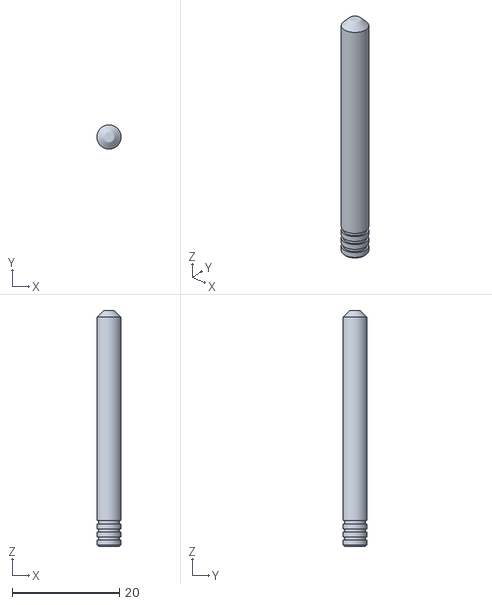
[picture p125: CAD file, 2026-10-02]
14-build/S0/cad/stl/D16_nail_N35_reserve3p5.stl
4.50 x 4.50 x 43.9
