miketaz100/project-scratch/05-engineering/cad/frame/stl/p39_button_housing_half_a.stl

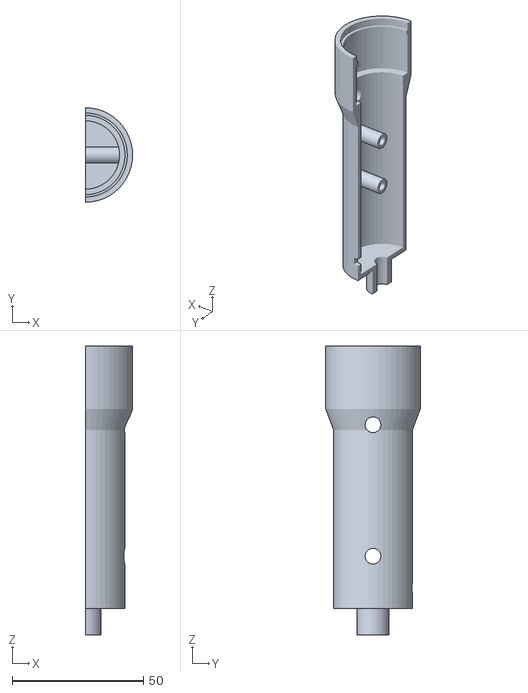
[picture p126: CAD file, 2026-10-01]
05-engineering/cad/frame/stl/p39_button_housing_half_a.stl
18.0 x 36.0 x 110.0
