miketaz100/project-scratch/14-build/halo/cad/stl/H18b_umb_cup.stl

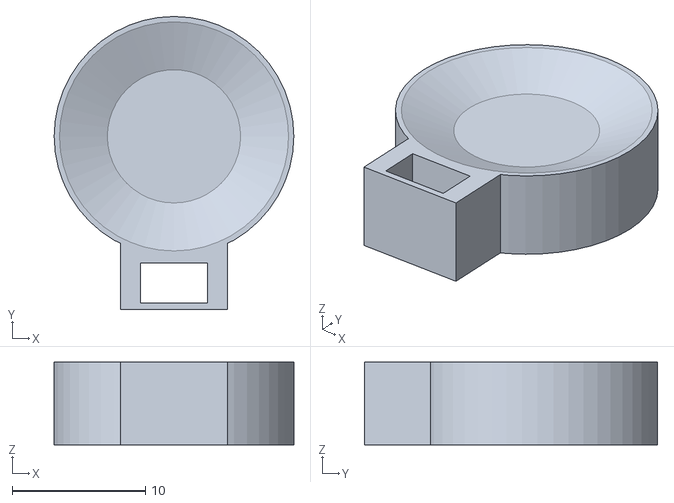
[picture p127: CAD file, 2026-10-02]
14-build/halo/cad/stl/H18b_umb_cup.stl
18.0 x 22.0 x 6.20
