miketaz100/project-scratch/14-build/S0/cad/stl/D13_ball_cradle.stl

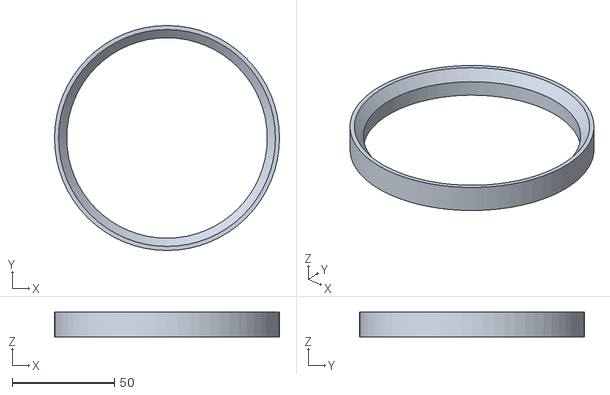
[picture p128: CAD file, 2026-10-02]
14-build/S0/cad/stl/D13_ball_cradle.stl
110.0 x 110.0 x 12.0
