miketaz100/project-scratch/14-build/S0/cad/stl/D09_template_T1_line_star.stl

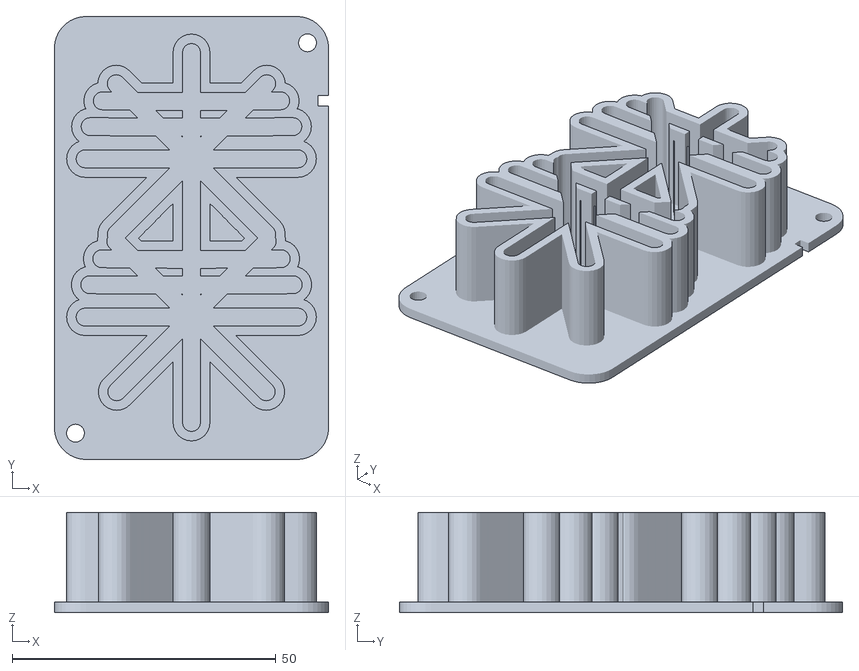
[picture p129: CAD file, 2026-10-02]
14-build/S0/cad/stl/D09_template_T1_line_star.stl
52.0 x 84.0 x 19.0
