miketaz100/project-scratch/05-engineering/cad/frame/stl/p22_rail_shroud.stl

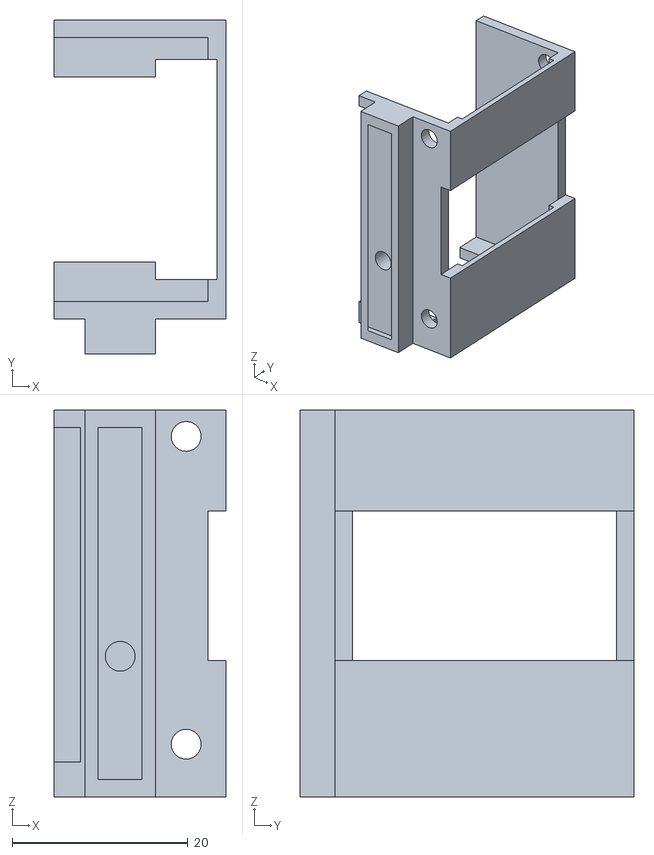
[picture p130: CAD file, 2026-10-01]
05-engineering/cad/frame/stl/p22_rail_shroud.stl
19.5 x 38.0 x 44.0
