miketaz100/project-scratch/14-build/S0/cad/stl/T04_housing_sleeve.stl

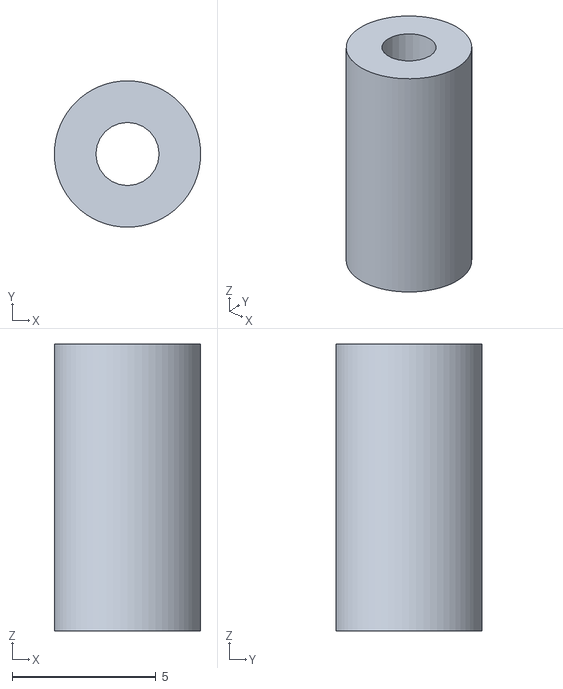
[picture p131: CAD file, 2026-10-02]
14-build/S0/cad/stl/T04_housing_sleeve.stl
5.10 x 5.10 x 10.0
