miketaz100/project-scratch/05-engineering/cad/frame/stl/p47_load_cell_filler.stl

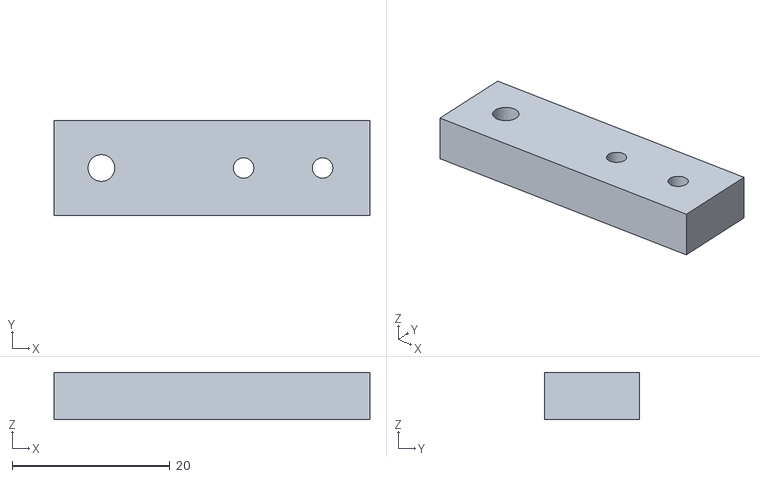
[picture p132: CAD file, 2026-10-01]
05-engineering/cad/frame/stl/p47_load_cell_filler.stl
40.0 x 12.0 x 6.00
