miketaz100/project-scratch/14-build/S0/cad/stl/D06_nail_N20_reserve2.stl

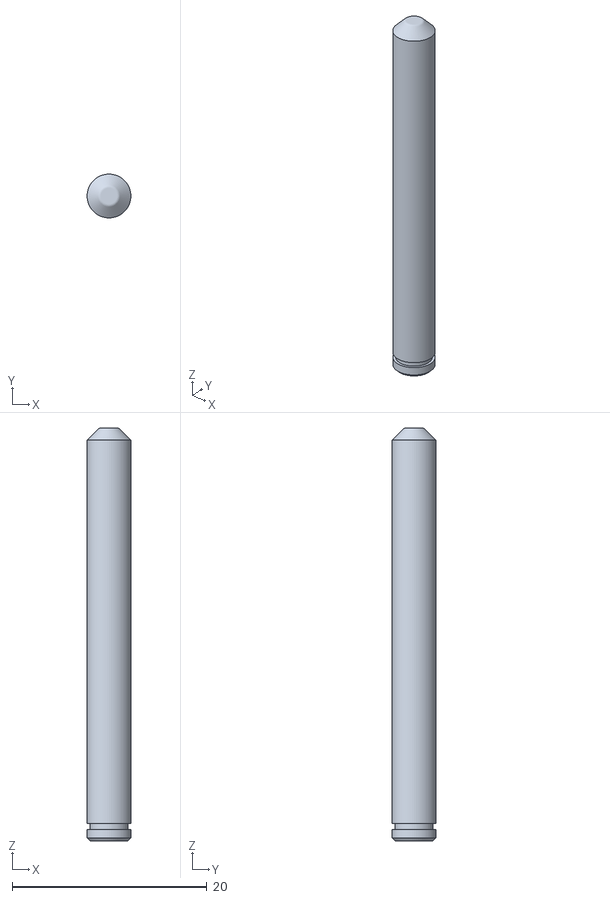
[picture p133: CAD file, 2026-10-02]
14-build/S0/cad/stl/D06_nail_N20_reserve2.stl
4.50 x 4.50 x 42.4
