miketaz100/project-scratch/05-engineering/cad/frame/stl/p03_electronics_tray.stl

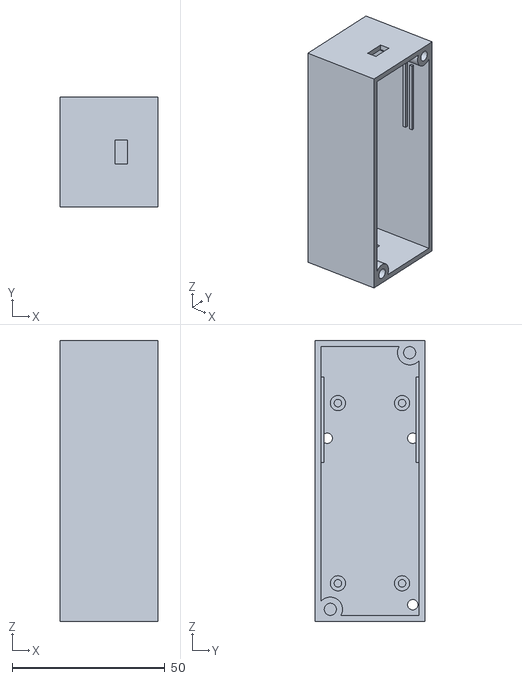
[picture p134: CAD file, 2026-10-01]
05-engineering/cad/frame/stl/p03_electronics_tray.stl
32.0 x 36.0 x 92.0
