miketaz100/project-scratch/14-build/S0/cad/stl/T05_rig_deck.stl

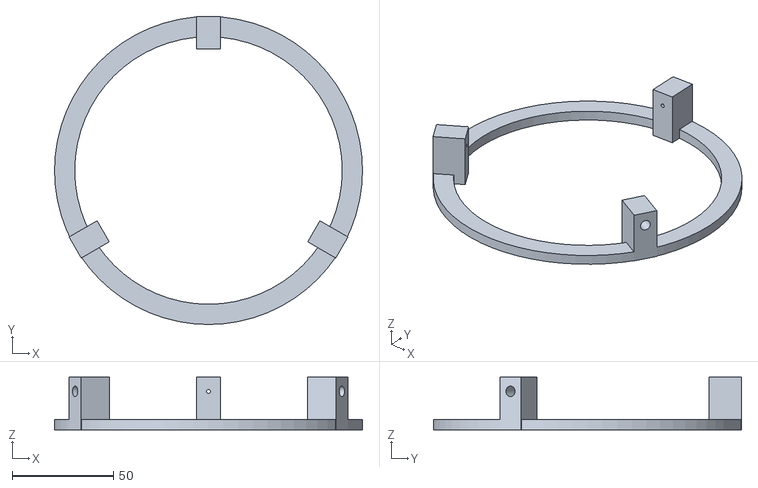
[picture p135: CAD file, 2026-10-02]
14-build/S0/cad/stl/T05_rig_deck.stl
152.0 x 152.0 x 26.0
