miketaz100/project-scratch/05-engineering/cad/frame/stl/p21_yoke_crossbar.stl

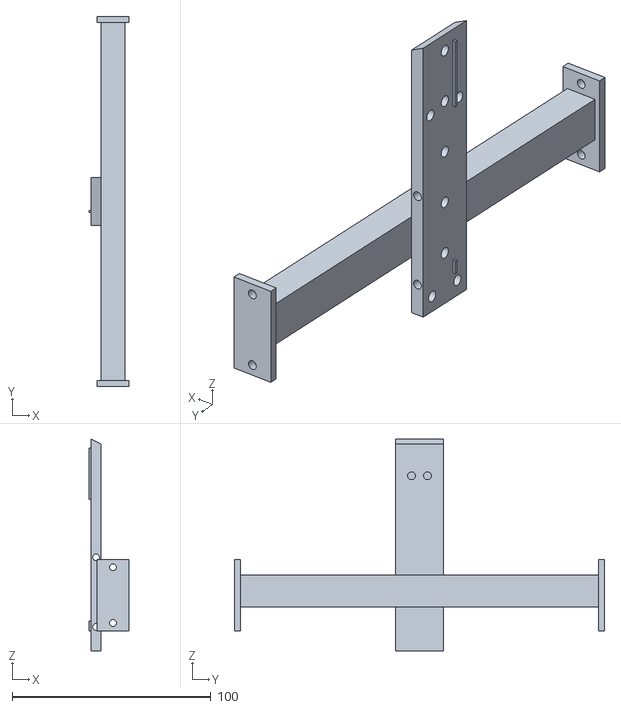
[picture p136: CAD file, 2026-10-01]
05-engineering/cad/frame/stl/p21_yoke_crossbar.stl
20.0 x 186.0 x 106.4
