miketaz100/project-scratch/14-build/S0/cad/stl/T01_drum.stl

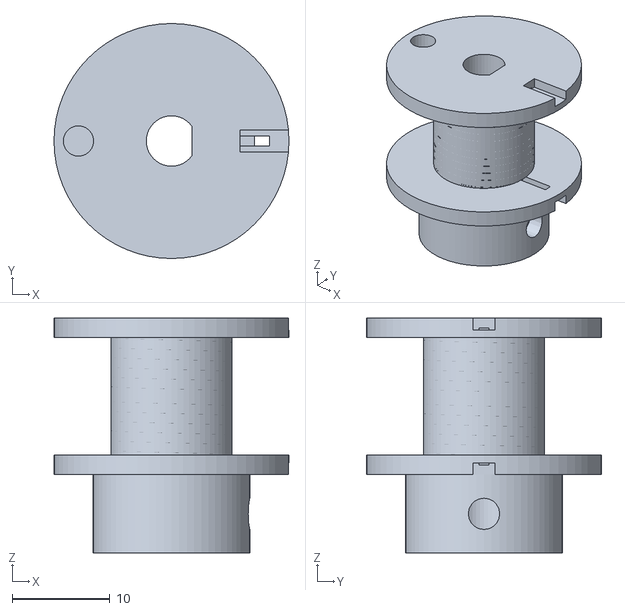
[picture p137: CAD file, 2026-10-02]
14-build/S0/cad/stl/T01_drum.stl
24.0 x 24.0 x 24.0
