miketaz100/project-scratch/05-engineering/cad/frame/stl/p26_carriage_riser.stl

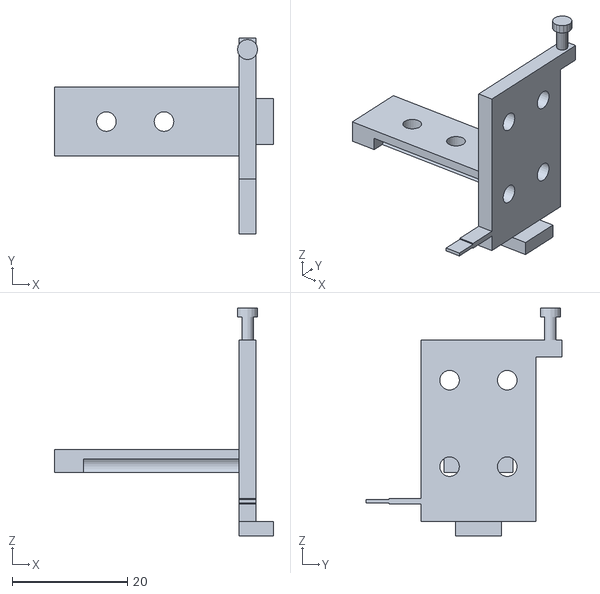
[picture p138: CAD file, 2026-10-01]
05-engineering/cad/frame/stl/p26_carriage_riser.stl
38.0 x 34.0 x 39.5
