miketaz100/project-scratch/14-build/S0/cad/stl/D01_dish_deck.stl

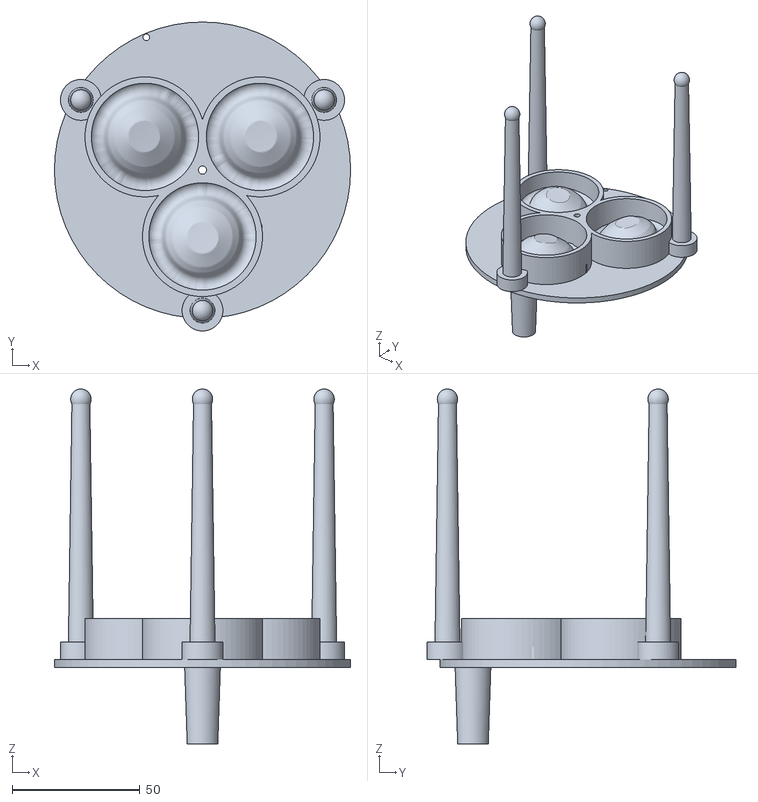
[picture p139: CAD file, 2026-10-02]
14-build/S0/cad/stl/D01_dish_deck.stl
116.0 x 121.0 x 139.0
