miketaz100/project-scratch/05-engineering/cad/frame/stl/p19_yoke_cheek_a.stl

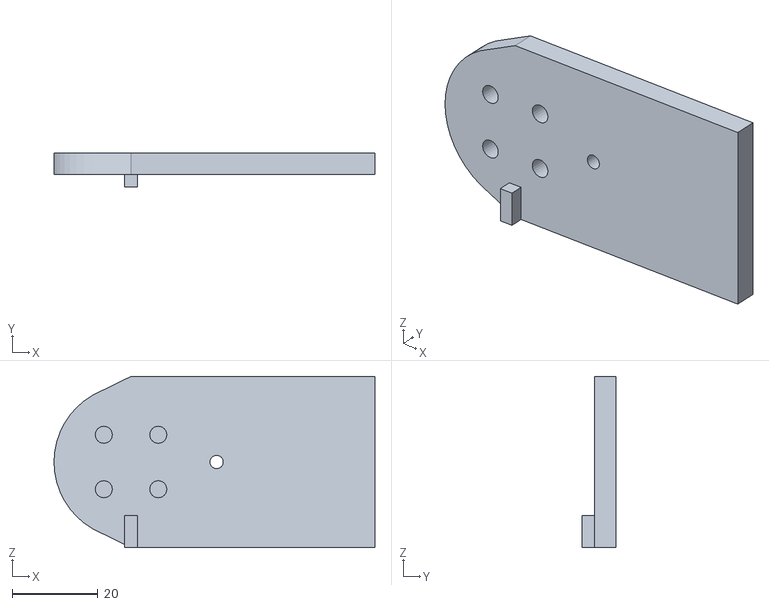
[picture p140: CAD file, 2026-10-01]
05-engineering/cad/frame/stl/p19_yoke_cheek_a.stl
75.0 x 8.00 x 40.0
