miketaz100/project-scratch/14-build/S0/cad/stl/D11_template_T3_circle.stl

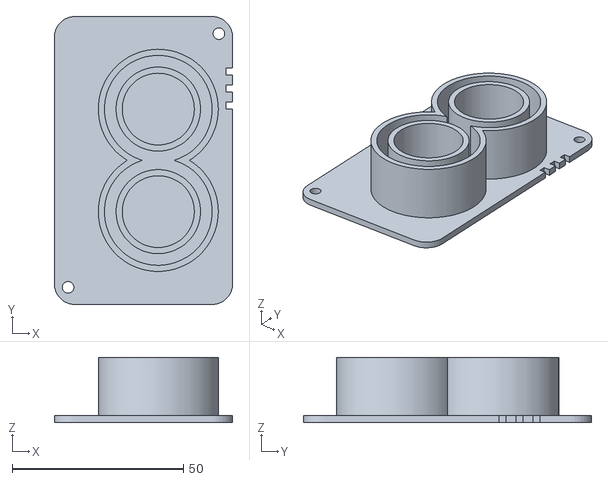
[picture p141: CAD file, 2026-10-02]
14-build/S0/cad/stl/D11_template_T3_circle.stl
52.0 x 84.0 x 19.0
