miketaz100/project-scratch/05-engineering/cad/frame/stl/p06_keeper_lever.stl

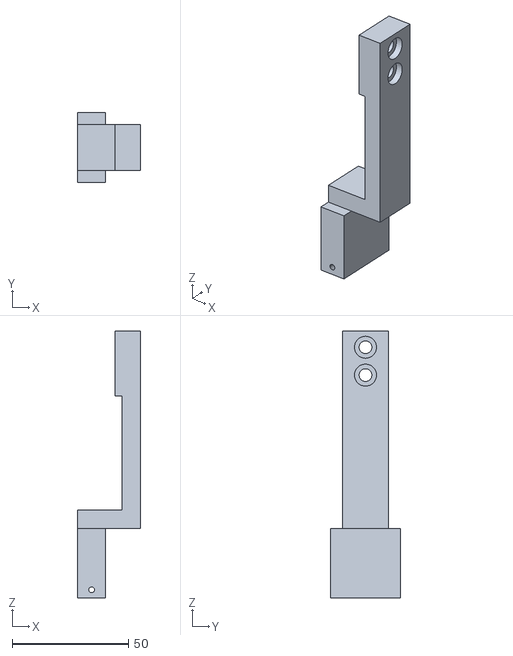
[picture p142: CAD file, 2026-10-01]
05-engineering/cad/frame/stl/p06_keeper_lever.stl
27.0 x 30.0 x 115.0
