miketaz100/project-scratch/05-engineering/cad/frame/stl/p24_rail_up_stop.stl

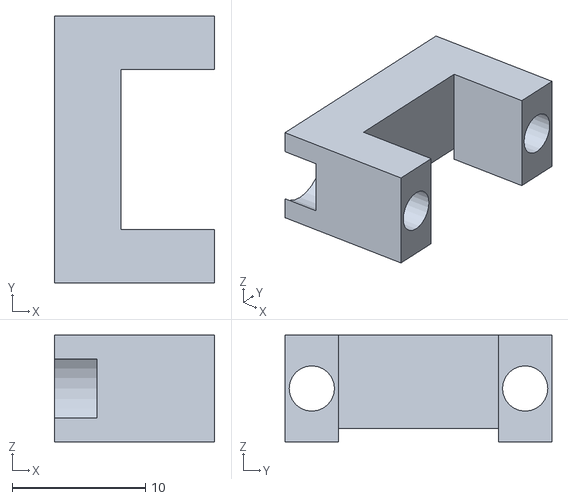
[picture p143: CAD file, 2026-10-01]
05-engineering/cad/frame/stl/p24_rail_up_stop.stl
12.0 x 20.0 x 8.00
