miketaz100/project-scratch/05-engineering/cad/frame/stl/p38_control_panel_lid.stl

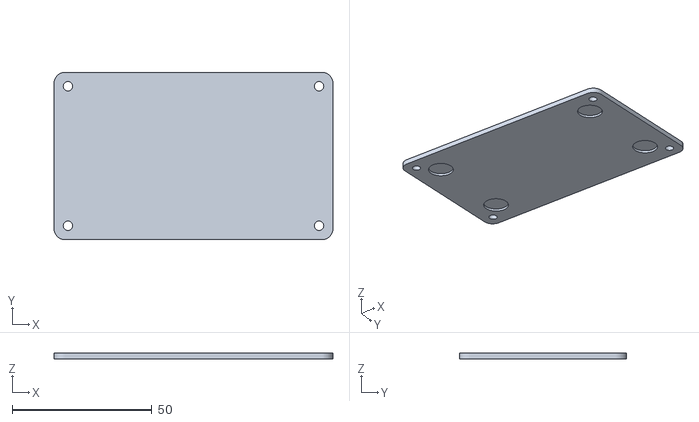
[picture p144: CAD file, 2026-10-01]
05-engineering/cad/frame/stl/p38_control_panel_lid.stl
100.0 x 60.0 x 2.00
