miketaz100/project-scratch/14-build/pad/cad/pd01_deck.scad

// pd01_deck.scad - SP1 v3 PAD part (installed position, frame P). Source: lib_pad.scad. STL: stl/PD01_deck.stl (gen_pad_stl.py)
include <lib_pad.scad>
pd01_deck();
