miketaz100/project-scratch/14-build/pad/cad/pd06_cartridge.scad

// pd06_cartridge.scad - SP1 v3 PAD part (installed position, frame P). Source: lib_pad.scad. STL: stl/PD06_cartridge.stl (gen_pad_stl.py)
include <lib_pad.scad>
pd06_cartridge(PINS[1][0], PINS[1][1]);
