miketaz100/project-scratch/14-build/pad/cad/pd09_piston.scad

// pd09_piston.scad - SP1 v3 PAD part (installed position, frame P). Source: lib_pad.scad. STL: stl/PD09_piston.stl (gen_pad_stl.py)
include <lib_pad.scad>
pd09_piston(PINS[1][0], PINS[1][1]);
