miketaz100/project-scratch/14-build/pad/cad/pd15_nail_reference.scad

// pd15_nail_reference.scad - SP1 v3 PAD part (installed position, frame P). Source: lib_pad.scad. STL: stl/PD15_nail_reference.stl (gen_pad_stl.py)
include <lib_pad.scad>
pd15_nail(PINS[1][0], PINS[1][1]);
