miketaz100/project-scratch/14-build/pad/cad/pd19_s0_pocket.scad

// pd19_s0_pocket.scad - S0 single-pocket dish bench. Source: lib_pad.scad. STL: stl/PD19_s0_pocket.stl
include <lib_pad.scad>
pd19_s0_pocket();
