miketaz100/project-scratch/14-build/pad/cad/pockets_data.scad

// pockets_data.scad - GENERATED by gen_pad_stl.py from pockets.npz (pad_geom2.py). Do not edit.
POCKET_RS = [0.000, 0.473, 0.945, 1.418, 1.890, 2.363, 2.835, 3.308, 3.781, 4.253, 4.726, 5.198, 5.671, 6.143, 6.616, 7.089, 7.561, 8.034, 8.506, 8.979, 9.451, 9.924, 10.397, 10.869, 11.342, 11.814, 12.287, 12.759, 13.232, 13.705, 14.177, 14.650, 15.122, 15.595, 16.067, 16.540, 17.012, 17.485, 17.958, 18.430, 18.903, 19.375, 19.848, 20.320, 20.793, 21.266, 21.738, 22.211, 22.683, 23.156, 23.628, 24.101, 24.574, 25.046, 25.519, 25.991, 26.464, 26.936, 27.409, 27.882, 28.354, 28.827, 29.299, 29.772, 30.244, 30.717, 31.190, 31.662, 32.135];
POCKET_TH = [0.000, 2.500, 5.000, 7.500, 10.000, 12.500, 15.000, 17.500, 20.000, 22.500, 25.000, 27.500, 30.000, 32.500, 35.000, 37.500, 40.000, 42.500, 45.000, 47.500, 50.000, 52.500, 55.000, 57.500, 60.000, 62.500, 65.000, 67.500, 70.000, 72.500, 75.000, 77.500, 80.000, 82.500, 85.000, 87.500, 90.000, 92.500, 95.000, 97.500, 100.000, 102.500, 105.000, 107.500, 110.000, 112.500, 115.000, 117.500, 120.000, 122.500, 125.000, 127.500, 130.000, 132.500, 135.000, 137.500, 140.000, 142.500, 145.000, 147.500, 150.000, 152.500, 155.000, 157.500, 160.000, 162.500, 165.000, 167.500, 170.000, 172.500, 175.000, 177.500, 180.000, 182.500, 185.000, 187.500, 190.000, 192.500, 195.000, 197.500, 200.000, 202.500, 205.000, 207.500, 210.000, 212.500, 215.000, 217.500, 220.000, 222.500, 225.000, 227.500, 230.000, 232.500, 235.000, 237.500, 240.000, 242.500, 245.000, 247.500, 250.000, 252.500, 255.000, 257.500, 260.000, 262.500, 265.000, 267.500, 270.000, 272.500, 275.000, 277.500, 280.000, 282.500, 285.000, 287.500, 290.000, 292.500, 295.000, 297.500, 300.000, 302.500, 305.000, 307.500, 310.000, 312.500, 315.000, 317.500, 320.000, 322.500, 325.000, 327.500, 330.000, 332.500, 335.000, 337.500, 340.000, 342.500, 345.000, 347.500, 350.000, 352.500, 355.000, 357.500];
POCKET_HOMES = [[32.909, 19.000, 91.500], [-32.909, 19.000, 91.500], [-0.000, -38.000, 91.500]];
POCKET_Z0 = [[94.705, 94.705, 94.705, 94.705, 94.705, 94.705, 94.705, 94.705, 94.705, 94.705, 94.705, 94.705, 94.705, 94.705, 94.705, 94.705, 94.705, 94.705, 94.705, 94.705, 94.705, 94.705, 94.705, 94.705, 94.705, 94.705, 94.705, 94.705, 94.705, 94.705, 94.705, 94.705, 94.705, 94.705, 94.705, 94.705, 94.705, 94.705, 94.705, 94.705, 94.705, 94.705, 94.705, 94.705, 94.705, 94.705, 94.705, 94.705, 94.705, 94.705, 94.705, 94.705, 94.705, 94.705, 94.705, 94.705, 94.705, 94.705, 94.705, 94.705, 94.705, 94.705, 94.705, 94.705, 94.705, 94.705, 94.705, 94.705, 94.705, 94.705, 94.705, 94.705, 94.705, 94.705, 94.705, 94.705, 94.705, 94.705, 94.705, 94.705, 94.705, 94.705, 94.705, 94.705, 94.705, 94.705, 94.705, 94.705, 94.705, 94.705, 94.705, 94.705, 94.705, 94.705, 94.705, 94.705, 94.705, 94.705, 94.705, 94.705, 94.705, 94.705, 94.705, 94.705, 94.705, 94.705, 94.705, 94.705, 94.705, 94.705, 94.705, 94.705, 94.705, 94.705, 94.705, 94.705, 94.705, 94.705, 94.705, 94.705, 94.705, 94.705, 94.705, 94.705, 94.705, 94.705, 94.705, 94.705, 94.705, 94.705, 94.705, 94.705, 94.705, 94.705, 94.705, 94.705, 94.705, 94.705, 94.705, 94.705, 94.705, 94.705, 94.705, 94.705], [94.640, 94.640, 94.640, 94.640, 94.640, 94.640, 94.640, 94.640, 94.640, 94.640, 94.640, 94.640, 94.640, 94.640, 94.640, 94.640, 94.640, 94.640, 94.640, 94.640, 94.640, 94.640, 94.640, 94.640, 94.640, 94.640, 94.640, 94.640, 94.644, 94.647, 94.651, 94.654, 94.658, 94.661, 94.664, 94.668, 94.671, 94.674, 94.677, 94.680, 94.683, 94.687, 94.689, 94.692, 94.695, 94.698, 94.701, 94.704, 94.706, 94.709, 94.711, 94.714, 94.716, 94.719, 94.721, 94.723, 94.725, 94.727, 94.729, 94.731, 94.733, 94.735, 94.737, 94.738, 94.740, 94.742, 94.743, 94.744, 94.746, 94.747, 94.748, 94.751, 94.753, 94.755, 94.756, 94.758, 94.759, 94.760, 94.761, 94.762, 94.763, 94.764, 94.764, 94.764, 94.764, 94.764, 94.764, 94.764, 94.763, 94.762, 94.761, 94.760, 94.759, 94.758, 94.756, 94.755, 94.753, 94.751, 94.748, 94.747, 94.746, 94.744, 94.743, 94.742, 94.740, 94.738, 94.737, 94.735, 94.733, 94.731, 94.729, 94.727, 94.725, 94.723, 94.721, 94.719, 94.716, 94.714, 94.711, 94.709, 94.706, 94.704, 94.701, 94.698, 94.695, 94.692, 94.689, 94.687, 94.683, 94.680, 94.677, 94.674, 94.671, 94.668, 94.664, 94.661, 94.658, 94.654, 94.651, 94.647, 94.644, 94.640, 94.640, 94.640], [94.588, 94.585, 94.583, 94.580, 94.578, 94.576, 94.574, 94.572, 94.571, 94.570, 94.569, 94.569, 94.569, 94.569, 94.569, 94.570, 94.571, 94.572, 94.574, 94.576, 94.578, 94.580, 94.583, 94.585, 94.588, 94.591, 94.594, 94.597, 94.601, 94.604, 94.608, 94.611, 94.615, 94.618, 94.622, 94.626, 94.629, 94.633, 94.637, 94.640, 94.647, 94.654, 94.661, 94.668, 94.675, 94.682, 94.689, 94.696, 94.702, 94.709, 94.715, 94.721, 94.728, 94.734, 94.739, 94.745, 94.751, 94.756, 94.762, 94.766, 94.772, 94.776, 94.781, 94.785, 94.790, 94.793, 94.797, 94.801, 94.804, 94.808, 94.811, 94.813, 94.816, 94.819, 94.821, 94.823, 94.825, 94.826, 94.828, 94.829, 94.830, 94.831, 94.831, 94.831, 94.832, 94.831, 94.831, 94.831, 94.830, 94.829, 94.828, 94.826, 94.825, 94.823, 94.821, 94.819, 94.816, 94.813, 94.811, 94.808, 94.804, 94.801, 94.797, 94.793, 94.790, 94.785, 94.781, 94.776, 94.772, 94.766, 94.762, 94.756, 94.751, 94.745, 94.739, 94.734, 94.728, 94.721, 94.715, 94.709, 94.702, 94.696, 94.689, 94.682, 94.675, 94.668, 94.661, 94.654, 94.647, 94.640, 94.637, 94.633, 94.629, 94.626, 94.622, 94.618, 94.615, 94.611, 94.608, 94.604, 94.601, 94.597, 94.594, 94.591], [94.524, 94.519, 94.515, 94.510, 94.507, 94.503, 94.500, 94.498, 94.496, 94.494, 94.493, 94.492, 94.492, 94.492, 94.493, 94.494, 94.496, 94.498, 94.500, 94.503, 94.507, 94.510, 94.515, 94.519, 94.524, 94.529, 94.534, 94.540, 94.546, 94.552, 94.558, 94.565, 94.571, 94.578, 94.585, 94.592, 94.599, 94.607, 94.614, 94.621, 94.628, 94.636, 94.643, 94.650, 94.658, 94.665, 94.672, 94.679, 94.689, 94.700, 94.710, 94.720, 94.730, 94.740, 94.749, 94.758, 94.768, 94.776, 94.785, 94.793, 94.801, 94.809, 94.816, 94.824, 94.831, 94.838, 94.844, 94.849, 94.856, 94.861, 94.866, 94.871, 94.875, 94.880, 94.883, 94.886, 94.890, 94.892, 94.895, 94.897, 94.898, 94.900, 94.901, 94.901, 94.901, 94.901, 94.901, 94.900, 94.898, 94.897, 94.895, 94.892, 94.890, 94.886, 94.883, 94.880, 94.875, 94.871, 94.866, 94.861, 94.856, 94.849, 94.844, 94.838, 94.831, 94.824, 94.816, 94.809, 94.801, 94.793, 94.785, 94.776, 94.768, 94.758, 94.749, 94.740, 94.730, 94.720, 94.710, 94.700, 94.689, 94.679, 94.672, 94.665, 94.658, 94.650, 94.643, 94.636, 94.628, 94.621, 94.614, 94.607, 94.599, 94.592, 94.585, 94.578, 94.571, 94.565, 94.558, 94.552, 94.546, 94.540, 94.534, 94.529], [94.453, 94.447, 94.440, 94.435, 94.430, 94.426, 94.424, 94.421, 94.419, 94.418, 94.417, 94.416, 94.416, 94.416, 94.417, 94.418, 94.419, 94.421, 94.424, 94.426, 94.430, 94.435, 94.440, 94.447, 94.453, 94.460, 94.468, 94.475, 94.484, 94.493, 94.502, 94.511, 94.520, 94.531, 94.540, 94.551, 94.561, 94.572, 94.583, 94.593, 94.604, 94.615, 94.626, 94.637, 94.648, 94.659, 94.670, 94.681, 94.691, 94.702, 94.712, 94.723, 94.732, 94.743, 94.752, 94.765, 94.777, 94.790, 94.802, 94.813, 94.825, 94.835, 94.847, 94.856, 94.866, 94.876, 94.884, 94.893, 94.900, 94.909, 94.916, 94.923, 94.929, 94.934, 94.940, 94.944, 94.949, 94.953, 94.955, 94.959, 94.961, 94.963, 94.965, 94.964, 94.966, 94.964, 94.965, 94.963, 94.961, 94.959, 94.955, 94.953, 94.949, 94.944, 94.940, 94.934, 94.929, 94.923, 94.916, 94.909, 94.900, 94.893, 94.884, 94.876, 94.866, 94.856, 94.847, 94.835, 94.825, 94.813, 94.802, 94.790, 94.777, 94.765, 94.752, 94.743, 94.732, 94.723, 94.712, 94.702, 94.691, 94.681, 94.670, 94.659, 94.648, 94.637, 94.626, 94.615, 94.604, 94.593, 94.583, 94.572, 94.561, 94.551, 94.540, 94.531, 94.520, 94.511, 94.502, 94.493, 94.484, 94.475, 94.468, 94.460], [94.391, 94.385, 94.379, 94.373, 94.369, 94.364, 94.360, 94.358, 94.354, 94.353, 94.351, 94.350, 94.350, 94.350, 94.351, 94.353, 94.354, 94.358, 94.360, 94.364, 94.369, 94.373, 94.379, 94.385, 94.391, 94.398, 94.404, 94.413, 94.420, 94.429, 94.439, 94.451, 94.464, 94.475, 94.490, 94.502, 94.517, 94.530, 94.545, 94.559, 94.573, 94.588, 94.602, 94.617, 94.632, 94.646, 94.661, 94.675, 94.690, 94.704, 94.718, 94.731, 94.746, 94.758, 94.773, 94.785, 94.799, 94.811, 94.824, 94.835, 94.847, 94.859, 94.869, 94.883, 94.893, 94.908, 94.918, 94.930, 94.940, 94.950, 94.960, 94.966, 94.977, 94.983, 94.991, 94.997, 95.002, 95.008, 95.010, 95.016, 95.018, 95.021, 95.023, 95.022, 95.024, 95.022, 95.023, 95.021, 95.018, 95.016, 95.010, 95.008, 95.002, 94.997, 94.991, 94.983, 94.977, 94.966, 94.960, 94.950, 94.940, 94.930, 94.918, 94.908, 94.893, 94.883, 94.869, 94.859, 94.847, 94.835, 94.824, 94.811, 94.799, 94.785, 94.773, 94.758, 94.746, 94.731, 94.718, 94.704, 94.690, 94.675, 94.661, 94.646, 94.632, 94.617, 94.602, 94.588, 94.573, 94.559, 94.545, 94.530, 94.517, 94.502, 94.490, 94.475, 94.464, 94.451, 94.439, 94.429, 94.420, 94.413, 94.404, 94.398], [94.331, 94.321, 94.315, 94.308, 94.302, 94.297, 94.291, 94.288, 94.284, 94.282, 94.280, 94.278, 94.278, 94.278, 94.280, 94.282, 94.284, 94.288, 94.291, 94.297, 94.302, 94.308, 94.315, 94.321, 94.331, 94.339, 94.349, 94.359, 94.369, 94.380, 94.390, 94.404, 94.414, 94.428, 94.440, 94.454, 94.467, 94.483, 94.501, 94.518, 94.536, 94.553, 94.572, 94.590, 94.609, 94.626, 94.646, 94.663, 94.682, 94.699, 94.717, 94.735, 94.752, 94.770, 94.786, 94.803, 94.819, 94.836, 94.849, 94.867, 94.879, 94.896, 94.908, 94.923, 94.935, 94.947, 94.960, 94.970, 94.982, 94.989, 95.002, 95.009, 95.018, 95.027, 95.035, 95.044, 95.048, 95.057, 95.060, 95.067, 95.070, 95.072, 95.075, 95.074, 95.077, 95.074, 95.075, 95.072, 95.070, 95.067, 95.060, 95.057, 95.048, 95.044, 95.035, 95.027, 95.018, 95.009, 95.002, 94.989, 94.982, 94.970, 94.960, 94.947, 94.935, 94.923, 94.908, 94.896, 94.879, 94.867, 94.849, 94.836, 94.819, 94.803, 94.786, 94.770, 94.752, 94.735, 94.717, 94.699, 94.682, 94.663, 94.646, 94.626, 94.609, 94.590, 94.572, 94.553, 94.536, 94.518, 94.501, 94.483, 94.467, 94.454, 94.440, 94.428, 94.414, 94.404, 94.390, 94.380, 94.369, 94.359, 94.349, 94.339], [94.265, 94.254, 94.246, 94.237, 94.229, 94.223, 94.215, 94.212, 94.207, 94.204, 94.202, 94.200, 94.201, 94.200, 94.202, 94.204, 94.207, 94.212, 94.215, 94.223, 94.229, 94.237, 94.246, 94.254, 94.265, 94.274, 94.287, 94.298, 94.312, 94.325, 94.339, 94.354, 94.368, 94.385, 94.399, 94.417, 94.432, 94.451, 94.465, 94.486, 94.501, 94.521, 94.537, 94.559, 94.578, 94.602, 94.622, 94.646, 94.665, 94.690, 94.708, 94.733, 94.750, 94.774, 94.792, 94.815, 94.832, 94.854, 94.871, 94.891, 94.908, 94.926, 94.943, 94.958, 94.975, 94.988, 95.005, 95.015, 95.032, 95.042, 95.055, 95.066, 95.075, 95.086, 95.092, 95.103, 95.106, 95.116, 95.119, 95.125, 95.129, 95.131, 95.134, 95.133, 95.136, 95.133, 95.134, 95.131, 95.129, 95.125, 95.119, 95.116, 95.106, 95.103, 95.092, 95.086, 95.075, 95.066, 95.055, 95.042, 95.032, 95.015, 95.005, 94.988, 94.975, 94.958, 94.943, 94.926, 94.908, 94.891, 94.871, 94.854, 94.832, 94.815, 94.792, 94.774, 94.750, 94.733, 94.708, 94.690, 94.665, 94.646, 94.622, 94.602, 94.578, 94.559, 94.537, 94.521, 94.501, 94.486, 94.465, 94.451, 94.432, 94.417, 94.399, 94.385, 94.368, 94.354, 94.339, 94.325, 94.312, 94.298, 94.287, 94.274], [94.193, 94.181, 94.169, 94.161, 94.149, 94.144, 94.135, 94.131, 94.125, 94.121, 94.120, 94.116, 94.118, 94.116, 94.120, 94.121, 94.125, 94.131, 94.135, 94.144, 94.149, 94.161, 94.169, 94.181, 94.193, 94.205, 94.220, 94.232, 94.249, 94.262, 94.282, 94.297, 94.317, 94.334, 94.354, 94.373, 94.393, 94.413, 94.433, 94.455, 94.475, 94.498, 94.518, 94.542, 94.561, 94.585, 94.605, 94.629, 94.649, 94.673, 94.697, 94.723, 94.746, 94.772, 94.795, 94.819, 94.843, 94.865, 94.888, 94.908, 94.931, 94.948, 94.972, 94.986, 95.009, 95.023, 95.044, 95.058, 95.075, 95.089, 95.103, 95.116, 95.126, 95.140, 95.146, 95.160, 95.164, 95.175, 95.180, 95.186, 95.191, 95.193, 95.197, 95.195, 95.200, 95.195, 95.197, 95.193, 95.191, 95.186, 95.180, 95.175, 95.164, 95.160, 95.146, 95.140, 95.126, 95.116, 95.103, 95.089, 95.075, 95.058, 95.044, 95.023, 95.009, 94.986, 94.972, 94.948, 94.931, 94.908, 94.888, 94.865, 94.843, 94.819, 94.795, 94.772, 94.746, 94.723, 94.697, 94.673, 94.649, 94.629, 94.605, 94.585, 94.561, 94.542, 94.518, 94.498, 94.475, 94.455, 94.433, 94.413, 94.393, 94.373, 94.354, 94.334, 94.317, 94.297, 94.282, 94.262, 94.249, 94.232, 94.220, 94.205], [94.115, 94.103, 94.087, 94.079, 94.065, 94.059, 94.050, 94.046, 94.041, 94.036, 94.035, 94.030, 94.033, 94.030, 94.035, 94.036, 94.041, 94.046, 94.050, 94.059, 94.065, 94.079, 94.087, 94.103, 94.115, 94.130, 94.146, 94.161, 94.180, 94.196, 94.218, 94.234, 94.259, 94.276, 94.302, 94.321, 94.347, 94.369, 94.395, 94.418, 94.444, 94.468, 94.494, 94.518, 94.544, 94.570, 94.596, 94.621, 94.647, 94.671, 94.698, 94.721, 94.748, 94.770, 94.796, 94.818, 94.846, 94.868, 94.898, 94.918, 94.948, 94.965, 94.994, 95.012, 95.037, 95.055, 95.077, 95.094, 95.112, 95.130, 95.144, 95.161, 95.171, 95.188, 95.194, 95.211, 95.217, 95.228, 95.234, 95.241, 95.247, 95.249, 95.255, 95.251, 95.257, 95.251, 95.255, 95.249, 95.247, 95.241, 95.234, 95.228, 95.217, 95.211, 95.194, 95.188, 95.171, 95.161, 95.144, 95.130, 95.112, 95.094, 95.077, 95.055, 95.037, 95.012, 94.994, 94.965, 94.948, 94.918, 94.898, 94.868, 94.846, 94.818, 94.796, 94.770, 94.748, 94.721, 94.698, 94.671, 94.647, 94.621, 94.596, 94.570, 94.544, 94.518, 94.494, 94.468, 94.444, 94.418, 94.395, 94.369, 94.347, 94.321, 94.302, 94.276, 94.259, 94.234, 94.218, 94.196, 94.180, 94.161, 94.146, 94.130], [94.043, 94.033, 94.016, 94.010, 93.996, 93.990, 93.980, 93.975, 93.969, 93.963, 93.963, 93.957, 93.960, 93.957, 93.963, 93.963, 93.969, 93.975, 93.980, 93.990, 93.996, 94.010, 94.016, 94.033, 94.043, 94.061, 94.074, 94.092, 94.109, 94.127, 94.148, 94.168, 94.195, 94.215, 94.244, 94.264, 94.296, 94.317, 94.350, 94.373, 94.406, 94.430, 94.463, 94.488, 94.521, 94.547, 94.580, 94.605, 94.638, 94.663, 94.696, 94.720, 94.753, 94.776, 94.809, 94.830, 94.863, 94.883, 94.915, 94.935, 94.964, 94.984, 95.011, 95.032, 95.058, 95.081, 95.103, 95.125, 95.143, 95.165, 95.178, 95.201, 95.208, 95.231, 95.238, 95.256, 95.264, 95.276, 95.283, 95.290, 95.298, 95.299, 95.306, 95.301, 95.309, 95.301, 95.306, 95.299, 95.298, 95.290, 95.283, 95.276, 95.264, 95.256, 95.238, 95.231, 95.208, 95.201, 95.178, 95.165, 95.143, 95.125, 95.103, 95.081, 95.058, 95.032, 95.011, 94.984, 94.964, 94.935, 94.915, 94.883, 94.863, 94.830, 94.809, 94.776, 94.753, 94.720, 94.696, 94.663, 94.638, 94.605, 94.580, 94.547, 94.521, 94.488, 94.463, 94.430, 94.406, 94.373, 94.350, 94.317, 94.296, 94.264, 94.244, 94.215, 94.195, 94.168, 94.148, 94.127, 94.109, 94.092, 94.074, 94.061], [93.974, 93.965, 93.945, 93.938, 93.922, 93.915, 93.905, 93.898, 93.892, 93.885, 93.884, 93.877, 93.882, 93.877, 93.884, 93.885, 93.892, 93.898, 93.905, 93.915, 93.922, 93.938, 93.945, 93.965, 93.974, 93.996, 94.010, 94.032, 94.049, 94.071, 94.093, 94.115, 94.139, 94.161, 94.188, 94.211, 94.240, 94.263, 94.299, 94.324, 94.362, 94.387, 94.426, 94.451, 94.492, 94.516, 94.557, 94.582, 94.623, 94.648, 94.688, 94.713, 94.753, 94.777, 94.815, 94.840, 94.876, 94.901, 94.935, 94.959, 94.990, 95.015, 95.042, 95.067, 95.091, 95.115, 95.135, 95.160, 95.175, 95.200, 95.211, 95.235, 95.243, 95.267, 95.277, 95.295, 95.305, 95.317, 95.326, 95.333, 95.342, 95.343, 95.352, 95.346, 95.355, 95.346, 95.352, 95.343, 95.342, 95.333, 95.326, 95.317, 95.305, 95.295, 95.277, 95.267, 95.243, 95.235, 95.211, 95.200, 95.175, 95.160, 95.135, 95.115, 95.091, 95.067, 95.042, 95.015, 94.990, 94.959, 94.935, 94.901, 94.876, 94.840, 94.815, 94.777, 94.753, 94.713, 94.688, 94.648, 94.623, 94.582, 94.557, 94.516, 94.492, 94.451, 94.426, 94.387, 94.362, 94.324, 94.299, 94.263, 94.240, 94.211, 94.188, 94.161, 94.139, 94.115, 94.093, 94.071, 94.049, 94.032, 94.010, 93.996], [93.899, 93.890, 93.869, 93.860, 93.843, 93.835, 93.824, 93.815, 93.809, 93.800, 93.801, 93.792, 93.798, 93.792, 93.801, 93.800, 93.809, 93.815, 93.824, 93.835, 93.843, 93.860, 93.869, 93.890, 93.899, 93.926, 93.939, 93.966, 93.983, 94.010, 94.032, 94.059, 94.084, 94.111, 94.140, 94.167, 94.198, 94.225, 94.259, 94.286, 94.322, 94.349, 94.386, 94.413, 94.456, 94.486, 94.529, 94.559, 94.602, 94.632, 94.675, 94.704, 94.746, 94.776, 94.816, 94.845, 94.883, 94.913, 94.948, 94.978, 95.010, 95.039, 95.068, 95.097, 95.122, 95.151, 95.171, 95.201, 95.215, 95.245, 95.255, 95.284, 95.294, 95.318, 95.328, 95.346, 95.356, 95.368, 95.378, 95.384, 95.394, 95.394, 95.403, 95.397, 95.407, 95.397, 95.403, 95.394, 95.394, 95.384, 95.378, 95.368, 95.356, 95.346, 95.328, 95.318, 95.294, 95.284, 95.255, 95.245, 95.215, 95.201, 95.171, 95.151, 95.122, 95.097, 95.068, 95.039, 95.010, 94.978, 94.948, 94.913, 94.883, 94.845, 94.816, 94.776, 94.746, 94.704, 94.675, 94.632, 94.602, 94.559, 94.529, 94.486, 94.456, 94.413, 94.386, 94.349, 94.322, 94.286, 94.259, 94.225, 94.198, 94.167, 94.140, 94.111, 94.084, 94.059, 94.032, 94.010, 93.983, 93.966, 93.939, 93.926], [93.821, 93.810, 93.787, 93.776, 93.759, 93.748, 93.737, 93.726, 93.721, 93.710, 93.711, 93.701, 93.708, 93.701, 93.711, 93.710, 93.721, 93.726, 93.737, 93.748, 93.759, 93.776, 93.787, 93.810, 93.821, 93.849, 93.862, 93.894, 93.911, 93.943, 93.965, 93.997, 94.023, 94.056, 94.085, 94.117, 94.150, 94.182, 94.218, 94.250, 94.287, 94.320, 94.359, 94.391, 94.432, 94.464, 94.505, 94.537, 94.578, 94.610, 94.654, 94.690, 94.733, 94.768, 94.809, 94.845, 94.884, 94.919, 94.955, 94.990, 95.023, 95.058, 95.087, 95.122, 95.146, 95.181, 95.200, 95.236, 95.249, 95.285, 95.296, 95.328, 95.340, 95.365, 95.377, 95.396, 95.407, 95.420, 95.432, 95.437, 95.449, 95.448, 95.460, 95.451, 95.463, 95.451, 95.460, 95.448, 95.449, 95.437, 95.432, 95.420, 95.407, 95.396, 95.377, 95.365, 95.340, 95.328, 95.296, 95.285, 95.249, 95.236, 95.200, 95.181, 95.146, 95.122, 95.087, 95.058, 95.023, 94.990, 94.955, 94.919, 94.884, 94.845, 94.809, 94.768, 94.733, 94.690, 94.654, 94.610, 94.578, 94.537, 94.505, 94.464, 94.432, 94.391, 94.359, 94.320, 94.287, 94.250, 94.218, 94.182, 94.150, 94.117, 94.085, 94.056, 94.023, 93.997, 93.965, 93.943, 93.911, 93.894, 93.862, 93.849], [93.737, 93.724, 93.700, 93.687, 93.669, 93.656, 93.645, 93.632, 93.627, 93.615, 93.617, 93.605, 93.614, 93.605, 93.617, 93.615, 93.627, 93.632, 93.645, 93.656, 93.669, 93.687, 93.700, 93.724, 93.737, 93.767, 93.780, 93.816, 93.833, 93.871, 93.892, 93.930, 93.956, 93.994, 94.024, 94.062, 94.095, 94.134, 94.170, 94.208, 94.247, 94.285, 94.325, 94.363, 94.405, 94.443, 94.485, 94.524, 94.566, 94.604, 94.646, 94.684, 94.724, 94.763, 94.801, 94.840, 94.878, 94.920, 94.956, 94.997, 95.030, 95.071, 95.099, 95.141, 95.164, 95.206, 95.223, 95.265, 95.279, 95.318, 95.332, 95.365, 95.379, 95.406, 95.420, 95.439, 95.453, 95.466, 95.480, 95.485, 95.498, 95.496, 95.510, 95.500, 95.514, 95.500, 95.510, 95.496, 95.498, 95.485, 95.480, 95.466, 95.453, 95.439, 95.420, 95.406, 95.379, 95.365, 95.332, 95.318, 95.279, 95.265, 95.223, 95.206, 95.164, 95.141, 95.099, 95.071, 95.030, 94.997, 94.956, 94.920, 94.878, 94.840, 94.801, 94.763, 94.724, 94.684, 94.646, 94.604, 94.566, 94.524, 94.485, 94.443, 94.405, 94.363, 94.325, 94.285, 94.247, 94.208, 94.170, 94.134, 94.095, 94.062, 94.024, 93.994, 93.956, 93.930, 93.892, 93.871, 93.833, 93.816, 93.780, 93.767], [93.659, 93.645, 93.621, 93.608, 93.591, 93.577, 93.566, 93.552, 93.549, 93.535, 93.538, 93.524, 93.535, 93.524, 93.538, 93.535, 93.549, 93.552, 93.566, 93.577, 93.591, 93.608, 93.621, 93.645, 93.659, 93.688, 93.702, 93.737, 93.751, 93.793, 93.813, 93.857, 93.882, 93.927, 93.957, 94.001, 94.034, 94.079, 94.116, 94.160, 94.199, 94.244, 94.285, 94.330, 94.372, 94.417, 94.460, 94.505, 94.548, 94.592, 94.635, 94.679, 94.721, 94.765, 94.804, 94.849, 94.885, 94.930, 94.963, 95.008, 95.037, 95.082, 95.107, 95.154, 95.175, 95.224, 95.240, 95.288, 95.304, 95.346, 95.362, 95.397, 95.413, 95.441, 95.457, 95.477, 95.493, 95.505, 95.522, 95.526, 95.542, 95.538, 95.555, 95.543, 95.559, 95.543, 95.555, 95.538, 95.542, 95.526, 95.522, 95.505, 95.493, 95.477, 95.457, 95.441, 95.413, 95.397, 95.362, 95.346, 95.304, 95.288, 95.240, 95.224, 95.175, 95.154, 95.107, 95.082, 95.037, 95.008, 94.963, 94.930, 94.885, 94.849, 94.804, 94.765, 94.721, 94.679, 94.635, 94.592, 94.548, 94.505, 94.460, 94.417, 94.372, 94.330, 94.285, 94.244, 94.199, 94.160, 94.116, 94.079, 94.034, 94.001, 93.957, 93.927, 93.882, 93.857, 93.813, 93.793, 93.751, 93.737, 93.702, 93.688], [93.585, 93.569, 93.544, 93.528, 93.511, 93.495, 93.484, 93.468, 93.465, 93.449, 93.454, 93.438, 93.450, 93.438, 93.454, 93.449, 93.465, 93.468, 93.484, 93.495, 93.511, 93.528, 93.544, 93.569, 93.585, 93.616, 93.632, 93.670, 93.686, 93.729, 93.746, 93.794, 93.816, 93.864, 93.890, 93.938, 93.968, 94.019, 94.055, 94.107, 94.146, 94.198, 94.239, 94.290, 94.333, 94.385, 94.428, 94.480, 94.523, 94.575, 94.617, 94.669, 94.710, 94.762, 94.801, 94.853, 94.889, 94.941, 94.973, 95.025, 95.053, 95.105, 95.129, 95.181, 95.199, 95.251, 95.268, 95.315, 95.332, 95.373, 95.390, 95.424, 95.441, 95.469, 95.488, 95.509, 95.527, 95.539, 95.558, 95.561, 95.580, 95.575, 95.593, 95.579, 95.598, 95.579, 95.593, 95.575, 95.580, 95.561, 95.558, 95.539, 95.527, 95.509, 95.488, 95.469, 95.441, 95.424, 95.390, 95.373, 95.332, 95.315, 95.268, 95.251, 95.199, 95.181, 95.129, 95.105, 95.053, 95.025, 94.973, 94.941, 94.889, 94.853, 94.801, 94.762, 94.710, 94.669, 94.617, 94.575, 94.523, 94.480, 94.428, 94.385, 94.333, 94.290, 94.239, 94.198, 94.146, 94.107, 94.055, 94.019, 93.968, 93.938, 93.890, 93.864, 93.816, 93.794, 93.746, 93.729, 93.686, 93.670, 93.632, 93.616], [93.506, 93.487, 93.462, 93.443, 93.425, 93.407, 93.397, 93.378, 93.376, 93.358, 93.364, 93.345, 93.359, 93.345, 93.364, 93.358, 93.376, 93.378, 93.397, 93.407, 93.425, 93.443, 93.462, 93.487, 93.506, 93.539, 93.557, 93.597, 93.615, 93.661, 93.679, 93.731, 93.751, 93.807, 93.832, 93.887, 93.916, 93.972, 94.004, 94.060, 94.095, 94.151, 94.188, 94.245, 94.288, 94.347, 94.390, 94.449, 94.492, 94.552, 94.594, 94.653, 94.694, 94.753, 94.791, 94.851, 94.886, 94.945, 94.977, 95.036, 95.063, 95.122, 95.144, 95.204, 95.223, 95.279, 95.299, 95.348, 95.368, 95.411, 95.430, 95.466, 95.485, 95.513, 95.533, 95.552, 95.572, 95.583, 95.603, 95.605, 95.625, 95.618, 95.638, 95.623, 95.643, 95.623, 95.638, 95.618, 95.625, 95.605, 95.603, 95.583, 95.572, 95.552, 95.533, 95.513, 95.485, 95.466, 95.430, 95.411, 95.368, 95.348, 95.299, 95.279, 95.223, 95.204, 95.144, 95.122, 95.063, 95.036, 94.977, 94.945, 94.886, 94.851, 94.791, 94.753, 94.694, 94.653, 94.594, 94.552, 94.492, 94.449, 94.390, 94.347, 94.288, 94.245, 94.188, 94.151, 94.095, 94.060, 94.004, 93.972, 93.916, 93.887, 93.832, 93.807, 93.751, 93.731, 93.679, 93.661, 93.615, 93.597, 93.557, 93.539], [93.421, 93.400, 93.374, 93.353, 93.334, 93.313, 93.303, 93.283, 93.281, 93.260, 93.268, 93.247, 93.263, 93.247, 93.268, 93.260, 93.281, 93.283, 93.303, 93.313, 93.334, 93.353, 93.374, 93.400, 93.421, 93.455, 93.476, 93.518, 93.539, 93.587, 93.608, 93.663, 93.684, 93.744, 93.767, 93.831, 93.858, 93.922, 93.953, 94.017, 94.051, 94.115, 94.151, 94.215, 94.253, 94.316, 94.356, 94.419, 94.458, 94.522, 94.564, 94.631, 94.671, 94.738, 94.775, 94.843, 94.877, 94.944, 94.974, 95.041, 95.066, 95.134, 95.156, 95.221, 95.243, 95.302, 95.324, 95.376, 95.398, 95.443, 95.465, 95.501, 95.524, 95.552, 95.574, 95.594, 95.616, 95.627, 95.649, 95.651, 95.673, 95.665, 95.687, 95.670, 95.692, 95.670, 95.687, 95.665, 95.673, 95.651, 95.649, 95.627, 95.616, 95.594, 95.574, 95.552, 95.524, 95.501, 95.465, 95.443, 95.398, 95.376, 95.324, 95.302, 95.243, 95.221, 95.156, 95.134, 95.066, 95.041, 94.974, 94.944, 94.877, 94.843, 94.775, 94.738, 94.671, 94.631, 94.564, 94.522, 94.458, 94.419, 94.356, 94.316, 94.253, 94.215, 94.151, 94.115, 94.051, 94.017, 93.953, 93.922, 93.858, 93.831, 93.767, 93.744, 93.684, 93.663, 93.608, 93.587, 93.539, 93.518, 93.476, 93.455], [93.330, 93.307, 93.280, 93.256, 93.238, 93.214, 93.205, 93.181, 93.181, 93.157, 93.166, 93.143, 93.162, 93.143, 93.166, 93.157, 93.181, 93.181, 93.205, 93.214, 93.238, 93.256, 93.280, 93.307, 93.330, 93.366, 93.390, 93.433, 93.456, 93.507, 93.531, 93.588, 93.612, 93.676, 93.699, 93.768, 93.794, 93.866, 93.896, 93.967, 94.001, 94.072, 94.108, 94.180, 94.217, 94.289, 94.327, 94.398, 94.437, 94.508, 94.546, 94.617, 94.653, 94.725, 94.758, 94.829, 94.861, 94.937, 94.964, 95.041, 95.066, 95.139, 95.164, 95.232, 95.257, 95.318, 95.343, 95.397, 95.422, 95.468, 95.494, 95.531, 95.556, 95.585, 95.610, 95.630, 95.655, 95.665, 95.690, 95.690, 95.716, 95.706, 95.731, 95.711, 95.736, 95.711, 95.731, 95.706, 95.716, 95.690, 95.690, 95.665, 95.655, 95.630, 95.610, 95.585, 95.556, 95.531, 95.494, 95.468, 95.422, 95.397, 95.343, 95.318, 95.257, 95.232, 95.164, 95.139, 95.066, 95.041, 94.964, 94.937, 94.861, 94.829, 94.758, 94.725, 94.653, 94.617, 94.546, 94.508, 94.437, 94.398, 94.327, 94.289, 94.217, 94.180, 94.108, 94.072, 94.001, 93.967, 93.896, 93.866, 93.794, 93.768, 93.699, 93.676, 93.612, 93.588, 93.531, 93.507, 93.456, 93.433, 93.390, 93.366], [93.243, 93.217, 93.192, 93.166, 93.150, 93.124, 93.116, 93.091, 93.092, 93.067, 93.078, 93.053, 93.073, 93.053, 93.078, 93.067, 93.092, 93.091, 93.116, 93.124, 93.150, 93.166, 93.192, 93.217, 93.243, 93.276, 93.302, 93.343, 93.369, 93.422, 93.448, 93.508, 93.535, 93.601, 93.628, 93.700, 93.726, 93.804, 93.832, 93.912, 93.944, 94.024, 94.058, 94.139, 94.175, 94.255, 94.292, 94.372, 94.409, 94.489, 94.525, 94.605, 94.639, 94.720, 94.751, 94.831, 94.859, 94.941, 94.972, 95.057, 95.088, 95.168, 95.199, 95.272, 95.303, 95.368, 95.399, 95.456, 95.488, 95.536, 95.567, 95.606, 95.638, 95.667, 95.701, 95.718, 95.754, 95.759, 95.795, 95.789, 95.825, 95.807, 95.843, 95.813, 95.849, 95.813, 95.843, 95.807, 95.825, 95.789, 95.795, 95.759, 95.754, 95.718, 95.701, 95.667, 95.638, 95.606, 95.567, 95.536, 95.488, 95.456, 95.399, 95.368, 95.303, 95.272, 95.199, 95.168, 95.088, 95.057, 94.972, 94.941, 94.859, 94.831, 94.751, 94.720, 94.639, 94.605, 94.525, 94.489, 94.409, 94.372, 94.292, 94.255, 94.175, 94.139, 94.058, 94.024, 93.944, 93.912, 93.832, 93.804, 93.726, 93.700, 93.628, 93.601, 93.535, 93.508, 93.448, 93.422, 93.369, 93.343, 93.302, 93.276], [93.163, 93.134, 93.108, 93.080, 93.063, 93.035, 93.028, 93.000, 93.003, 92.974, 92.987, 92.959, 92.982, 92.959, 92.987, 92.974, 93.003, 93.000, 93.028, 93.035, 93.063, 93.080, 93.108, 93.134, 93.163, 93.197, 93.226, 93.269, 93.297, 93.349, 93.380, 93.446, 93.477, 93.550, 93.581, 93.661, 93.692, 93.778, 93.812, 93.905, 93.940, 94.037, 94.072, 94.172, 94.206, 94.309, 94.343, 94.446, 94.481, 94.584, 94.619, 94.721, 94.756, 94.856, 94.891, 94.988, 95.022, 95.115, 95.150, 95.238, 95.272, 95.354, 95.389, 95.463, 95.498, 95.565, 95.600, 95.658, 95.693, 95.742, 95.777, 95.817, 95.852, 95.880, 95.915, 95.933, 95.968, 95.975, 96.010, 96.004, 96.039, 96.022, 96.057, 96.029, 96.063, 96.029, 96.057, 96.022, 96.039, 96.004, 96.010, 95.975, 95.968, 95.933, 95.915, 95.880, 95.852, 95.817, 95.777, 95.742, 95.693, 95.658, 95.600, 95.565, 95.498, 95.463, 95.389, 95.354, 95.272, 95.238, 95.150, 95.115, 95.022, 94.988, 94.891, 94.856, 94.756, 94.721, 94.619, 94.584, 94.481, 94.446, 94.343, 94.309, 94.206, 94.172, 94.072, 94.037, 93.940, 93.905, 93.812, 93.778, 93.692, 93.661, 93.581, 93.550, 93.477, 93.446, 93.380, 93.349, 93.297, 93.269, 93.226, 93.197], [93.230, 93.195, 93.166, 93.131, 93.113, 93.078, 93.071, 93.036, 93.041, 93.006, 93.023, 92.988, 93.017, 92.988, 93.023, 93.006, 93.041, 93.036, 93.071, 93.078, 93.113, 93.131, 93.166, 93.195, 93.230, 93.269, 93.304, 93.354, 93.389, 93.447, 93.482, 93.550, 93.584, 93.659, 93.694, 93.776, 93.811, 93.899, 93.934, 94.027, 94.062, 94.159, 94.194, 94.295, 94.329, 94.434, 94.473, 94.579, 94.618, 94.724, 94.763, 94.868, 94.907, 95.010, 95.049, 95.148, 95.187, 95.282, 95.321, 95.411, 95.450, 95.533, 95.572, 95.649, 95.688, 95.756, 95.795, 95.854, 95.893, 95.942, 95.981, 96.020, 96.059, 96.087, 96.126, 96.142, 96.181, 96.186, 96.225, 96.217, 96.256, 96.236, 96.275, 96.243, 96.282, 96.243, 96.275, 96.236, 96.256, 96.217, 96.225, 96.186, 96.181, 96.142, 96.126, 96.087, 96.059, 96.020, 95.981, 95.942, 95.893, 95.854, 95.795, 95.756, 95.688, 95.649, 95.572, 95.533, 95.450, 95.411, 95.321, 95.282, 95.187, 95.148, 95.049, 95.010, 94.907, 94.868, 94.763, 94.724, 94.618, 94.579, 94.473, 94.434, 94.329, 94.295, 94.194, 94.159, 94.062, 94.027, 93.934, 93.899, 93.811, 93.776, 93.694, 93.659, 93.584, 93.550, 93.482, 93.447, 93.389, 93.354, 93.304, 93.269], [93.313, 93.275, 93.246, 93.207, 93.190, 93.152, 93.146, 93.108, 93.115, 93.076, 93.096, 93.057, 93.089, 93.057, 93.096, 93.076, 93.115, 93.108, 93.146, 93.152, 93.190, 93.207, 93.246, 93.275, 93.313, 93.353, 93.392, 93.442, 93.480, 93.540, 93.579, 93.648, 93.686, 93.763, 93.802, 93.886, 93.925, 94.015, 94.054, 94.150, 94.188, 94.289, 94.327, 94.431, 94.470, 94.575, 94.614, 94.721, 94.760, 94.867, 94.905, 95.011, 95.052, 95.157, 95.200, 95.302, 95.345, 95.443, 95.486, 95.578, 95.621, 95.706, 95.749, 95.827, 95.870, 95.939, 95.982, 96.042, 96.085, 96.134, 96.178, 96.216, 96.260, 96.286, 96.330, 96.344, 96.388, 96.390, 96.434, 96.423, 96.467, 96.443, 96.487, 96.449, 96.493, 96.449, 96.487, 96.443, 96.467, 96.423, 96.434, 96.390, 96.388, 96.344, 96.330, 96.286, 96.260, 96.216, 96.178, 96.134, 96.085, 96.042, 95.982, 95.939, 95.870, 95.827, 95.749, 95.706, 95.621, 95.578, 95.486, 95.443, 95.345, 95.302, 95.200, 95.157, 95.052, 95.011, 94.905, 94.867, 94.760, 94.721, 94.614, 94.575, 94.470, 94.431, 94.327, 94.289, 94.188, 94.150, 94.054, 94.015, 93.925, 93.886, 93.802, 93.763, 93.686, 93.648, 93.579, 93.540, 93.480, 93.442, 93.392, 93.353], [93.391, 93.348, 93.320, 93.278, 93.262, 93.219, 93.216, 93.173, 93.183, 93.140, 93.163, 93.120, 93.156, 93.120, 93.163, 93.140, 93.183, 93.173, 93.216, 93.219, 93.262, 93.278, 93.320, 93.348, 93.391, 93.431, 93.473, 93.524, 93.566, 93.627, 93.670, 93.740, 93.782, 93.861, 93.903, 93.990, 94.032, 94.125, 94.168, 94.267, 94.309, 94.412, 94.455, 94.561, 94.604, 94.713, 94.756, 94.866, 94.908, 95.018, 95.061, 95.170, 95.213, 95.319, 95.362, 95.465, 95.508, 95.606, 95.649, 95.741, 95.785, 95.871, 95.919, 95.997, 96.046, 96.115, 96.163, 96.222, 96.271, 96.319, 96.368, 96.404, 96.453, 96.478, 96.527, 96.539, 96.587, 96.587, 96.635, 96.621, 96.670, 96.642, 96.691, 96.649, 96.697, 96.649, 96.691, 96.642, 96.670, 96.621, 96.635, 96.587, 96.587, 96.539, 96.527, 96.478, 96.453, 96.404, 96.368, 96.319, 96.271, 96.222, 96.163, 96.115, 96.046, 95.997, 95.919, 95.871, 95.785, 95.741, 95.649, 95.606, 95.508, 95.465, 95.362, 95.319, 95.213, 95.170, 95.061, 95.018, 94.908, 94.866, 94.756, 94.713, 94.604, 94.561, 94.455, 94.412, 94.309, 94.267, 94.168, 94.125, 94.032, 93.990, 93.903, 93.861, 93.782, 93.740, 93.670, 93.627, 93.566, 93.524, 93.473, 93.431], [93.467, 93.424, 93.397, 93.353, 93.338, 93.295, 93.292, 93.248, 93.258, 93.215, 93.238, 93.195, 93.232, 93.195, 93.238, 93.215, 93.258, 93.248, 93.292, 93.295, 93.338, 93.353, 93.397, 93.424, 93.467, 93.507, 93.550, 93.600, 93.647, 93.708, 93.755, 93.826, 93.873, 93.953, 94.000, 94.087, 94.134, 94.229, 94.276, 94.377, 94.424, 94.530, 94.577, 94.686, 94.733, 94.844, 94.891, 95.004, 95.051, 95.164, 95.211, 95.322, 95.370, 95.478, 95.526, 95.631, 95.678, 95.779, 95.826, 95.920, 95.968, 96.055, 96.103, 96.182, 96.229, 96.300, 96.347, 96.408, 96.455, 96.505, 96.553, 96.591, 96.639, 96.665, 96.716, 96.726, 96.780, 96.775, 96.830, 96.811, 96.865, 96.833, 96.887, 96.840, 96.894, 96.840, 96.887, 96.833, 96.865, 96.811, 96.830, 96.775, 96.780, 96.726, 96.716, 96.665, 96.639, 96.591, 96.553, 96.505, 96.455, 96.408, 96.347, 96.300, 96.229, 96.182, 96.103, 96.055, 95.968, 95.920, 95.826, 95.779, 95.678, 95.631, 95.526, 95.478, 95.370, 95.322, 95.211, 95.164, 95.051, 95.004, 94.891, 94.844, 94.733, 94.686, 94.577, 94.530, 94.424, 94.377, 94.276, 94.229, 94.134, 94.087, 94.000, 93.953, 93.873, 93.826, 93.755, 93.708, 93.647, 93.600, 93.550, 93.507], [93.555, 93.508, 93.481, 93.434, 93.420, 93.373, 93.371, 93.324, 93.337, 93.289, 93.316, 93.268, 93.309, 93.268, 93.316, 93.289, 93.337, 93.324, 93.371, 93.373, 93.420, 93.434, 93.481, 93.508, 93.555, 93.594, 93.642, 93.692, 93.739, 93.801, 93.848, 93.919, 93.966, 94.046, 94.094, 94.182, 94.231, 94.327, 94.379, 94.481, 94.533, 94.641, 94.692, 94.804, 94.855, 94.969, 95.021, 95.136, 95.188, 95.303, 95.355, 95.468, 95.520, 95.631, 95.683, 95.791, 95.843, 95.945, 95.997, 96.093, 96.145, 96.234, 96.286, 96.366, 96.418, 96.489, 96.541, 96.602, 96.654, 96.703, 96.756, 96.793, 96.845, 96.870, 96.923, 96.934, 96.986, 96.984, 97.037, 97.020, 97.073, 97.042, 97.095, 97.049, 97.102, 97.049, 97.095, 97.042, 97.073, 97.020, 97.037, 96.984, 96.986, 96.934, 96.923, 96.870, 96.845, 96.793, 96.756, 96.703, 96.654, 96.602, 96.541, 96.489, 96.418, 96.366, 96.286, 96.234, 96.145, 96.093, 95.997, 95.945, 95.843, 95.791, 95.683, 95.631, 95.520, 95.468, 95.355, 95.303, 95.188, 95.136, 95.021, 94.969, 94.855, 94.804, 94.692, 94.641, 94.533, 94.481, 94.379, 94.327, 94.231, 94.182, 94.094, 94.046, 93.966, 93.919, 93.848, 93.801, 93.739, 93.692, 93.642, 93.594], [93.638, 93.586, 93.561, 93.509, 93.496, 93.445, 93.446, 93.394, 93.410, 93.358, 93.388, 93.336, 93.380, 93.336, 93.388, 93.358, 93.410, 93.394, 93.446, 93.445, 93.496, 93.509, 93.561, 93.586, 93.638, 93.677, 93.728, 93.779, 93.830, 93.892, 93.944, 94.016, 94.067, 94.149, 94.200, 94.290, 94.342, 94.439, 94.491, 94.594, 94.646, 94.754, 94.806, 94.917, 94.972, 95.088, 95.144, 95.261, 95.318, 95.435, 95.492, 95.608, 95.665, 95.778, 95.835, 95.943, 96.001, 96.104, 96.161, 96.258, 96.316, 96.405, 96.462, 96.543, 96.600, 96.671, 96.729, 96.789, 96.846, 96.895, 96.952, 96.988, 97.046, 97.068, 97.126, 97.135, 97.193, 97.187, 97.245, 97.225, 97.283, 97.248, 97.305, 97.255, 97.313, 97.255, 97.305, 97.248, 97.283, 97.225, 97.245, 97.187, 97.193, 97.135, 97.126, 97.068, 97.046, 96.988, 96.952, 96.895, 96.846, 96.789, 96.729, 96.671, 96.600, 96.543, 96.462, 96.405, 96.316, 96.258, 96.161, 96.104, 96.001, 95.943, 95.835, 95.778, 95.665, 95.608, 95.492, 95.435, 95.318, 95.261, 95.144, 95.088, 94.972, 94.917, 94.806, 94.754,
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
