miketaz100/project-scratch/14-build/S0/cart-S0a.md

# Cart S0a: "Does it feel good?" (dish bench + helmet fit test)

**Project SCRATCH · 14-build/S0 · S0 kit engineer · prices checked 2026-10-02 · ship to Naples, FL 34102**

**What this buys.** Everything for:
- **two** dish benches (the frozen V1 and the corrected V2, Director ruling 2026-10-02), each with three spring-loaded drafted-cone nails, on a 7 in ball and then on Michael's crown;
- the hand-rake comparison (a third nail block);
- the helmet, hinge and coin-bag fit test.

Printed parts are listed separately at the end, because what they cost depends on whether Michael owns a printer.

**Price tags.**
- **[cited]**: price seen today on the vendor page or in a search snippet for that exact listing (URL given).
- **[est]**: listing found but no price visible today, so this is an estimate.
- **[verify]**: check before ordering.

Amazon product pages could not be fetched today. Several Amazon prices are therefore [est]. Check them at checkout.

**CF** = carries forward into a later stage. The stage it carries into is named in the "Carries forward" column.

## Totals

| Block | $ |
|---|---|
| A. Dish bench parts (both benches + hand rake) | **≈ $72 lean** (candle wax, rubber bands, household glue, spring kit bought) / $85 full |
| B. Helmet / hinge / coin-bag test | **≈ $38** + Bossard shipping |
| **Parts total** | **≈ $110 lean** / ≈ $123 full |
| Florida sales tax (6 %) | ≈ $7 |
| C. Printing on **his own printer**: about 0.5 kg PLA / PETG (both benches; nails printed on the FDM and sanded) | ≈ $10 [est] |
| **S0a all-in with his own printer** | **≈ $127** |
| Optional: resin nails and plungers via JLC3DP (26 nails, 10 plungers) | + ≈ $20 [est] |
| C. If he has **no** printer | a print service for the V2 deck alone (168 × 168 mm) is about $40–70 [est]: see route 5 |

**On the lean route Michael already has:**
- a rubber band instead of elastic cord;
- candle wax instead of the PTFE spray;
- household superglue.

**The spring kit (A4) is now needed.** Nine nail springs, for three blocks, is more than old pens can supply.

**Verdict against the Director's ≈ $130 ceiling.**
- **About $127 all-in with his own printer**, with FDM nails sanded per guide D1.
- Resin nails are optional (+ ≈ $20). Michael's call after the first evening.
- **Without a printer, the honest answer is to buy one.** Bambu Lab A1 mini **$219** on sale [cited]. The V2 deck alone is a 12-hour, 168 mm print, and the spec plans home FDM iteration for Stages A–B anyway.

## A. Dish bench

| # | Item | Vendor and listing | Qty | Price | Tag | Carries forward | Substitute |
|---|---|---|---|---|---|---|---|
| A1 | Acetal (POM, Delrin) balls, 6 mm, 10 pcs. The "domes" that ride the dish: **6 needed** (3 per bench). | Amazon, elephrun 6 mm POM balls, [B08F3Z75X3](https://www.amazon.com/dp/B08F3Z75X3) | 1 pack | ≈ $7 | [est] (same listing $3.65 + ship on eBay [cited]) | **CF Stage A**: pad domes, spec §4.2 | USA Sealing 1/4 in acetal balls, 100 pcs, **$5.90** [cited], xoindustrial.com. 1/4 in (6.35 mm) works: the dish is 0.18 mm higher, ignore. |
| A2 | Dry PTFE lubricant spray, for the dish pockets. The spec's PTFE **film** does not lie flat in the bench's small curved pockets, so the film moves to the Stage A cart. | Walmart / Home Depot, "WD-40 Specialist Dry Lube with PTFE" or similar | 1 | ≈ $7 | [est] | bench (the rest of the can is used on the Stage A drums and carriage) | **Lean: $0.** Rub plain paraffin or an unscented candle into the sanded pockets, then buff. |
| A3 | 7 in (178 mm) rubber playground ball: the crown stand-in | Walmart, Cannon Sports 7 in playground ball, [548592900](https://www.walmart.com/ip/548592900) | 1 | **$10.95** | [cited] | bench only | Voit 7 in, $13.64 [cited]. A 6 in craft foam ball is too small (the nails bottom). |
| A4 | Small compression spring assortment: 0.3 / 0.4 / 0.5 mm wire, 4–6 mm OD, 10–30 mm long. The nail springs: **9 needed**. | Amazon, spring kit [B0CMPQ2PQR](https://www.amazon.com/dp/B0CMPQ2PQR) | 1 | ≈ $10 | [est] | bench only | uxcell 0.3 × 4 × 25 mm, 20 pcs, [B076LZ9YLH](https://www.amazon.com/dp/B076LZ9YLH), ≈ $7 [est] |
| A5 | Neodymium discs, 3 × 2 mm, N52, 100 pcs. The nail breakaway (safety ruling C1). | Amazon, [B079P6X998](https://www.amazon.com/dp/B079P6X998) | 1 | ≈ $11 | [est] | **CF Stage A**: one per pin, spec §4.1 C1, plus drum index magnets | Magnet Baron 3 × 2 mm, 100 pcs, $15.99 [cited] |
| A6 | Pocket scale, 100 g × 0.01 g. Sets nail force; checks the breakaway. | Walmart, American Weigh Scales AWS-100, [658655000](https://www.walmart.com/ip/658655000) | 1 | **$13.99** | [cited] | **CF tool** (A2 force checks, B2 audit) | Amazon [B003STEJ20](https://www.amazon.com/dp/B003STEJ20), price not seen |
| A7 | M3 socket-head screw and nut kit (M3 × 6…20, nuts, hex keys) | Amazon, e.g. [B0C9SQXQX4](https://www.amazon.com/dp/B0C9SQXQX4) | 1 | ≈ $9 | [cited range $8.99–9.49 for 750-pc kits] | **CF all stages** (spec §5: M3 everywhere) | Any M3 kit that includes **M3 × 12 and M3 × 16** |
| A8 | M3 **set screw** (grub screw) assortment with 4 mm and 6 mm lengths. M3 × 4 = spring preload on the block; M3 × 6 = drum grub screws in S0b. | Amazon, "M3 set screw assortment" | 1 | ≈ $7 | [est] | **CF S0b drums, Stage A** | Skip if the kit in A7 includes set screws |
| A9 | Safety glasses ANSI Z87.1, 2-pack (one for Michael, one for the helper) | Walmart, Hyper Tough 2-pack, [571868188](https://www.walmart.com/ip/571868188) | 1 | **$3.62** | [cited] | **CF Stage B**: glasses are a session rule (spec B6) | |
| A10 | 1 mm round elastic cord. The lift elastic. | Michaels, 1.0 mm clear elastic | 1 | **$3.19** | [cited] | bench only | **Lean: $0.** A thin rubber band (#16 or #33) |
| A11 | Superglue (CA), gel | Walmart / dollar store | 1 | ≈ $3 | [est] | CF | Household |
| — | Household: paper clips (steel), washable markers, printer paper, masking tape, coins (nickels = 5.00 g, pennies = 2.50 g), a small paper cup, rubber bands, **a 3 mm bamboo skewer (the V2 lift rod)**, scissors, ruler, side cutters, phone with 240 fps slow-motion | — | — | $0 | — | — | — |
| | **Subtotal A** | | | **≈ $85 full / ≈ $72 lean (spring kit included)** | | | |

## B. Helmet / hinge / coin-bag test (leap4-E E4 (e))

| # | Item | Vendor and listing | Qty | Price | Tag | Carries forward |
|---|---|---|---|---|---|---|
| B1 | Adult bike helmet **with a rear dial-fit cradle** | Walmart, Schwinn Prospect adult helmet, [499045540](https://www.walmart.com/ip/499045540) | 1 | **$16.67** | [cited] | **CF Stage B/C**: the dial cradle is harvested for the halo (spec §2.1, §13 "bike helmet 20") |
| B2 | Southco **E6-10-101-20** adjustable-torque acetal positioning hinge (0.25 N·m) | Bossard, [e6-10-101-20](https://americas.bossard.com/products/e6-10-101-20-by-southco.html): $7.34 each at qty 1–24, 169 in stock | 2 | **$14.68** | [cited] | **CF Stage B**: these are the SP1 α hinges (spec C23, M2) |
| B3 | Aluminum flat bar 1/2 in × 1/16 in × 36 in. The stick bail. | Home Depot, Everbilt 800217, [204604762](https://www.homedepot.com/p/204604762), pickup in Naples | 1 | **$3.93** | [cited] | test only |
| B4 | Soft tailor's tape measure. Head tape fit (spec V1). | Walmart, 60 in retractable, [708233721](https://www.walmart.com/ip/708233721) | 1 | **$2.99** | [cited] | **CF Stage C fit** |
| — | Household: 6 zip ties, double-sided foam tape, a zip bag and ≈ 340 g of coins (about 60 quarters), a drill with a 7/32 in (5.5 mm) bit if the hinge pads are made from plywood | — | — | $0 | — | — |
| | **Subtotal B** | | | **≈ $38 + Bossard shipping [verify]** | | |

**Southco notes.**
- Southco's own shop lists the hinge at $10.92 [cited snippet]. The Amazon listing [B00FRLZKFW](https://www.amazon.com/dp/B00FRLZKFW) showed no price today. Austin Hardware ($5.70) and First Choice Marine were out of stock [cited].
- If Bossard shipping is over about $10, use Southco's shop. It still comes to about $22 for two.
- Mounting, from the Southco E6 drawing ([e6-at.en.pdf](https://media.southco.com/media/static/Literature/e6-at.en.pdf)):
  - Each leaf has 2 threaded studs, 15.1 mm apart, with nuts supplied.
  - Panel holes are Ø 5.4 mm.
  - The stud thread is [verify] when the hinge arrives.

## C. Printing (pick one route)

**The S0a printed parts:** D01–D18, D21–D24, D27 and H01. That is about **0.5 kg of PLA**, mostly the V2 deck (≈ 150–180 g).

**The nails and plungers:** 26 tiny parts, D04 and D06–D18. Print them in resin, or on the FDM and sand.

**Optional:** D14 side mock; D25 / D26 V2 templates.

Full list, materials and settings: `cad/README.md`.

| Route | What it costs | Notes |
|---|---|---|
| **1. Own FDM printer** | ≈ $10 of PLA/PETG; resin nails optional, + ≈ $20 via route 2 | The V2 deck needs a 168 × 168 mm bed area: an A1 mini (180 mm) fits. |
| **2. JLC3DP** (jlc3dp.com) | FDM PLA parts ≈ $60–110, with the V2 deck alone ≈ $30–50; resin nails and plungers ≈ $10–15; **+40 % US duty** collected at checkout (their FAQ, 2026-03-19) [cited]; DHL ≈ $15–25 [est]. **Total ≈ $110–190** [est]. | SLA from $0.30/part, FDM and MJF from $1/part [cited homepage]. Build 2–3 days + DHL 3–7 days [cited]. You only get a firm price by uploading the STLs. |
| **3. Craftcloud** (US marketplace) | ≈ $8–30 per palm-size FDM part [cited 2026 review]. **Total ≈ $90–150** [est]. | Use it only for one or two urgent parts. |
| **4. Local** | Collier County Public Library offers **no** public 3D printing (in-branch services page lists paper printing only) [cited]. Mission 3D (Naples) quotes on request. FGCU's makerspace is staff/student only. | Phone the Golden Gate branch, (239) 252-4542, to ask about their past "Intro to 3D printing" programme [verify]. |
| **5. Buy a printer** | Bambu Lab A1 mini **$219** (sale; regular $299), free US shipping [cited snippet] + 1 kg PLA ≈ $15–20 [est] | The spec plans home FDM iteration for Stages A–B anyway. Order the resin nails via route 2. |

## Shipping to Naples, FL

- **Walmart**: free shipping over $35 [cited], or same-day pickup. Put A3, A6, A9, B1, B4 and A11 in one Walmart order (≈ $52).
- **Amazon**: free over $35 or with Prime [est]. Put A1, A4, A5, A7 and A8 in one Amazon order (≈ $43; add A2 if you buy the spray online).
- **Home Depot** (B3) and **Michaels** (A10): store pickup.
- **Bossard** (B2): ship-to-home [verify] the shipping cost.

## What carries forward

**Into Stage A–C:** A1, A5, A6, A7, A8, A9, B1, B2, B4. That is about **$77** of the $123.

**Bench-only, about $45:** ball, springs, elastic, lubricant, aluminum bar, glue.

**If S0a says NO-GO**, the money at risk is about $123 plus printing.
