miketaz100/project-scratch/14-build/drivebox/CONFLICTS.md

# DRIVE BOX: conflicts with SYSTEM-SPEC-v3 and the interface tables

**Project SCRATCH · 14-build/drivebox · DRIVE BOX WP · 2026-10-02**

SYSTEM-SPEC-v3.md has not been edited. Each row below states:
- what the spec says;
- what the hardware or a live vendor check shows;
- what this package builds in the meantime.

Rows are ordered by impact. **Owner** is the work package that has to agree before the spec is revised.

| # | Spec says | Found | This package builds | Proposed resolution | Owner |
|---|---|---|---|---|---|
| **C1** | §6, §0, §14 #9: drive box **≤ 2.8 kg** loaded (case ≈ 1.4 kg + contents ≈ 1.2 kg) | **The box comes to ≈ 3.8 kg (3.6–4.0)**; ledger in drivebox.md §9. **Case:** HF lists 3.96 lb shipping, and a user reports "5 pound Apache 2800", so ≈ 1.6 kg empty with the foam removed [est]. **Contents** are ≈ 2.2 kg, not 1.2: 3 steppers 0.42, M8P + CB1 0.17, pneumatics 0.37, tray and panels 0.30, electronics smalls and wiring 0.22, bulkhead 0.14, mounts 0.16, misc 0.4. | The Apache layout as specified | **Relax §6 to ≤ 4.0 kg.** The box sits on a desk, chair back or couch and is never worn; 39 N on two hooks is trivial. Cheap trims, all optional: drop the plywood tray and bolt each module to the case floor (−0.19 kg); print the bulkhead in PETG, pocketed (−0.06); hook plate at 25 % infill (−0.04). The R9 fallback (custom ply box, −0.8 kg, +6 h) stays available if chair-back hanging proves awkward. A5 weighs it. | Director |
| **C2** | §1 C17 / §4.4 / M17: "floating housing-stop plate with a **6 N** spring" **and** pretension **1.5 N per cable** | A floating plate forces ΣT = F_spring. With three cables, 6 N means 2.0 N each, not 1.5. | Two compression springs on the plate rods. Preload is set by the plate's position on the deck scale: **4.5 N total at the W tick** (1.5 N per cable). The barrel adjusters move the plate, and printed shims shift W. | Keep 1.5 N per cable and read "6 N" as "≈ 4.5 N at the working point, adjustable to 6 N". If A3 shows slack cables at 1.5 N (the comparator's −1.2 N threshold leaves only 0.3 N), move to 2.0 N per cable by shimming the springs 6.7 mm. | DRIVE BOX + ELECTRONICS (comparator thresholds) |
| **C3** | §4.4 / T2: housing = "PTFE-lined close-wound coil **≈ 1.2 OD / 0.6 ID**", 1.6 m, ≈ 30 N·mm² | **No stocked product found.** The nearest real part is Motion Dynamics 304V Bowden spring, 1.35 OD / 0.74 ID (Chamfr, $87.70 per 5 × 1.65 m, **out of stock**). PTFE liner 0.6 × 1.0 mm does not fit inside it. The in-stock fallback is **Shimano OT-SP41 4 mm shift housing** ($5.42/m): heavier (≈ 15–20 g/m against ≈ 5 g/m) and roughly 10× stiffer in bending [est]. | Both seat variants in CAD: **DB03** (Ø 2.5 brass-ferrule seat for a micro coil) and **DB03b** (Ø 5.2 seat for SP41 end caps), with matching combs DB05/DB05b | Run the **S0 tendon ink rig** with both housings, as leap4-D (e) already plans. If only SP41 is available, HALO must re-run the head mass (+≈ 20–25 g for 3 × 0.5 m on the head) and C6 (yaw torque ≤ 0.02 N·m). Ask Chamfr/Motion Dynamics for a restock date now. Asahi Intecc and Lake Region make medical coils, but only to a minimum order. | DRIVE BOX + HALO |
| **C4** | §2.1 / §4.4: umbilical and housings **1.6 m** | A housing runs drum plate → box wall 0.13 m → riser to the hanger clip → free loop ≥ 0.45 m → hub, bail and carriage → pad ≈ 0.55 m. With 1.6 m, **the riser can be at most ≈ 0.47 m**. That works with the box hanging on the chair back, but **not on a desk beside the chair** (0.6–0.9 m). | Build sheet for 1.6 m, plus a 1.9 m option | Chair-back is the default placement. For desk use, keep the box ≤ 0.45 m from the clip, or build 1.9 m housings and tubes. Cost of 1.9 m: block stiffness ≈ 1.82 → 1.74 N/mm (still ≥ 1.7, V-T1), and dead band +19 % (compensated). | DRIVE BOX + HALO |
| **C5** | §4.4 / §5.5 / §1 C20: VREF ≤ 0.35 A gives "≤ 5 N cable pull" | 13 N·cm at 1 A × 0.35 A on a 6 mm drum radius is **7.6 N**, not 5 N. The live 17HS08-1004S listing now reads **16 N·cm** (body 21.5 mm, shaft 20 mm, D-cut 16.5 mm), which gives **9.3 N at 0.35 A**. | Nothing (the deck legs give 28 mm of clearance for the longer body) | **Set VREF for ≤ 0.19 A** to meet 5 N with the 16 N·cm motor: 3.0 N·cm holding, against ≈ 1.8 N·cm needed (1.5 N pretension + 1.0 N drag + inertia at 6 mm). Measure the cable pull at stall with a luggage scale at A0/A3. | ELECTRONICS |
| **C6** | §4.4 / V-T1: 1.9 N/mm at the block | The spec's figure leaves out the tension-sensing flexure, which is a series spring. A 17 N/mm tongue gives **≈ 1.82 N/mm**; the fallback 9 N/mm tongue gives **≈ 1.71 N/mm**. | DB03 tongue 2.5 × 6 × 14 mm PETG, ≈ 17 N/mm [est] | Revise the §4.4 figure to 1.8 N/mm. V-T1 (≥ 1.7) still passes. | DRIVE BOX |
| **C7** | §4.4 / V-T5: Hall-flexure resolution 0.1–0.2 N at 280 Hz | **Marginal by arithmetic.** 0.1 N bends the tongue 2.9 µm at the magnet. A DRV5053RA at a 2.5 mm gap from a 3 × 2 N52 sees ≈ 0.11 mT, about 1.2 mV, or ≈ 20 ADS1115 counts at ±2.048 V. The DRV5053's own noise is the same order [VERIFY datasheet]. | Magnet boss and bridge spacers let the gap run 1.5–6.5 mm, so either the RA or the VA variant can be used | Bench it on day 1 of A3 with the nickel calibration (drivebox.md §6.3). **Fallback 1:** print DB03 with a 2.0 mm tongue (T_T = 2.0): 2× the signal, block 1.71 N/mm. **Fallback 2:** a TAL221 100 g–1 kg mini load cell under each seat, read by the ADS1115 through an INA-class amplifier. | DRIVE BOX + ELECTRONICS |
| **C8** | §1 C10, §2.3: R1b and R2b "different make ≈ 24 kPa" | **No off-the-shelf 3.5 psi relief from another maker found.** Generant VRV (1/8 NPT, factory preset 0.5–150 psi) and Smart Products 300-series both need a quote. Halkey-Roberts' 2.5 psi part is an inflatable-boat valve. | Mount points and adapters for any 1/8 NPT relief | **Ask Generant for VRV-?-3.5 psi (×2) this week**, because this blocks Cart 2. Interim for A1 bench work only: a second McMaster 4277T51 (same make, so the diversity requirement is not met). The diverse part must be in before Stage B sessions. | DRIVE BOX + BOM |
| **C9** | §1 C10 / V12: P3 palm-pump deadhead **≤ 30 kPa**; P1 ≤ 50 kPa | **No 12 V diaphragm pump publishes ≤ 30 kPa.** BODENFLO BD-02A-1L publishes 50 kPa max, 1 L/min, which is exactly P1's limit. | Both pumps are BD-02A-1L. P3 gets a **fixed deadhead-limiting bleed** (a 27G or 25G blunt needle to air at its outlet), sized at A1 so its equilibrium pressure with every relief blocked is ≤ 30 kPa. P1 gets the same if it measures > 50 kPa. | Accept a fixed orifice as the "deadhead" mechanical constant. It cannot be changed by firmware; it can clog, so it sits behind the 10 µm filter and is checked at every A1 re-test. | DRIVE BOX |
| **C10** | §2.1 / §6: user leads "from the **front face**"; vents on "the case ends" | In the Apache 2800 the front wall carries the latches and handle. The M8P (170 × 102.7 mm) only fits **standing against the left end wall**. | User connectors (DC jack, GX12-8 hand controller, GX12-4 e-stop) are on the **left end wall, rear corner**, with the status LED at the left front corner. **Both vents are on the right end wall.** The M8P's top edge is ≈ 10 mm above the base rim, inside the lid's 30 mm. | Read "front face" as "the left end". **Remove the lid foam above the M8P.** | ELECTRONICS |
| **C11** | §6 / M16: "one latched block holds the three push-fits, the tendon hook block and the GX12" | The housings must end on the **floating** plate inside the box (C17), so they cannot be clamped in the block. The GX12 panel socket needs a ≤ 5 mm panel. | The block (DB06/DB07) carries the three air ports (O-ring face seals) and a free-running housing slot. The housing ferrules sit in the floating-plate seats, grouped by the comb DB05. The loop **GX12-4 is a separate wall socket 43 mm below the block** (case Z 25). The block is held by **2 × M4 knurled thumb screws** (≫ 40 N) instead of draw latches. Toggle latches (HJGarden B09FXX532Z) can bolt on later. | Accept. Unpacking: open the lid, lift the comb, unwind and unhook the three drum ferrules, undo the two thumb screws, unplug the GX12. ≈ 3 min. | DRIVE BOX |
| **C12** | §11 HALO: "umbilical clip"; §11 DRIVE BOX: "hanger" | Both packages name a clip | DRIVE BOX builds the **3 N magnetic hanger clip** (DB15/DB16) on a gooseneck | HALO's "umbilical clip" is taken to mean the helmet-side strain relief at the right hub (M15). | HALO |
| **C13** | §13 lists "QEV + float relief" under pneumatics | Both sit on the float, on the head | Not bought or installed here. The P line ends at the umbilical plug. | They move to the HALO cart. | HALO + BOM |
| **C14** | §3.3 / M17: Hall index per drum, "block centred" | One magnet per drum. Cable travel is ±0.47 turn, so the index lies inside the travel but would trigger twice if the drum turned through a full revolution. | One index magnet per drum, at R 12 on the flange underside | Firmware homes each drum **from a fixed direction (wind-in), searching ≤ 0.6 turn toward the last logged angle**, and reverses once if it finds nothing. Drum-to-block offset is trimmed per cable in software. V-T6 measures repeatability. | FIRMWARE |
| **C15** | §1 C14, §9: "groove 2 = pad 2, point mirror" | Pad 2's cable on each drum must leave on the **same tangent side** as pad 1's, or it would wind the wrong way. So the pad-2 seats sit 8 mm **above** pad 1's on the same y. | Row 2 seats and row-2 Hall pockets are in DB03/DB04 (provision, not used) | None needed; record only | DRIVE BOX |
| **C16** | M16: "4 × M5, 200 × 120 mm" | It is ambiguous whether this is the plate size or the bolt pattern | Bolt pattern 200 × 120 through the **lid**, plate 216 × 136 | Accept. The lid needs 4 × Ø 5.5 holes with M5 fender washers inside. | DRIVE BOX |
| **C17** | §5.2: PU 1/8 in × 2 mm ID; "TU0322 class" | SMC TU0322 has no US listing. **SMC TIUB01 is 1/8 in OD × 0.080 in (2.03 mm) ID.** | TIUB01 throughout the 1/8 in system | Accept | — |
| **C18** | §2.3 needles Ø 0.3 (line B) and Ø 0.2 (palm bleed); PAD's gallery bleed Ø 0.15 | The B077WSLCHJ kit runs 14–27G only: no 30G, so no Ø 0.15 | 25G (0.26 mm ID) for the line-B inlet, with 23G as the faster A/B; 27G (0.21 mm) for the palm bleed | **PAD must buy 30G separately** (Ø 0.15 gallery bleed) | PAD |
| **C19** | — (case wall) | Apache end-wall shell thickness and flatness are unknown | DB08 assumes a 3.0 mm wall with a flat 124 × 50 mm patch around the window | Measure on the case; change WALL_T and regenerate. File off any ribs inside the head footprint, or bed the head on a 1 mm silicone gasket. | DRIVE BOX |
| **C20** | §6: "≤ 30 dBA at 1 m" | Phone SPL apps bottom out at about 30–35 dBA, so they cannot verify 30 dBA | — | Pass line for A5: **the reading with the box running is within 3 dB of the room reading**, plus the earplug A/B. | TEST PROTOCOLS |
| **C21** | §4.4 magnets "Ø 3 × 2 N52" | K&J D21B-N52 is 3.18 × 1.59 mm. A 3 × 2 mm N52 Amazon listing was not confirmed. | Pockets Ø 3.4 × 2.2 take either magnet; glue with CA | Accept | — |
