miketaz100/project-scratch/13-outsourcing/build-it-or-hire-it.html

Project Scratch · SP1 Puppet Halo, Lean

# Build It or Hire It

Seven ways to get the lean design onto your head, compared on cash, your own hours, time to the first session, and the chance of a good session. Costs are for the lean design you approved on 2 October: dish-gate pad, cable drive, hand-moved stations, one pad.

The answer first

- Every route has roughly the same chance of a good session within six months, about 20 to 32 %. Two things cap it. First, whether the design feels good on your scalp is about 40 % whoever builds it. Second, hiring does not shorten the calendar.
- What money buys is your time back (about $190 to $250 per hour saved), a better chance of finishing within a year, an independent safety check, and professional CAD you own for a later version or product. It does not buy a better feel or a faster first session.
- The estimator's default: pay an engineer for a design review only, build it yourself, and pay for a short safety check before the first session on your head. About $3,000 to $5,500 all-in.
- Before paying anyone for design work, spend $100 to $200 and a weekend or two on the bench tests. They check whether the dish-gate nail actually feels like a scratch through your hair.

## The comparison

Option | Cash | Your hours | First session | Good session by 6 / 12 months | What you own at the end
Build it yourselffirst-timer | $1,300–1,900 | 120–180 | 4–5.5 months | 25 % / 30 % | the prototype, design files from this project
Build it yourselfexperienced maker | $1,150–1,600 | 85–125 | 3–4 months | 32 % / 35 % | same
Default Paid design review, then you buildplus a short safety check before first use | $2,300–4,400, about $3,000–5,500 with the safety check | 125–185 | 4–6 months | 27 % / 33 % | the prototype, plus an expert's written review
Engineer designs and signs off safety, you build | $9,000–28,000, about $16,000 typical | 105–170 | 4.5–6.5 months | 25 % / 36 % | professional CAD, drawings and firmware you own
Remote engineer plus a local builder | $9,000–30,000, about $17,000 | 50–90 | 5–6.5 months | 20 % / 32 % | prototype plus professional CAD
Engineer who also builds | $15,000–50,000, about $27,000 | 35–60 | 4.5–6 months | 25 % / 38 % | prototype plus professional CAD
Product studio123 Design, Sarasota, if they take it | $30,000–60,000, about $40,000 | 45–75 | 3.5–5 months | 29 % / 37 % | the most complete documentation

All figures are estimates from the project's cost analysis. Your hours include testing and sessions, which you do on every route. A home 3D printer is still worth having: outsourced printing suits finished parts, but without your own printer each design change adds weeks.

## A simple way to decide

If your situation is… | Then
Budget under $5,000 and you enjoy building or are willing to learn | Design review, then build it yourself, with the safety check before first use
Budget under $5,000 and you don't want to build | Hiring isn't affordable at this scope; build with a review anyway, or wait
$5,000–15,000, you'll build, and you want real CAD or a product option | A remote engineer does the detailed design and safety sign-off; you build
$15,000–35,000 and short of time or not keen on building | A local engineer who also builds; fall back to a remote engineer plus local builder
$40,000 or more and you want it turnkey | Ask 123 Design for a quote
Any chance you'd want to sell it someday | At least the engineer-designs route, with native CAD, a signed IP assignment, and nothing shared publicly yet

## What an engineer adds

### Worth paying for

- A hands-on safety review of a device worn on your head, checked on real hardware. This is the one thing building it yourself can't supply. About $1,500–4,000 on its own.
- Catching what this AI program can't see: parts as they actually print, sticky sliding surfaces, creaking cables, cracked joints, awkward handling. A good engineer finds this kind of problem in the first hour of review.
- Real CAD and toleranced drawings, which every later quote and supplier depends on.
- Reliability, so the prototype survives 50 sessions rather than 5.
- A path to a product: automatic drift and the second pad in the next version (roughly $10,000–30,000 of design), then a manufacturable version, typically $50,000–250,000 or more over one to two years.
- IP know-how and suppliers when parts stall or you need 500 of something.

### Not worth paying for

- Before the bench tests pass. Whether the nail feels like a good scratch through your hair costs about $30–45 and a weekend to learn. Spending $10,000 on design first could perfect something that fails on contact.
- To make it feel better. No engineer moves the chance it feels good much above about 40 %; only testing on your head does.
- To get there sooner, or for studio-grade process on a one-off you'll never sell.

A note if you might ever sell it: sharing the design publicly, for example in a build log online, starts the clock on patent rights. Keep it private until you decide, and have anyone you hire sign an IP assignment. A patent attorney consult typically costs a few hundred dollars.

## What I need from you to narrow this down

1. Your budget ceiling for this first build, and separately for a later version or product.
2. Your target date for a first session, and whether six months is a hard line.
3. Your experience with soldering, 3D printing, Linux and air fittings, and whether you enjoy building.
4. Whether you own a 3D printer with a bed of at least 22 cm.
5. Whether you'd ever want to sell it: yes, maybe or never.
6. How far you'd drive to a builder, and whether a builder could work in your apartment.
7. Whether you want an independent safety sign-off before the first session even if you build it yourself. I recommend yes.

Full analysis in the project repo: 13-outsourcing/diy-vs-hire.md and 13-outsourcing/outsourcing-options.md (including a ready-to-post job description and interview questions).
