miketaz100/project-scratch/14-build/S0/build-doc-part1.html

Project Scratch · SP1 · Build part 1 of 2

# Scratch Build Part 1: Does It Feel Good?

The cheap first test. You build two small hand-driven versions of the scratching pad, try them on a ball, then a helper tries them on your head. If they feel like a good scratch, you buy the next round of parts. If not, you've spent about $127 and we fix the nail before building anything bigger.

What you need: about $127 in parts and printing if you have a 3D printer, one helper for a 30-minute session at the end, and about 12–14 hours spread over a long weekend or a few evenings.

- No printer? A Bambu Lab A1 mini is about $219 on sale and is worth it, because the later stages print a lot. Or order prints from a service for about $110–190.
- Two benches: "V1" is built exactly to the original spec. "V2" is the corrected version, with longer, gentler strokes. The test tells us which one to build for real.

0 of 0 done

## Safety first

Stop and lift straight up (never drag sideways) if there is any pain, sting, tug, catch, heat, a missing nail, anything loose, or the bench rocks on your head.

- Glasses on for both of you during the head session, and at the bench when working with springs, magnets or cut wire.
- The helper never presses down. The bench rests on your head by its own weight.
- Count the nails before and after every bout: 3 in, 3 out. A missing nail is in your hair: stop and find it.
- Crown only, at least 3 cm from your hairline, ears and eyes. Clean, dry, combed hair. Not on irritated or sunburnt skin.
- Magnets are a swallowing hazard. Keep the bag sealed, away from children and pets. Count them out and back.
- Superglue: gloves and a damp cloth nearby.
- At most 20 minutes of head contact per day. Any redness should be gone 10 minutes later.

## 1 · Shop

about $110 in parts plus about $7 tax · one Walmart order, one Amazon order, two small hinges from Bossard, Home Depot pickup

| Item | About | Where
| 7 in rubber playground ball (stands in for your head) | $11 | Walmart (https://www.walmart.com/ip/548592900)
| Pocket scale, 100 g × 0.01 g (sets and checks nail force) | $14 | Walmart (https://www.walmart.com/ip/658655000)
| Safety glasses, 2-pack | $4 | Walmart (https://www.walmart.com/ip/571868188)
| Adult bike helmet with a rear dial (we reuse its dial later) | $17 | Walmart (https://www.walmart.com/ip/499045540)
| Soft tailor's tape measure | $3 | Walmart (https://www.walmart.com/ip/708233721)
| Superglue gel (skip if you have some) | $3 | Walmart or any store
| 6 mm Delrin (acetal) balls, pack of 10 | $7 | Amazon (https://www.amazon.com/dp/B08F3Z75X3)
| Small compression spring kit (0.3–0.5 mm wire, 4–6 mm wide) | $10 | Amazon (https://www.amazon.com/dp/B0CMPQ2PQR)
| Neodymium magnets 3 × 2 mm, 100 pack | $11 | Amazon (https://www.amazon.com/dp/B079P6X998)
| M3 screw and nut kit with hex keys (must include M3 × 12 and × 16) | $9 | Amazon (https://www.amazon.com/dp/B0C9SQXQX4)
| M3 set screw (grub screw) assortment with 4 mm lengths | $7 | Amazon, "M3 set screw assortment"
| 2 × Southco E6-10-101-20 friction hinges | $15 | Bossard (https://americas.bossard.com/products/e6-10-101-20-by-southco.html) (or Southco's own shop, about $22 for two)
| Aluminum flat bar, 1/2 in × 1/16 in × 36 in | $4 | Home Depot (https://www.homedepot.com/p/204604762) pickup
| From home: steel paper clips, rubber bands, a candle, masking tape, washable and permanent markers, coins (pennies 2.5 g, nickels 5 g, quarters), paper cup, zip ties, foam tape, a 3 mm bamboo skewer, scissors, side cutters, ruler, 400-grit sandpaper, a phone with slow-motion video | $0 | —
| Recommended: digital caliper (you'll use it in every later stage) | $12 | Harbor Freight 63586

Prices checked 2 October 2026; Amazon prices are estimates, so check at checkout. About $77 of this carries into later stages.

## 2 · Print

about 0.5 kg of PLA or PETG · the big V2 deck is a 12-hour print and needs a bed at least 168 mm square

All print files are in the project folder 14-build/S0/cad/stl/, already oriented to print. Open each in your slicer and print as-is.

1. V1 bench: D01 deck, D02 block ×2 (one is for the hand rake), D03 nose plate ×3, D08 C-arm, D09–D11 templates, D12 skid ring, D13 ball cradle, D15 lift gauge.
2. V2 bench: D21 deck (the big one, print it first), D22 block, D23 C-arm, D24 template. D27 hand-rake handle.
3. Small parts: D04 plungers ×10, D05 seat discs ×10, nails: N20 ×4, N30 ×7, N35 ×7, N45 ×4, N55 ×4. The rings on top of each nail tell you its length (1 ring = N20, up to 5 rings = N55).Nails printed on a normal printer are fine once their tips are sanded (step 5.1). Resin nails are optional, about $20 more from a print service.
4. Helmet test: H01 hinge pad ×2.

## 3 · Measure your head

20 minutes, with your helper

1. Head circumference: tape level, just above the eyebrows and round the widest part of the back.
2. Ear to ear over the top: from where one ear meets the head, over the crown, to the other.
3. Front to back: from between your eyebrows, over the crown, to the bony bump at the back of your skull.
4. Front hairline to the crown swirl.
5. Hair length at the crown (pull a few hairs straight up), and hair thickness: push a toothpick down through the hair to the scalp and note the depth.
6. Look at your crown in a mirror: which way does the hair lie there?

Head circumference (mm) | | Ear to ear (mm)
Front to back (mm) | | Hairline to swirl (mm)
Hair length (mm) | | Hair thickness (mm)
Hair lies toward

## 4 · Helmet and hinge test

1.5 hours to build, then 20 minutes watching TV · tests whether moving the scratcher by hand between bouts is OK

1. Put the helmet on, snug with the rear dial. Have your helper mark a dot on each side, 45 mm straight above your ear opening.
2. Fix one hinge to each printed pad (H01): one leaf on the pad's sticking-out flange, studs through, nuts underneath.Good: the hinge pin points straight out sideways from your head, ear to ear. If it points front-to-back, flip the leaf.
3. Stick each pad on its dot with foam tape, centred, and add two zip ties through the nearest vents.
4. Bend the aluminum bar by hand around a bucket into a hoop that runs from hinge to hinge over the helmet, 3–4 cm clear of it. Trim, drill two 7/32 in holes 15.1 mm apart in each end, and bolt the ends to the free hinge leaves.Good: the hoop swings forward and back and stays wherever you leave it.
5. Tape a bag of about 340 g of coins (about 60 quarters) to the top of the hoop.
6. Wear it with the hoop straight up for 20 minutes of TV without touching it. Then 5 minutes each with it tilted 45° back and 90° back.Pass: it creeps no more than 3°.If it creeps: tighten the hinge's adjustment screw a quarter turn.
7. Eyes closed, move the hoop from straight up to 45° back, 10 times, while your helper times you.Pass: under 3 seconds in at least 8 of 10.

Creep at 0° / 45° / 90° (degrees)
Eyes-closed moves under 3 s (out of 10)
"How much does the weight pull or lean the helmet?" (0–10, pass ≤ 3)
"How much would moving it by hand between bouts bother you?" (0–10, pass ≤ 3)

## 5 · Build the V1 bench

about 4 hours · a still "deck" on three legs, a "block" carrying three spring-loaded nails that rides in dish-shaped pockets under the deck, and a handle that steers it along grooves

Screw holes: small "pilot" holes (2.6 mm) let an M3 screw cut its own thread: turn slowly and stop when snug. If one strips, put a drop of superglue in it, wait 10 minutes, and screw again.

1. Clean the prints. Remove supports; pick strings out of the three pockets under the deck. Each plunger must slide in its block bore under its own weight; each nail must slide through the nose plate. Sand bores lightly round a pencil if they stick.Nail tips: drag each firmly across the back of your hand. It must feel blunt and leave no scratch line. If not, sand the tip rim with 400 grit while rolling the nail.
2. Balls. One small drop of superglue in each of the three sockets on top of the block's posts; press a Delrin ball in. Wipe off any glue: none may stay on the top half.Good: each ball sticks up about 3.6 mm and won't turn.
3. Magnets. Glasses on. One at a time: a pin-head drop of glue in the pocket on the flat end of a plunger, drop in a magnet, press flush. Do 4. Seal the magnet bag.
4. Steel nail tops. Cut 5 mm bits of steel paper clip, one per nail. Glue each into the hole in the ringed top of a nail, then sand flush on sandpaper laid flat.Good: a magnet sticks to the top of every nail.
5. Springs. Pick 3 identical springs about 12 mm long that fit inside a plunger's cup. Cut to length with side cutters.
6. Nail stacks. Block upside down. Into each bore: a seat disc, a spring, then a plunger cup-first. Screw the nose plate on with 3 × M3 × 12, snug. Turn the block over and screw an M3 × 4 set screw into each top hole until flush with the top (never sticking up). Push an N30 nail up into each guide until it clicks onto its magnet.Good: nails hang straight, push up about 6 mm smoothly against the spring, spring back, and pop off with a firm tug.
7. Smooth the pockets. Sand the three pocket floors under the deck lightly with 400 grit, then rub candle wax in and buff.Good: the block slides around inside the upside-down deck with no grabbing or clicking.
8. Lift band and assemble on the ball. Ball in its cradle, masking tape over the top, a small cross at the very top. Push a 25 mm piece of paper clip across the block's centre well and tie a rubber band or elastic to it. Set the block on the ball, nails down, over the cross. Thread the elastic up through the deck's centre hole, lower the deck over the block (feet on the ball, balls up in the pockets), stretch the elastic gently and tie it round a bit of toothpick on top.Good: the block hangs up in the dish by itself, nails resting on the ball. Pushed sideways, it rolls and its nails lift off at the ends.
9. Penny test (the hair-safety breakaway). Take the block out and hold it nose-down. Tie thread round one nail just above the tip, hang a paper cup, add pennies one at a time until the nail drops off. Weigh cup + pennies + thread. Repeat 10 times per nail.Pass: every pull 12–25 g.Over 25 g: one layer of clear tape over that magnet. Under 12 g: sand that nail's steel top flat again.
10. Coin test (how hard each nail presses). Block nose up. Mark each nail where it leaves the nose plate. Balance a bottle cap with Blu-Tack on a tip and add coins until the mark sinks 2 mm.Target: 25–35 g at 2 mm, all three within 5 g. Never above 45 g.Too light: turn that nail's top set screw half a turn clockwise.
11. Template and handle. Screw template T1 onto the deck top (2 × M3 × 8). Slide the C-arm in from the side, its foot against the block's flat ear, and fix with 2 × M3 × 12 using an L-shaped hex key. Drop two M3 × 25 screws, thread first, through the top bar into the template grooves as guide pins.Good: pushing only the round grip at the bottom of the arm, both pins run along the grooves and the nails lift off the tape at each end.
12. Dry run. Push slowly along each groove 5 times. No squeaks or clicks.If the block drops away from the dish at the ends, tie the elastic 3 mm shorter. If it's heavy to push, re-wax.

## 6 · Build the V2 bench and the hand rake

about 2.5 hours · V2 is bigger, its block travels twice as far and tilts at the ends: that's designed

1. Clean the V2 prints as in step 5.1. Glue three balls into the posts on the V2 block's ribs (5.2).
2. Build three nail stacks into the V2 block as in 5.3–5.6, with N35 nails for the ball. Run the penny test and coin test on them.
3. Sand and wax the three big pockets under the V2 deck.
4. Bolt the C-arm to the block first: block upside down, the arm's foot on the rib with two pilot holes, 2 × M3 × 20.
5. Stand the block on the ball. Slide the deck in sideways from the side opposite the arm, between the arm's top and bottom bars, and lower it so its feet land on the ball and the balls go up into the pockets. Screw template D24 on top.
6. Drop an M3 × 60 screw (or a 60 mm bamboo skewer, blunt end down) through the arm's top bar into the groove. Hook a rubber band over its head and down into the two notches at the ends of the bar.Good: the block is pulled up into the dish; pushing the round grip, it rolls and the nails lift at the ends.If the block clunks down at the ends, double the band.
7. Hand rake: build three nail stacks into the second V1 block (no balls needed), run the penny and coin tests, fit the skid ring under the nose plate (3 × M3 × 16) and bolt on the handle (2 × M3 × 12).Good: resting on the ball by its skids, each nail is pushed up about 2 mm.

## 7 · Test both benches on the ball

about 2.5 hours · V1 is expected to give short strokes; that confirms the problem V2 fixes and is not a failure

1. Stroke length. Colour each nail tip with washable marker. Push along the template's 0° groove, end to end, 3 times. Measure the three marks on the tape. Turn the bench 45° on the ball and repeat, for 4 directions.Expected: V1 about 10 mm. V2 about 18.5 mm (pass ≥ 17).
2. Lift at the ends. Hold the arm at the end of a groove and slide the stepped lift gauge under each nail.Pass: at least 5 mm clear on both benches.
3. Hair slip test. Tie a loose loop of a long hair round a nail halfway up, hold the other end, lift the block 10 mm.Pass: the loop slides off the tip 10 out of 10 times, without the nail popping off first.
4. Noise. 20 brisk strokes, ear 30 cm away.Pass: no squeak, click or buzz. Re-wax if there is.
5. Optional: landing angle. Film a stroke in slow motion from the side and step through the last 2 mm before the tip touches.Expected: V1 about 50°, V2 about 30°.

| V1 | V2 | Pass line
Penny test, lowest / highest (g) | | | 12–25 g
Coin test at 2 mm, three nails (g) | | | 25–35 g
Stroke length, 4 directions (mm) | | | V2 ≥ 17
Lift at the ends, smallest (mm) | | | ≥ 5
Hair slip test (out of 10) | | — | 10/10
Noise | | | none
Landing angle (optional, °) | | | V2 ≤ 35

## 8 · The head session

about 30 minutes · you sit with eyes closed and rate; your helper runs it from this page · 8 bouts of 30 seconds

1. Same day, before starting (helper): penny test and coin test on all 9 nails; fingernail test on every tip; 3 nails on each device.If any nail fails the penny test, no session today.
2. Pick nails for your head. Rest each bench gently on the crown. All three tips should touch, each pushed up a little. If a nail hangs free, use the next longer one. Usually N30/N35 on V1 and N45/N55 on V2.If even N55 won't reach on V2, note it and run V2 on the ball only.
3. Roll a die for the order card: 1–2 card 1, 3–4 card 2, 5–6 card 3. You never see it.

Bout | Card 1 | Card 2 | Card 3
1 | V2 | Fingers | Rake
2 | Rake | V1 | V2
3 | V1 | V2 | Fingers
4 | Fingers | Rake | V1
5 | V1 | V2 | Fingers
6 | V2 | Fingers | V1
7 | Fingers | Rake | V2
8 | Rake | V1 | Rake

### Helper: how to run each bout

"Eight short bouts, thirty seconds each, short rests between. Keep your eyes closed. After each one I'll ask seven quick questions. Say stop or lift your hand any time and I'll lift it straight off."

- V1 or V2 bench: rest it on the crown by its own weight, steady it with one hand on the post on top, never pressing. With the other hand push the round grip along the grooves at about one stroke per second: 8 strokes on one line, then move to the next line, through all four.
- Rake: hold the handle, skids on the crown. Stroke about 2.5 cm back and forth, one per second, lifting about 5 mm at each end. Turn 45° every 8 strokes. Never press.
- Fingers: a normal friendly scratch with short clean nails, same pace, same patch.
- At 30 seconds, lift straight off, ask the seven questions, count the nails, rest 30–60 seconds.

Q1"How satisfying was that, as a good scratch? Zero to ten."Q2"Scratch or brush?"Q3"Crisp in both directions?"Q4"Pressure: too light, about right, or too hard?"Q5"Any tug, pull, catch or sting?" If yes: stop.Q6"Machine or person?"Q7"One word for it?"

Bout | Device | Q1 0–10 | Q2 | Q3 | Q4 | Q5 | Q6 | Q7

Card used | | Nails used on head (V1 / V2)
Best overall / worst
Redness after 10 minutes

## 9 · Decide

If… | Then
V2 averages 6 or more, called "scratch" and "crisp both ways" both times, no tugs | GO. Send me your results; I'll lock the corrected shape into the real pad and send part 2 with the next shopping list.
V1 scores 6 or more and at least as well as V2, no tugs | GO with the smaller original pad.
Both benches under 6, but the hand rake 6 or more | GO on the nails, rethink the dish. Send me your results before buying more.
Everything under 6, or mostly "brush", or any tug | Stop here. Buy nothing else. We work on the nail tip, force and pattern first, using your answers.
A bench test failed (breakaway out of range, nails sticking, block falling out of the dish) | Fix that bench and retest. It's not a verdict on the idea.

The fingers are the yardstick: how close the devices come to them tells us a lot.

## 10 · Send me your results

Everything you typed into this page stays in this browser. Press the button and paste the result into our chat.

Copy my results Clear everything
