miketaz100/project-scratch/(commit log)

2026-10-01 Project Scratch: checkpoint 2026-10-01
    [hand_wand_handle.scad, paddle_with_pocket.scad, tip_A45.scad, tip_B45.scad, tip_B45_12.scad, tip_E_carrier.scad, tip_H_ball.scad, tip_P_carrier.scad]
2026-10-01 Tips: tips.md, cad/tips README, 14 STLs, SCAD fixes (A45 bonding face, B45-12 sleeve clash, clamp-bar holes, wand leaf length, print orientation, tip P radius)
    Claude-Session: https://claude.ai/code/session_017YFCyHrWCjSy5zCCPEJhAC
    [hand_wand_clamp_bar.stl, hand_wand_handle.scad, hand_wand_handle.stl, paddle_clamp_bar.stl, paddle_with_pocket.scad, paddle_with_pocket.stl, tip_A45.scad, tip_A45.stl]
2026-10-01 Mechanical: mechanical.md (full design, 48 printed parts); Design Freeze Addendum 1 with director rulings on D1–D13
    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
2026-10-01 Tips follow-up: paddle DRAFT_Y 10, centre-paddle RISER 9, 24 mm pitch gaps verified (≥ 4.48 mm worst case), 15 STLs regenerated
    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
    [paddle_with_pocket.scad, paddle_with_pocket.stl, paddle_with_pocket_riser9.stl, tm1_seam_sleeve.stl]
2026-10-01 BOM: bom.md (rig 03.50 from empty shop, lean 09.50; 19 verify items); addendum D8 post length corrected to 104 mm
    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
2026-10-01 Pause: partial CAD generator committed; RESUME notes for restart
    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
2026-10-01 Local session: package v1, verified BOM, frame/hand CAD (48 STLs), servo alternatives, crown brief; crown-only decision
    [lib_sp1.scad, p01_vesa_adapter.scad, p01_vesa_adapter.stl, p02_p05_p06_p07_hinge_parts.scad, p02_pulley_sheave.stl, p03_electronics_tray.stl, p03_p04_electronics_tray.scad, p04_electronics_tray_lid.stl]
2026-10-02 Crown concepts A–C + comparison page; compact sprint brief; porcupine helmet brief and program plan
2026-10-02 Pin unit design, partial compact-B, leap-round brief; relaunch leap round on Opus 5.5
2026-10-02 Leap round 2: six documents (travel, pad motion, pneumatics, patterns, form factor, skeptic); orbit explainer page
2026-10-02 Decision analysis under amended north star: 6-pin hybrid recommendation
2026-10-02 Decision 3: Puppet Halo Lean (dish gate, tendon puppet, hand-moved stations, Klipper, one pad)
2026-10-02 Build engineering: S0 kit, halo, drive box, electronics+firmware, test protocols (pad pending)
    [D01_dish_deck.stl, D02_dish_block.stl, D03_nose_plate.stl, D04_plunger.stl, D05_seat_disc.stl, D06_nail_N20_reserve2.stl, D07_nail_N30_reserve3.stl, D08_c_arm.stl]
2026-10-02 Build Doc part 1 (S0a first test) checklist page; S0 kit v2 with corrected dish
    [D17_nail_N45_reserve4p5.stl, D18_nail_N55_reserve5p5.stl, D21_V2_dish_deck.stl, D22_V2_block.stl, D23_V2_c_arm.stl, D24_V2_template_T1_line_star.stl, D25_V2_template_T2_dpath.stl, D26_V2_template_T3_circle.stl]
2026-10-02 PAD package; all six build packages delivered
    [PD01_deck.stl, PD02_skirt_frame.stl, PD05_floor_plate.stl, PD06_cartridge.stl, PD07_gallery_plate.stl, PD08_skirt_plate.stl, PD09_piston.stl, PD10_yoke.stl]
